WCTE/WCTE_mPMT_mechanical/mPMT Assembly Interference/Photos/new pillar.PNG

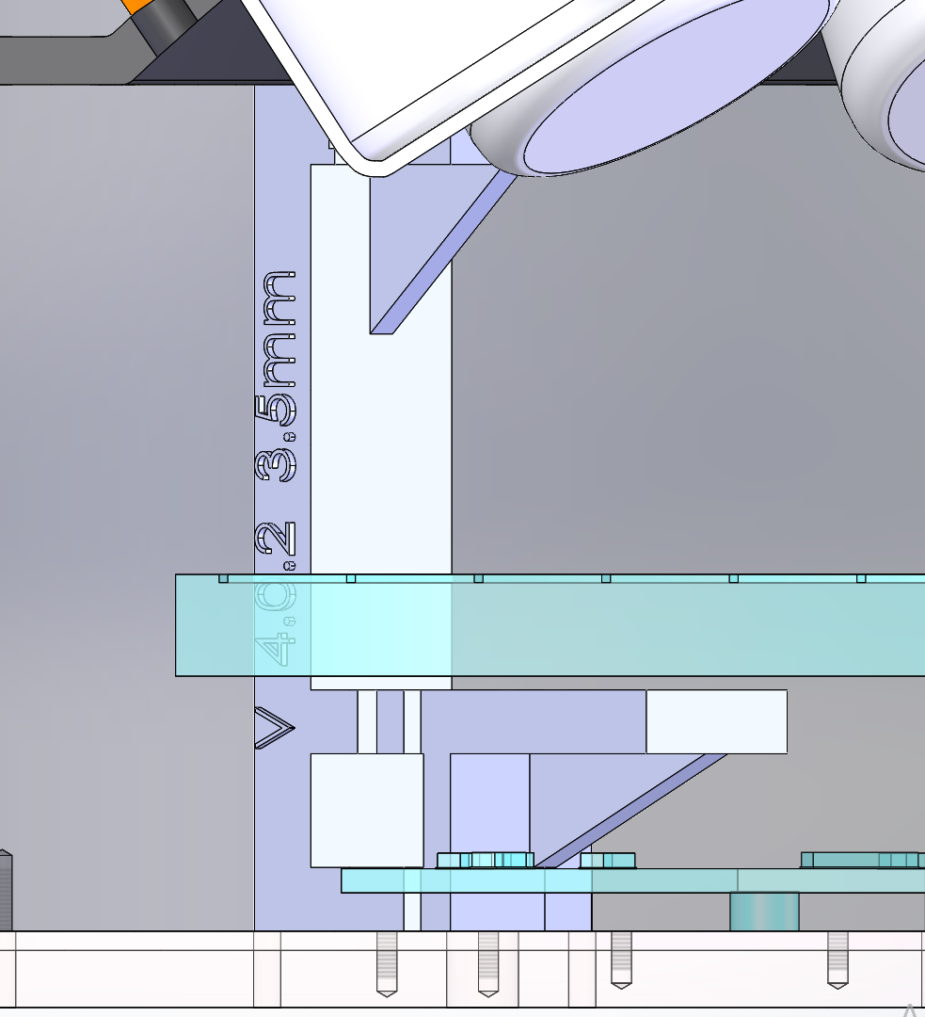
mPMT Assembly Interference/Photos/new pillar.PNG
