WCTE/WCTE_mPMT_mechanical/mPMT Assembly Interference/Photos/Interference new ideal.PNG

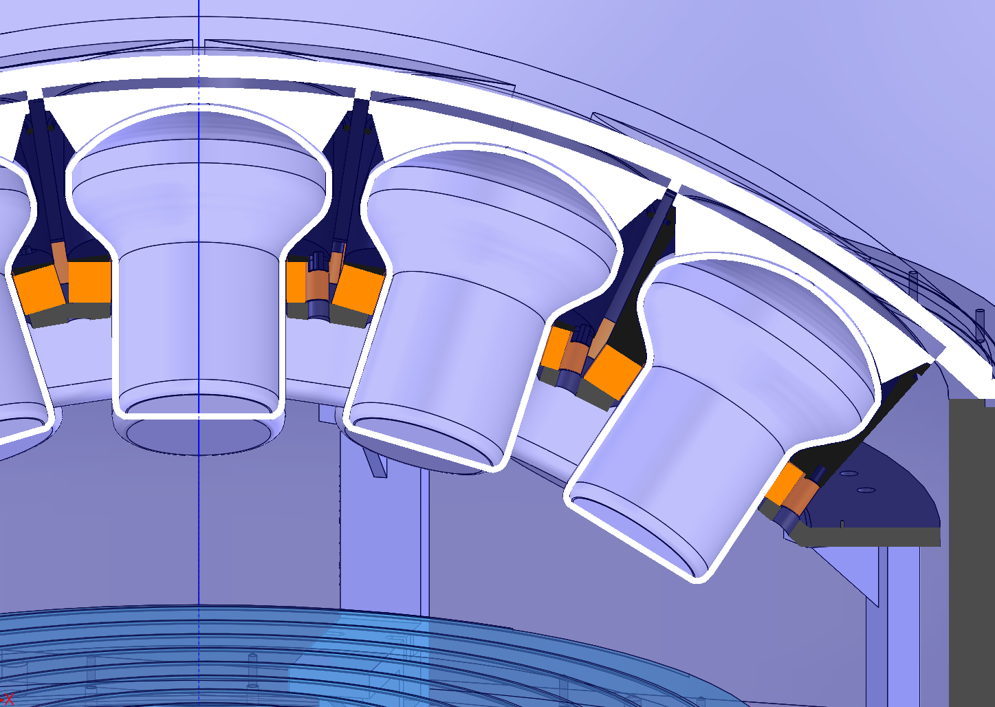
mPMT Assembly Interference/Photos/Interference new ideal.PNG
