WCTE/WCTE_mPMT_mechanical/Feedthrough with M12 connector/readme.md

Improved feedthrough in December 2022. Added a support, a piece of PCB and a M12 connector to the cable. Added an elbow pipe to the backplate of mPMT and redid the M45x3 threads

In this folder you can find the SW parts, SW assembly, a pack-and-go assembly, and a step file.
