WCTE/WCTE_mPMT_mechanical/Quality Control/PMT QC/readme.md

In this folder, you can find parts, assembly, and a pack-and-go .zip of PMT qc.
