WCTE/WCTE_mPMT_mechanical/Dome + Cylinder Lowering Fixture/Dome + Cylinder Lowering Fixture Notes.docx

April 8, 2021

This dome & cylinder lowering fixture is an alternate fixture design for lowering the dome onto the PMTs. In this design, the acrylic dome would first be screwed down onto the PVC cylinder, and now attached acrylic dome and PVC cylinder assembly would be lowered on the PMTs. The lowering mechanism is the same as the current dome lowering jig where turning each of the 4 screws by a quarter turn lowers the assembly by screw threads. This design is intended to be a more robust solution to achieve a better vertical lowering action and removes potential complications from the current dome lowering jig.

TDE2871 are clamp rings that clamp around the PVC cylinder and allow the user to lower the assembly onto TDE2872. TDE2872 are spacer blocks for the assembly to first sit flat and parallel to the stainless steel backplate. Once that is achieved, the 4 wing screws are turned until they make contact with the backplate and support the assembly ever so slightly. The TDE2872 are then removed, and the whole assembly can be lowered by turning the 4 wing screws a quarter turn each.

For this fixture to be made, part drawings for TDE2871 and TDE2872 need to be created and sent to machine shop, and all mechanical hardware needs to be sourced.
