WCTE/WCTE_mPMT_mechanical/Reflector Sheet/Reflector_Diagrams.pdf

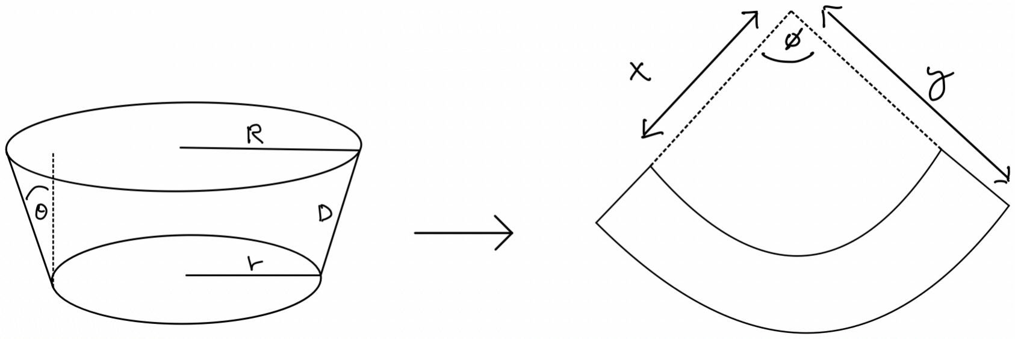
[picture p3: figure]
