WCTE/WCTE_mPMT_mechanical/Gelling Jig Tabbed/Capture2.PNG

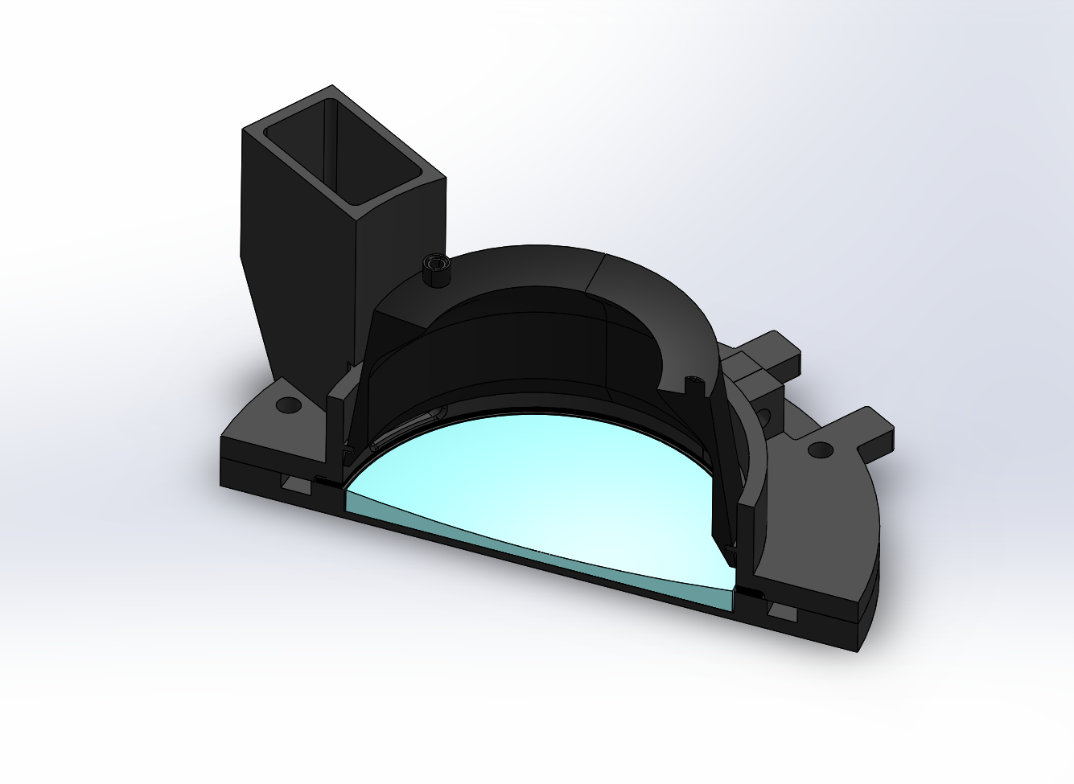
Gelling Jig Tabbed/Capture2.PNG
