WCTE/WCTE_mPMT_mechanical/Gelling Jig Tabbed/Capture3.PNG

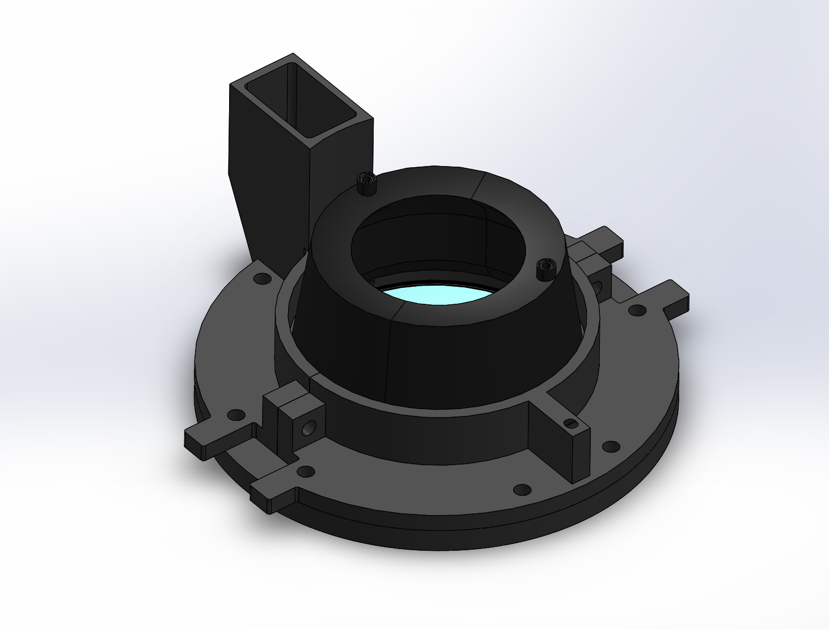
Gelling Jig Tabbed/Capture3.PNG
