WCTE/WCTE_mPMT_mechanical/Gelling Jig Tabbed/Capture4.PNG

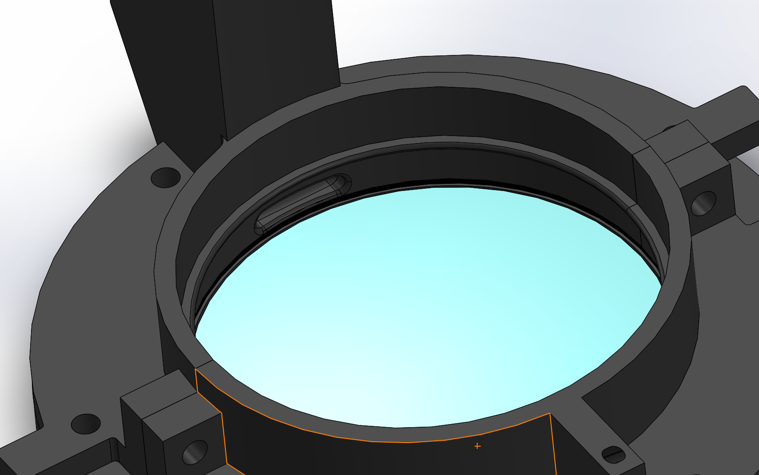
Gelling Jig Tabbed/Capture4.PNG
