WCTE/WCTE_mPMT_mechanical/Gelling Jig Tabbed/Capture5.PNG

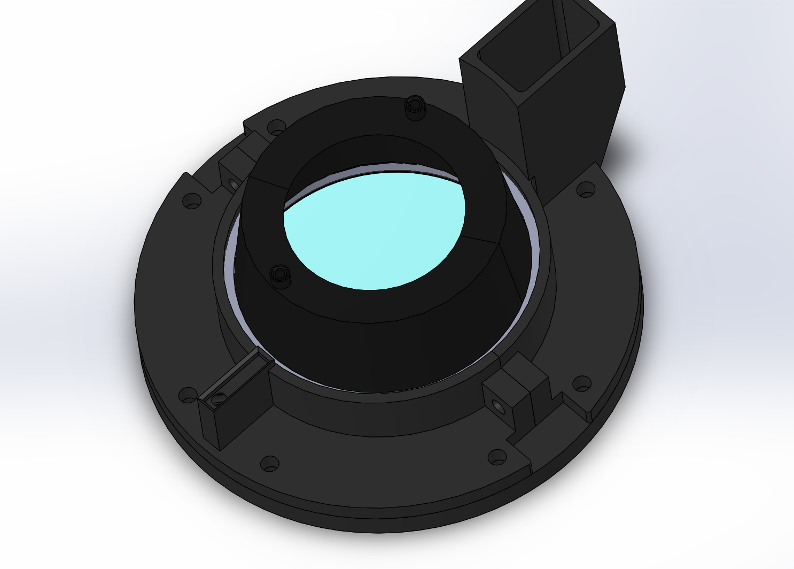
Gelling Jig Tabbed/Capture5.PNG
