WCTE/WCTE_mPMT_mechanical/Gelling Jig Tabbed/Capture6.PNG

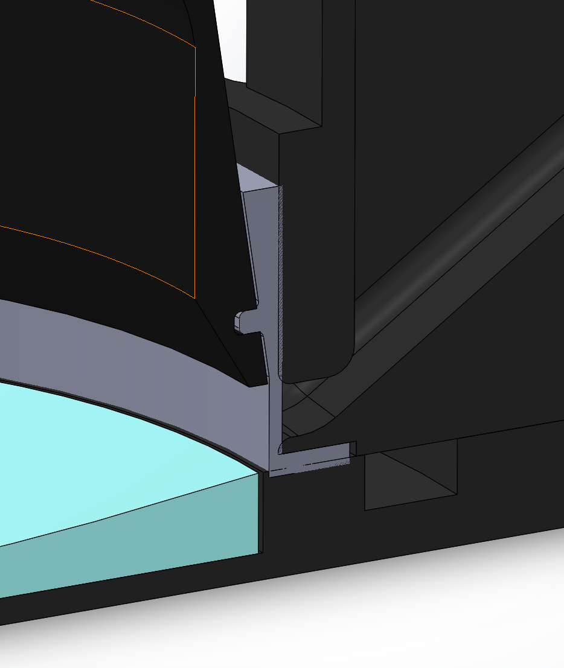
Gelling Jig Tabbed/Capture6.PNG
