WCTE/WCTE_mPMT_mechanical/Gelling Jig Tabbed/Capture7.PNG

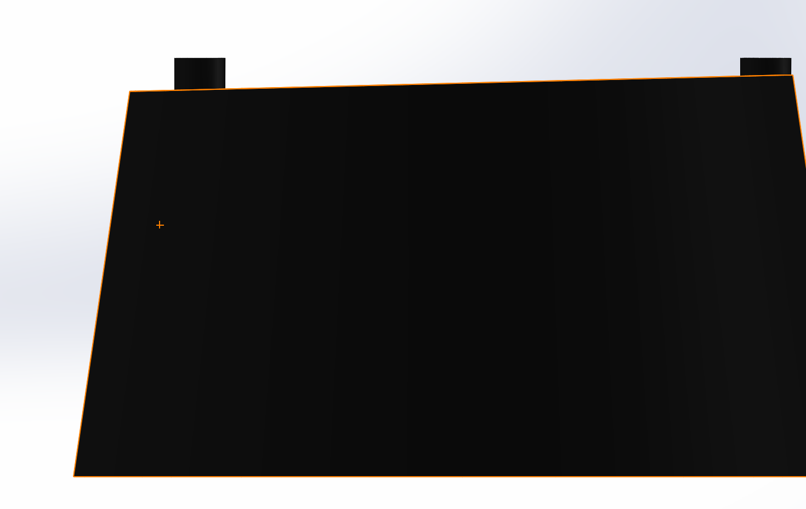
Gelling Jig Tabbed/Capture7.PNG
