WCTE/WCTE_mPMT_mechanical/Gelling Jig Tabbed/Capture.PNG

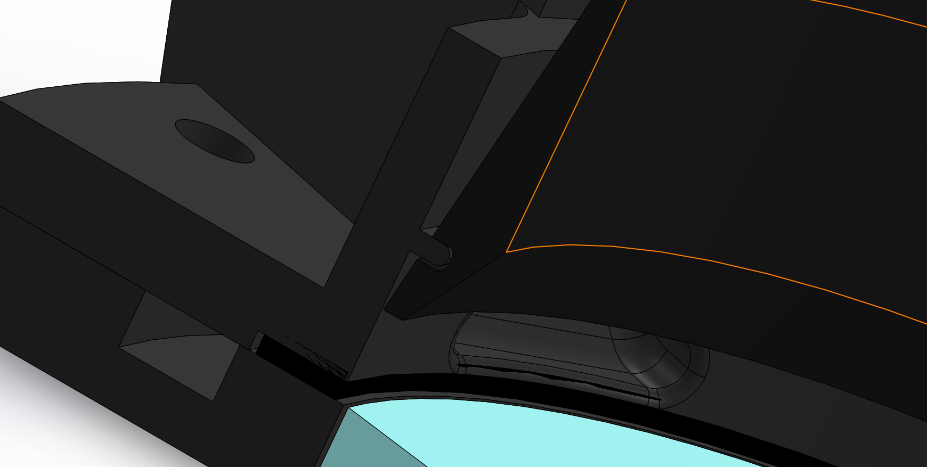
Gelling Jig Tabbed/Capture.PNG
