WCTE/WCTE_mPMT_mechanical/mPMT Assembly Interference/mPMT Assembly faceted actual dimensions.SLDASM

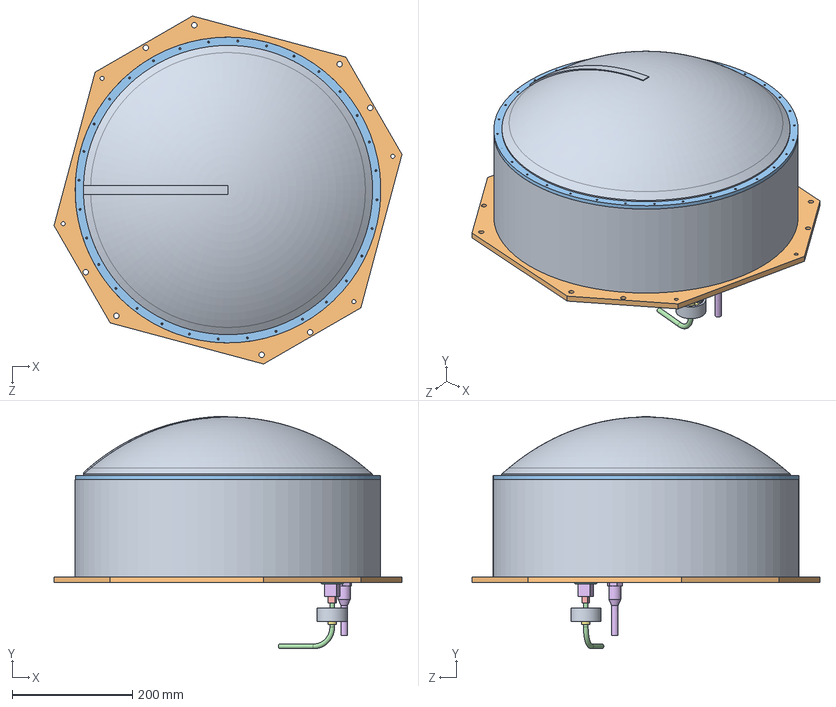
[picture p11: CAD file, 2022-08-09]
mPMT Assembly Interference/mPMT Assembly faceted actual dimensions.SLDASM
578.3 x 386.4 x 578.3 mm
XDE2411
XDE2431
PCB_connector x 20
PCB_SMAport x 2
PCB_FPGA x 5
PCB_SFP
PCB_connector2 x 2
Board^PCB_centralEnclustraModule
central block^PCB_centralEnclustraModule
PCB_standoff x 4
PCB_centralConnector x 3
IWCD_PL_RJ45_Male
IWCD_PL_CRE-CA1184-MGA
Outer Flange
Feed Through Connector Assembly Weld
Flange Cover
End Cap x 2
Adhesive
Bent Cable
RJ-45 Male Port
RJ-45 Female Port
Inner Cable
IWCD_PL_Scintillator_SC
shorter pillar 3.5mm x 6
Shubham Matrix Improved_4.1-01
outer cup rev5 x 12
Optical_gel x 19
Hollow PMT rev 2 x 19
poron progress rev 4 x 19
central cup rev5 x 7
Corrected_Actual_Dome
