WCTE/WCTE_mPMT_mechanical/mPMT Assembly/mPMT Assembly Dec. 2022/PMT outer rev8.SLDASM

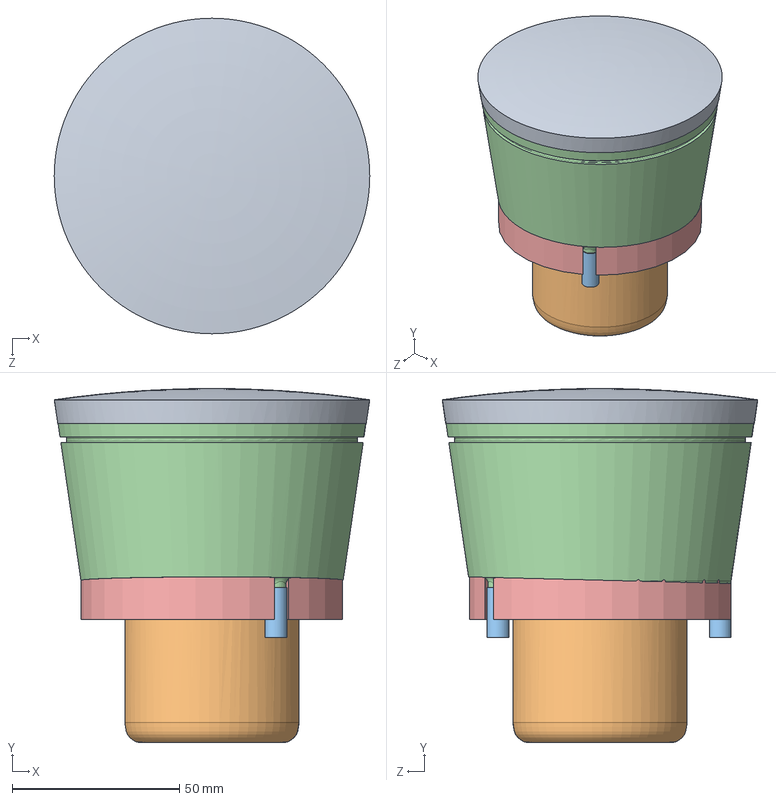
[picture p12: CAD file, 2022-12-23]
mPMT Assembly/mPMT Assembly Dec. 2022/PMT outer rev8.SLDASM
94.4 x 105.9 x 94.4 mm
Optical_gel
Hollow PMT rev 2
Pins_long_v5_15mm x 2
outer cup rev8
poron progress rev 4
