WCTE/WCTE_mPMT_mechanical/Pressure Tester/PCB box assembly.SLDASM

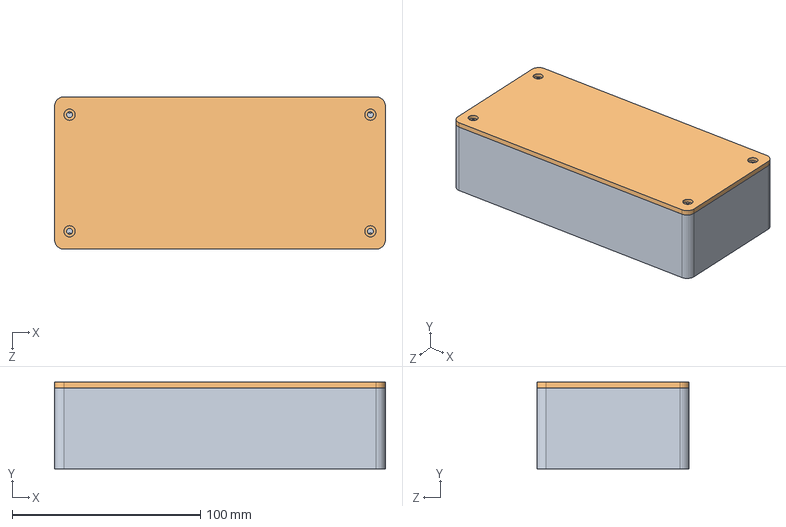
[picture p14: CAD file, 2022-07-28]
Pressure Tester/PCB box assembly.SLDASM
176.0 x 46.0 x 81.0 mm
PCB Box
PCB board
