WCTE/WCTE_mPMT_mechanical/Quality Control/PMT QC/PMT QC.SLDASM

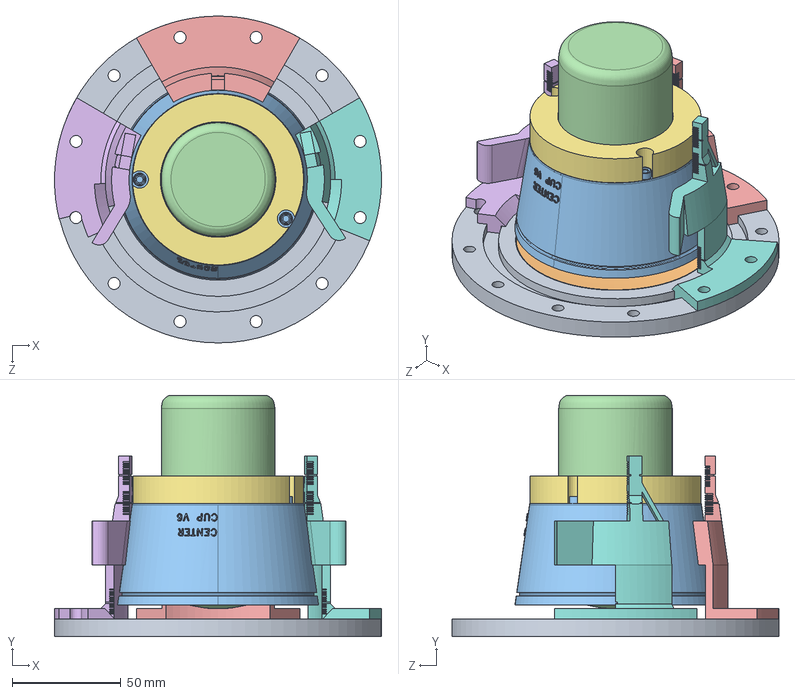
[picture p15: CAD file, 2022-12-23]
Quality Control/PMT QC/PMT QC.SLDASM
150.1 x 110.8 x 150.0 mm
BottomMould
AcrylicPlate
central cup rev6 (1)
Hollow PMT rev 2
back support
side clamp v2.0.0
poron progress rev 4
side clamp 2 R
