WCTE/WCTE_mPMT_mechanical/mPMT Assembly/mPMT Assembly Dec. 2022/mPMT assembly Dec.SLDASM

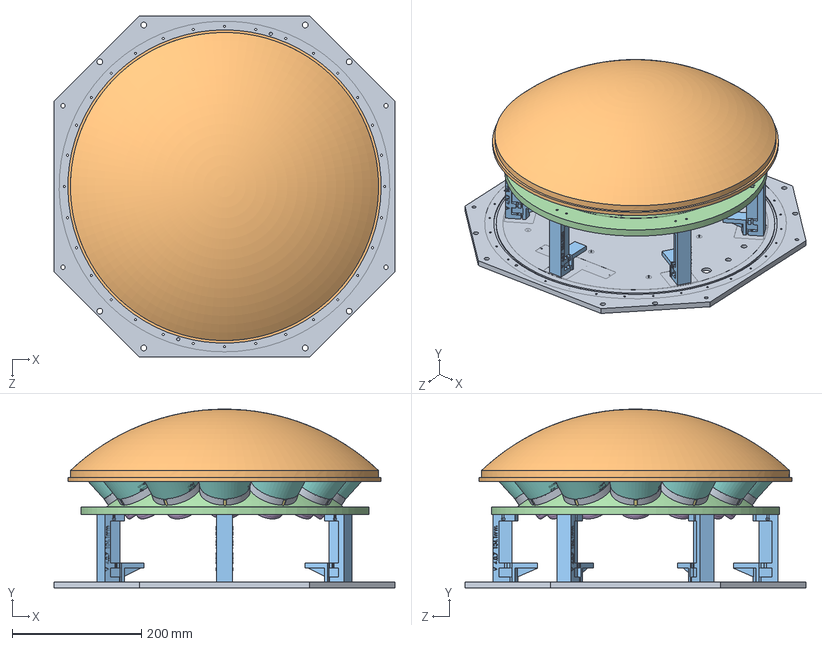
[picture p16: CAD file, 2022-12-23]
mPMT Assembly/mPMT Assembly Dec. 2022/mPMT assembly Dec.SLDASM
528.0 x 276.9 x 528.0 mm
XDE2411
XDE2432
shorter pillar 4.0.7 104.1mm x 6
Matrix Improved_4.5 fixed
Optical_gel x 19
Hollow PMT rev 2 x 19
Pins_long_v5_15mm x 38
outer cup rev8 x 12
poron progress rev 4 x 19
central cup rev7 x 7
