WCTE/WCTE_mPMT_mechanical/mPMT Assembly/mPMT Assembly Oct. 2022/mPMT Assembly_Oct_2022.SLDASM

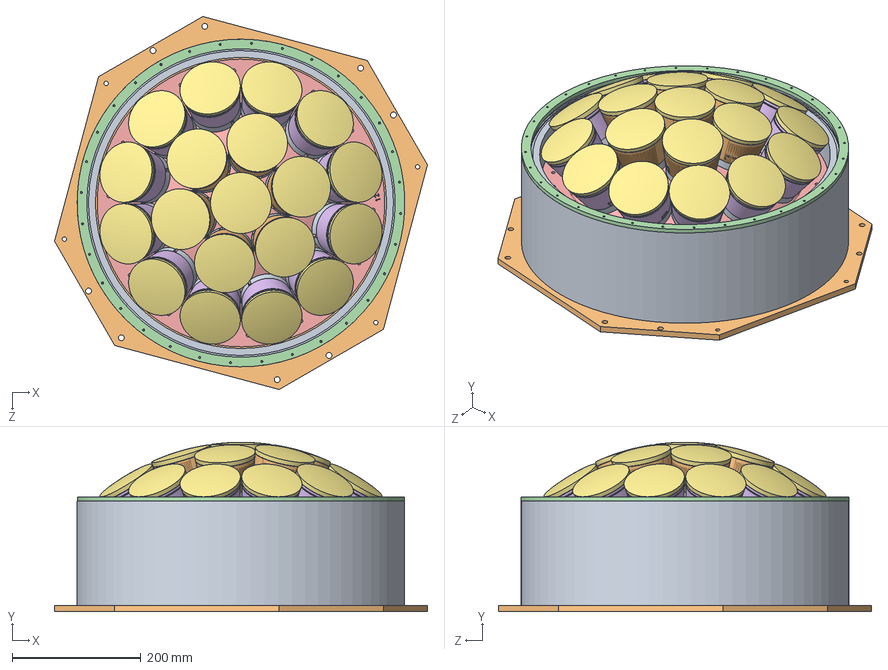
[picture p17: CAD file, 2022-10-26]
mPMT Assembly/mPMT Assembly Oct. 2022/mPMT Assembly_Oct_2022.SLDASM
578.3 x 262.7 x 578.3 mm
XDE2411
XDE2431
shorter pillar 4.0.6 101.1mm x 6
XDE2255
Matrix Improved_4.4
outer cup rev5 x 12
Optical_gel x 19
Hollow PMT rev 2 x 19
poron progress rev 4 x 19
central cup rev5 x 7
