WCTE/WCTE_mPMT_mechanical/mPMT Assembly/Pillars/Aluminum Pillars/2020 Pillar Assembly/2020 Pillar Assembly/20 20 assembly v2.SLDASM

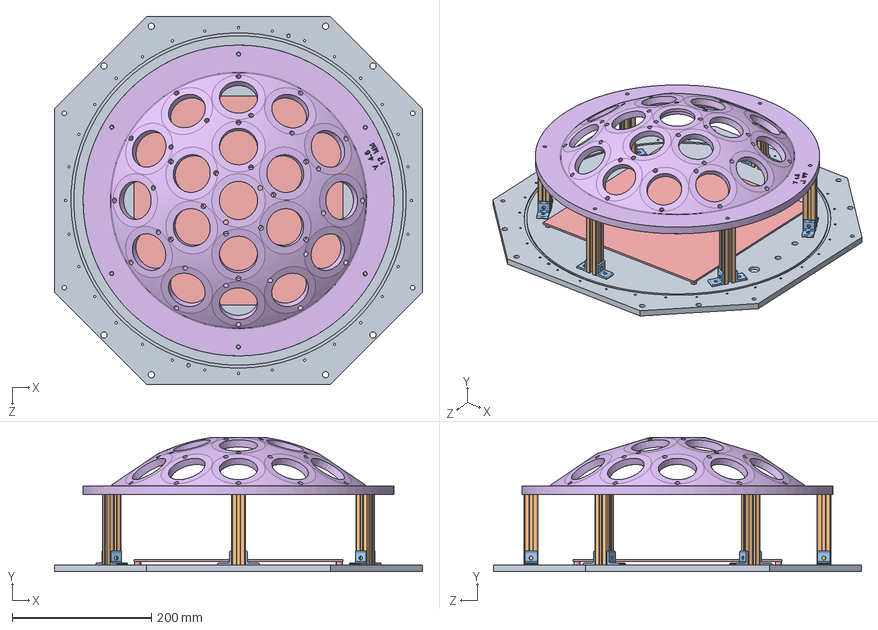
[picture p18: CAD file, 2022-12-22]
mPMT Assembly/Pillars/Aluminum Pillars/2020 Pillar Assembly/2020 Pillar Assembly/20 20 assembly v2.SLDASM
528.0 x 192.5 x 528.0 mm
backplate
20_2020_101_1_CL x 6
14122_m
PCB_board
Matrix Improved_4.6
