WCTE/WCTE_mPMT_mechanical/mPMT Assembly/mPMT Assembly Oct. 2022/Assembly Progress rev4.2.SLDASM

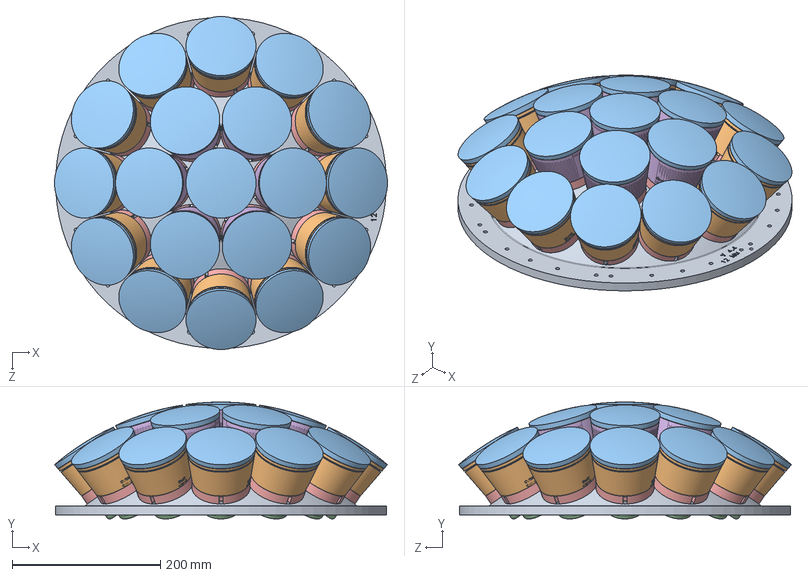
[picture p19: CAD file, 2022-10-26]
mPMT Assembly/mPMT Assembly Oct. 2022/Assembly Progress rev4.2.SLDASM
448.9 x 157.6 x 448.9 mm
Matrix Improved_4.4
outer cup rev5 x 12
Optical_gel x 19
Hollow PMT rev 2 x 19
poron progress rev 4 x 19
central cup rev5 x 7
