WCTE/WCTE_mPMT_mechanical/Reflector Sheet/Reflector assembly.SLDASM

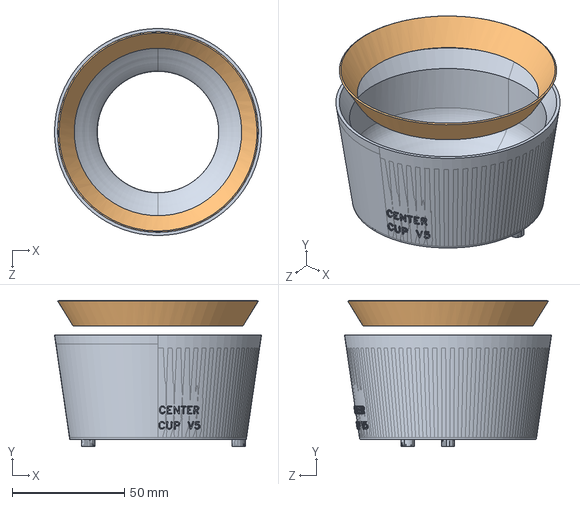
[picture p20: CAD file, 2022-08-09]
Reflector Sheet/Reflector assembly.SLDASM
92.4 x 65.3 x 92.4 mm
central cup rev5
Reflector cone
