WCTE/WCTE_mPMT_mechanical/Feedthrough with M12 connector/cable assem.SLDASM

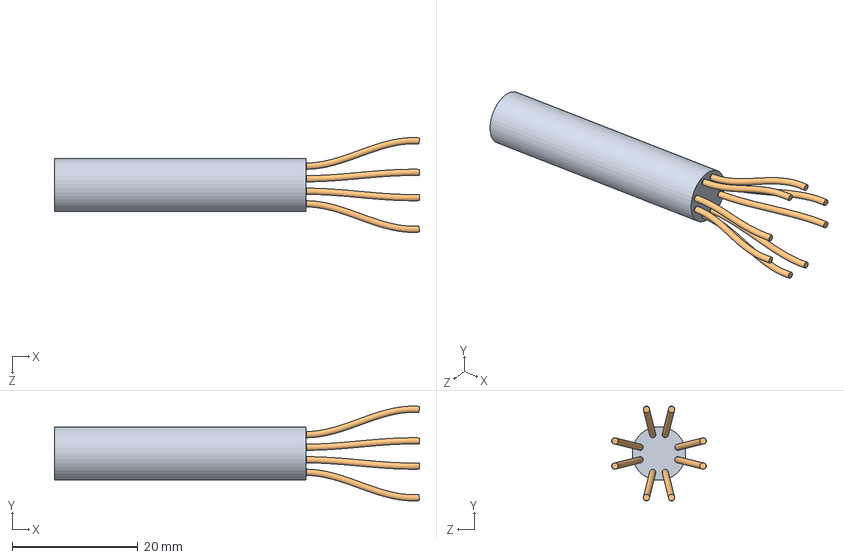
[picture p22: CAD file, 2022-12-23]
Feedthrough with M12 connector/cable assem.SLDASM
58.0 x 15.1 x 15.1 mm
cable
2 wires x 4
