WCTE/WCTE_mPMT_mechanical/mPMT_Test_Stand-Spring2020/ARDUINO DUE.SLDASM

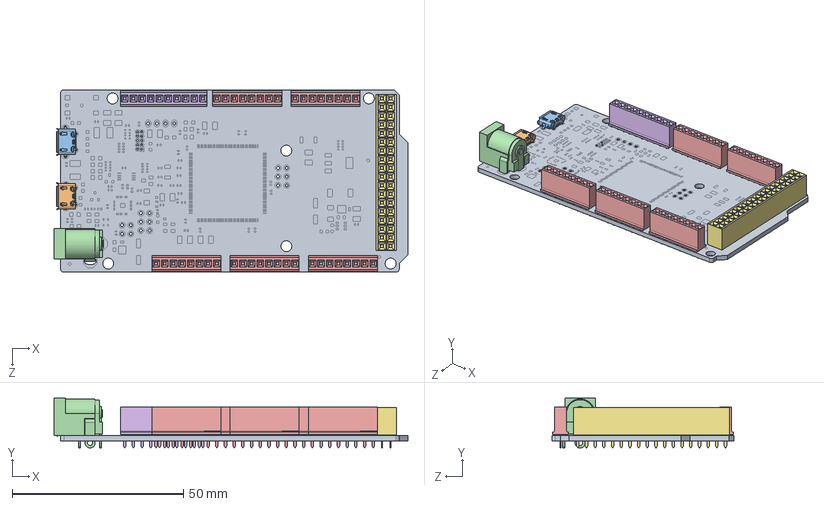
[picture p23: CAD file, 2022-05-10]
mPMT_Test_Stand-Spring2020/ARDUINO DUE.SLDASM
103.5 x 14.6 x 53.3 mm
PCB - Arduino
MicroUSB B - Hirose - ZX62D-B-5P8
MicroUSB AB - Hirose - ZX62D-AB-5P8
Power Jack - Kycon - KLDHCX-0202-A
Berg Header Receptacle 2.54 x 8 - FCI - 66951-008LF x 5
Berg Header Receptacle 2.54 x 10 - FCI - 66951-010LF
Berg Header Receptacle 2.54 x 36 - FCI - 66953-018LF
