WCTE/WCTE_mPMT_mechanical/mPMT Assembly/Assembly Progress rev4.1.SLDASM

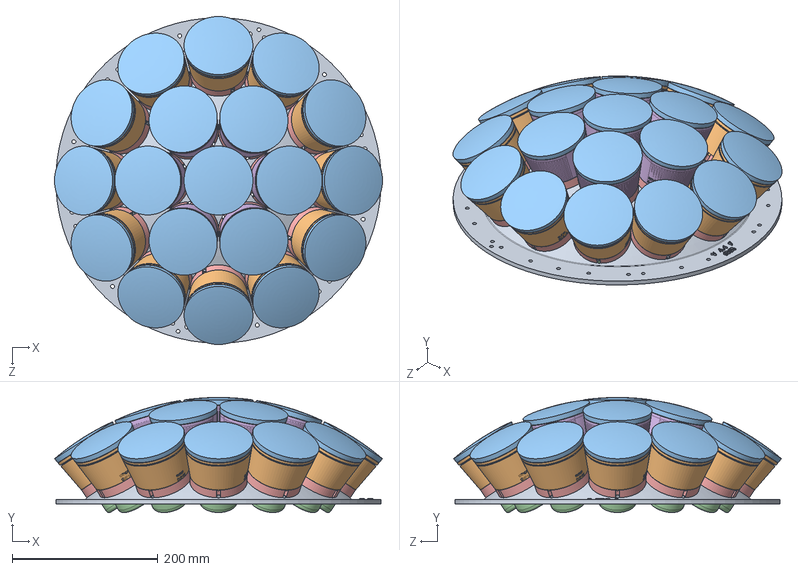
[picture p24: CAD file, 2022-08-09]
mPMT Assembly/Assembly Progress rev4.1.SLDASM
449.5 x 157.7 x 449.5 mm
Shubham Matrix Improved_4.1-01
outer cup rev5 x 12
Optical_gel x 19
Hollow PMT rev 2 x 19
poron progress rev 4 x 19
central cup rev5 x 7
