WCTE/WCTE_mPMT_mechanical/Feedthrough with M12 connector/pcb test.SLDASM

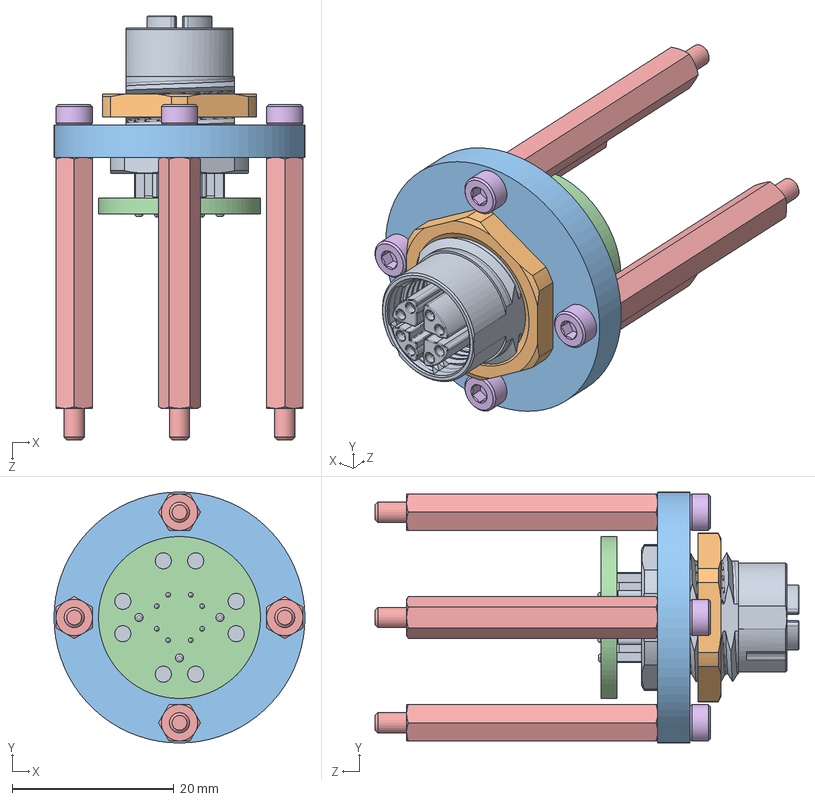
[picture p25: CAD file, 2022-12-23]
Feedthrough with M12 connector/pcb test.SLDASM
31.0 x 31.0 x 52.3 mm
BS-BF-HW-BUCHSE-CAT6A_SW0001.stp
415371.stp
support plate
PCB
93655A361_Male-Female Threaded Hex Standoff x 4
92290A058_Super-Corrosion-Resistant 316 Stainless Steel Socket Head Screw x 4
