WCTE/WCTE_mPMT_mechanical/Quality Control/Backplate QC/backplate check.SLDASM

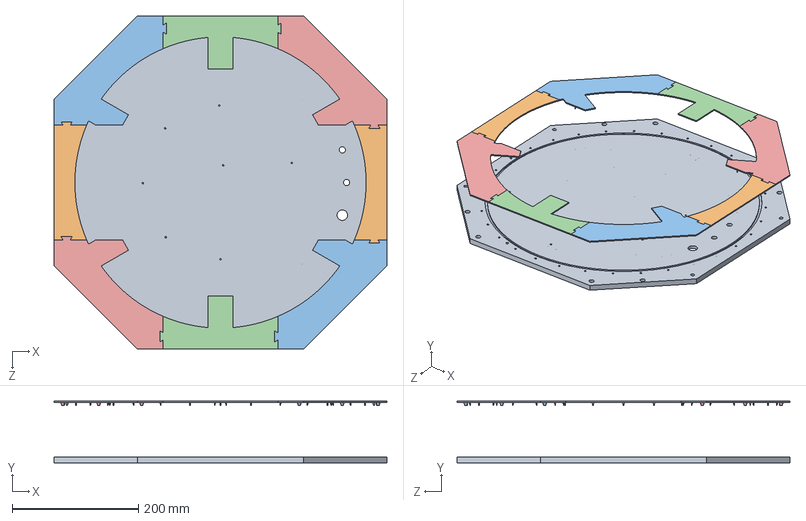
[picture p26: CAD file, 2022-12-23]
Quality Control/Backplate QC/backplate check.SLDASM
528.0 x 98.2 x 528.0 mm
XDE2411
backplate qc - middle piece a x 2
backplate qc - side piece a x 2
backplate qc - middle piece b x 2
backplate qc - side piece b x 2
