WCTE/WCTE_mPMT_mechanical/Assembly Guide/linear bearing guide.SLDASM

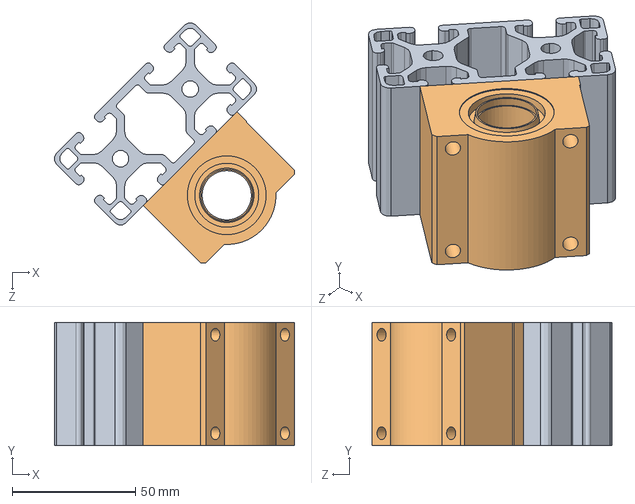
[picture p27: CAD file, 2022-12-22]
Assembly Guide/linear bearing guide.SLDASM
97.5 x 50.0 x 97.5 mm
40_4080_LITE_300_CL
8590N32_High-Load Mounted Linear Ball Bearing (1)
