WCTE/WCTE_mPMT_mechanical/Dome + Cylinder Lowering Fixture/TDE2870.SLDASM

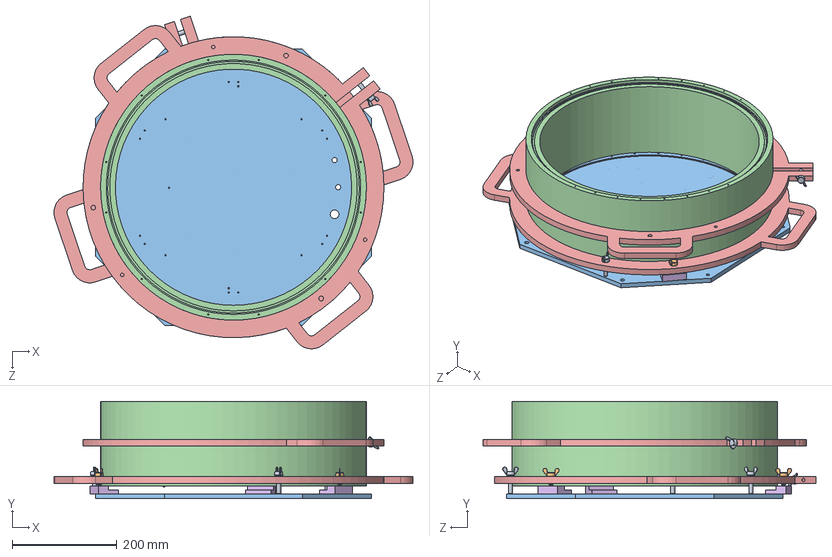
[picture p28: CAD file, 2022-05-10]
Dome + Cylinder Lowering Fixture/TDE2870.SLDASM
686.0 x 186.3 x 636.0 mm
92625A527_STAINLESS STEEL WING-HEAD THUMB SCREW x 5
92625A516_STAINLESS STEEL WING-HEAD THUMB SCREW x 3
XDE2411
XDE2431
TDE2871 x 2
TDE2872 x 3
