WCTE/WCTE_mPMT_mechanical/Quality Control/Backplate QC/ring test.SLDASM

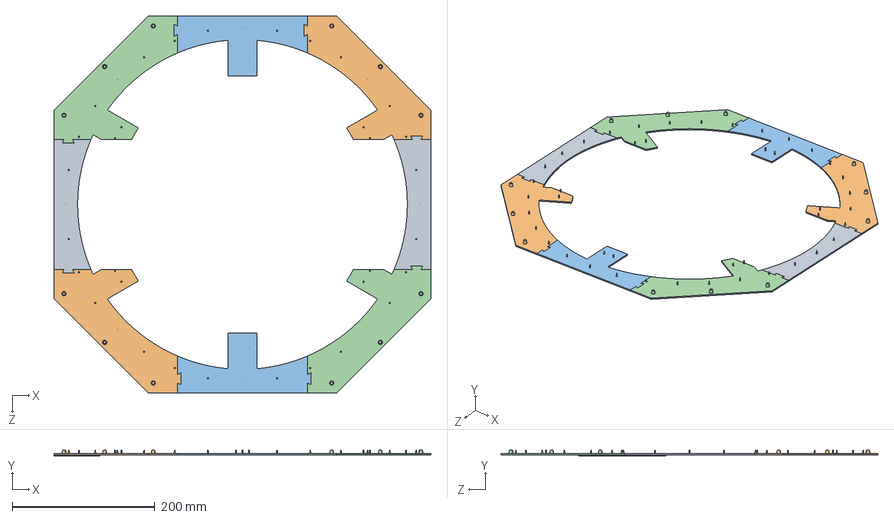
[picture p29: CAD file, 2022-12-23]
Quality Control/Backplate QC/ring test.SLDASM
528.0 x 8.00 x 528.0 mm
backplate qc - middle piece a x 2
backplate qc - side piece a x 2
backplate qc - middle piece b x 2
backplate qc - side piece b x 2
backplate qc - sheet
