WCTE/WCTE_mPMT_mechanical/Assembly Guide/guide base.SLDASM

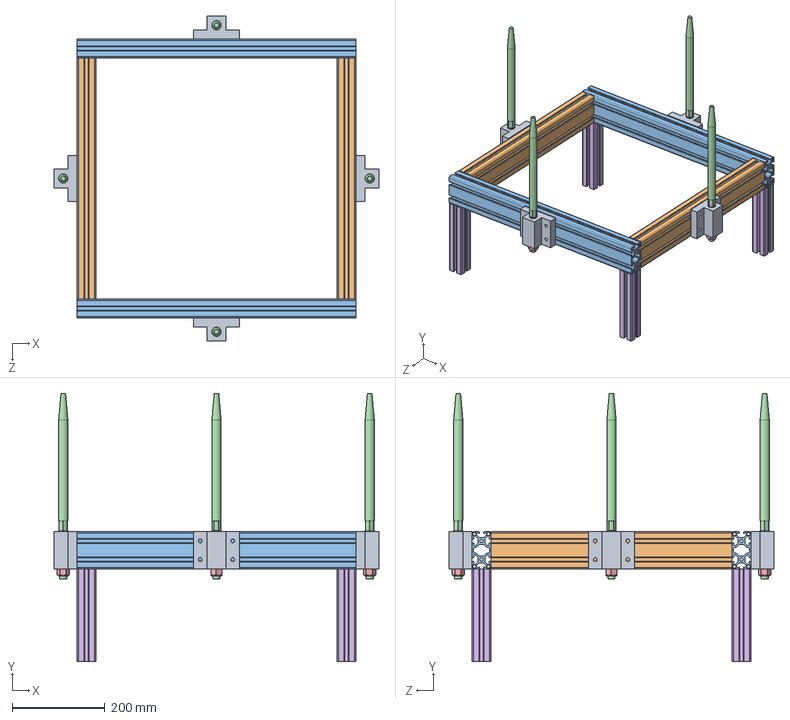
[picture p31: CAD file, 2022-12-22]
Assembly Guide/guide base.SLDASM
700.0 x 578.0 x 700.0 mm
rod fixture x 4
40_4080_LITE_480_CL x 2
40_4080_LITE_560_CL x 2
6459K62_Linear Motion Shaft x 4
94645A250_High-Strength Steel Nylon-Insert Locknut x 4
leg 200mm 40_4040_LITE_200_CL x 4
