WCTE/WCTE_mPMT_mechanical/mPMT Assembly/mPMT Assembly Oct. 2022/Feed Through Connector Assembly Weld.SLDPRT

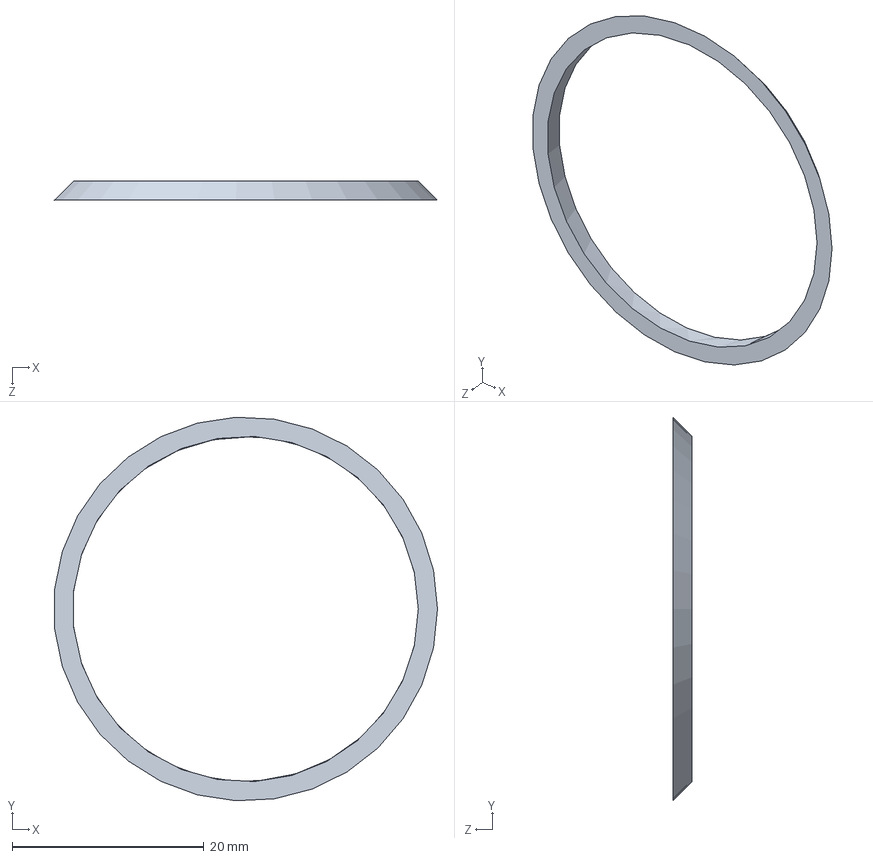
[picture p32: CAD file, 2022-10-26]
mPMT Assembly/mPMT Assembly Oct. 2022/Feed Through Connector Assembly Weld.SLDPRT
39.9 x 39.9 x 2.00 mm
