WCTE/WCTE_mPMT_mechanical/mPMT Assembly/Pillars/Aluminum Pillars/2020 Pillar Assembly Temporary/2020 Pillar Assembly Temporary.SLDASM

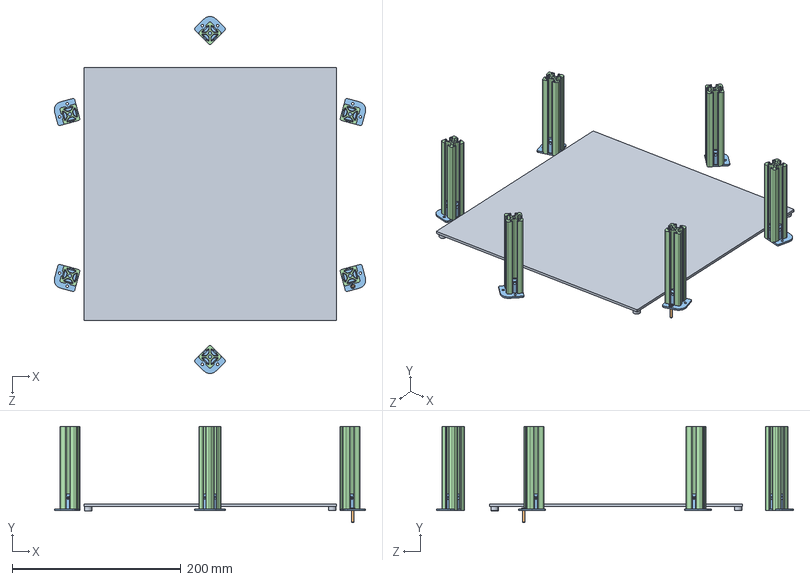
[picture p34: CAD file, 2022-12-23]
mPMT Assembly/Pillars/Aluminum Pillars/2020 Pillar Assembly Temporary/2020 Pillar Assembly Temporary.SLDASM
369.7 x 114.0 x 423.7 mm
PCB_boardv3
91290A119_Alloy Steel Socket Head Screw
pillar bottom fixture - 107mm x 6
5537T9_T-Slotted Framing x 6
