WCTE/WCTE_mPMT_mechanical/Assembly Guide/Assem_IWCD_R14374_SC.SLDASM

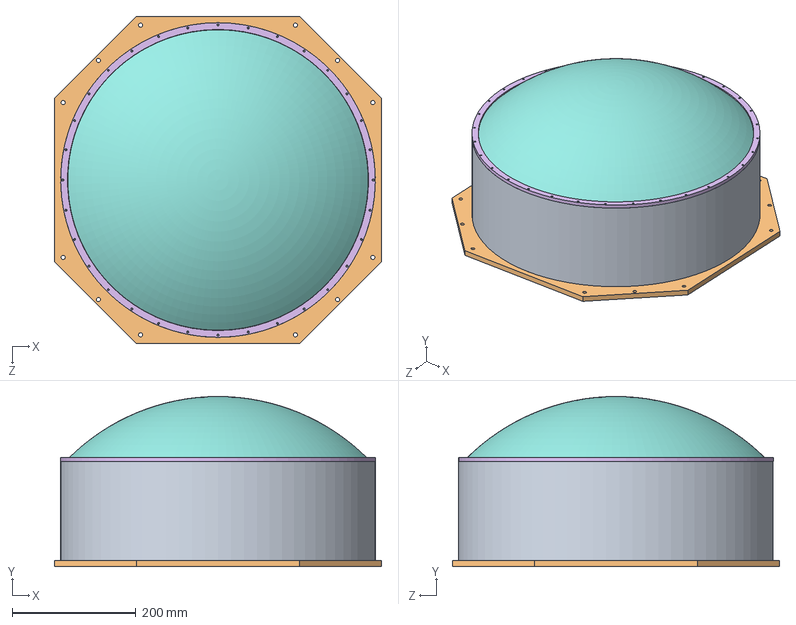
[picture p35: CAD file, 2022-12-22]
Assembly Guide/Assem_IWCD_R14374_SC.SLDASM
528.0 x 274.6 x 528.0 mm
PMT_mPMT_R14374_SC x 19
reflector_mPMT_R14374_SC x 19
gel_mPMT_R14374_SC x 19
round_poron_mPMT_R14374_SC x 19
round_cup_mPMT_R14374_SC x 19
94981A160_HEAVY DUTY SIDE-MOUNT EXTERNAL RETAINING RING x 38
round_matrix_6mm_mPMT_R14374_SC
Dome_mPMT_SC
Outer_Cylinder_mPMT_SC
XDE2411
IWCD_PL_Scintillator_SC
pillar_6mmMatrix_mPMT_R14374_SC x 6
mPMT_PCB_board_SC
IWCD_PL_clampRing_SC
