WCTE/WCTE_mPMT_mechanical/Assembly Guide/assembly ring.SLDPRT

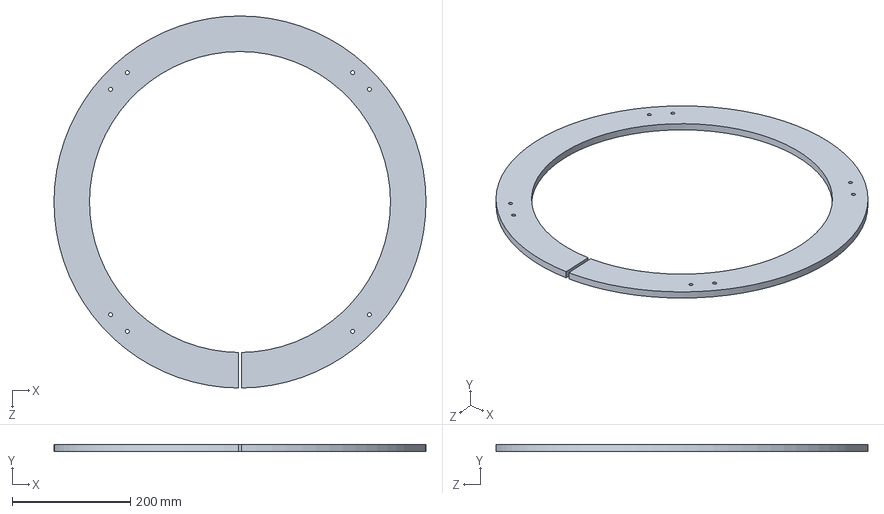
[picture p36: CAD file, 2022-12-22]
Assembly Guide/assembly ring.SLDPRT
628.0 x 12.0 x 628.0 mm
