WCTE/WCTE_mPMT_mechanical/Feedthrough with M12 connector/new feedthrough.SLDASM

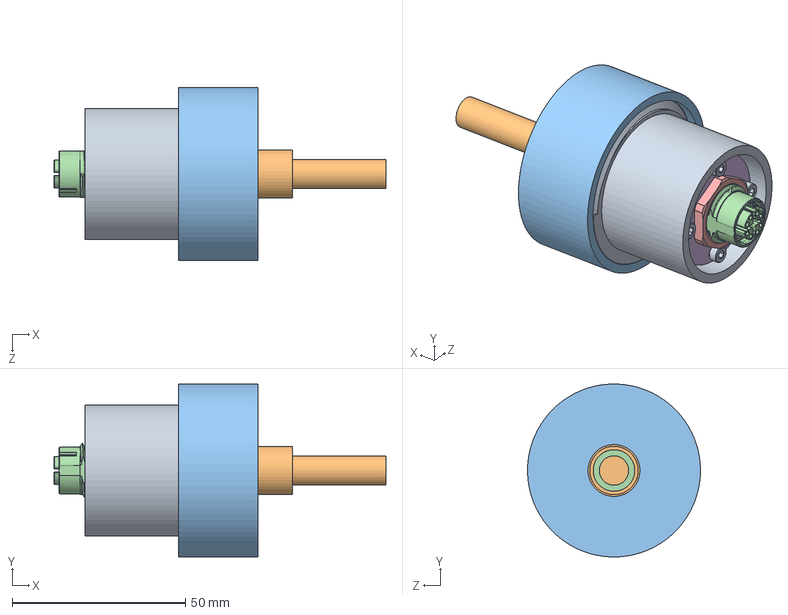
[picture p37: CAD file, 2022-12-23]
Feedthrough with M12 connector/new feedthrough.SLDASM
95.9 x 50.0 x 50.0 mm
outer flange
flange cover
BS-BF-HW-BUCHSE-CAT6A_SW0001.stp
415371.stp
support plate
PCB
93655A361_Male-Female Threaded Hex Standoff x 4
92290A058_Super-Corrosion-Resistant 316 Stainless Steel Socket Head Screw x 4
cable
2 wires x 4
end cap x 2
