WCTE/WCTE_mPMT_mechanical/Gelling Jig Tabbed/GellingRigAssembly - Flanged Gasket.SLDASM

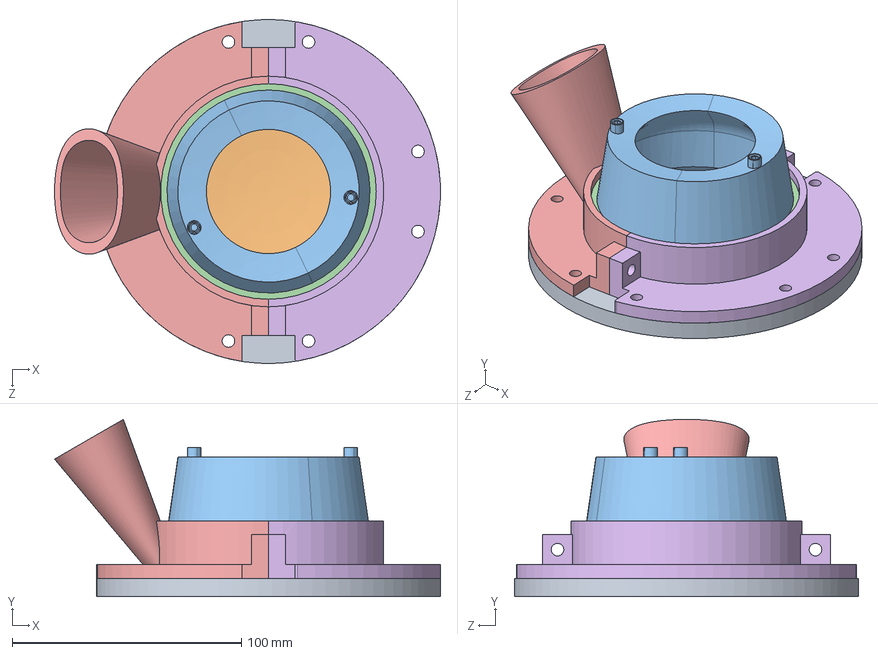
[picture p38: CAD file, 2022-08-09]
Gelling Jig Tabbed/GellingRigAssembly - Flanged Gasket.SLDASM
168.3 x 77.3 x 150.0 mm
BottomMould
AcrylicPlate
central cup rev4
Flange Gasket
TopMouldLeft - Flanged Gasket
TopMouldRight - Flanged Gasket
