WCTE/WCTE_mPMT_mechanical/mPMT Assembly/Assembly of PMT centre v3.SLDASM

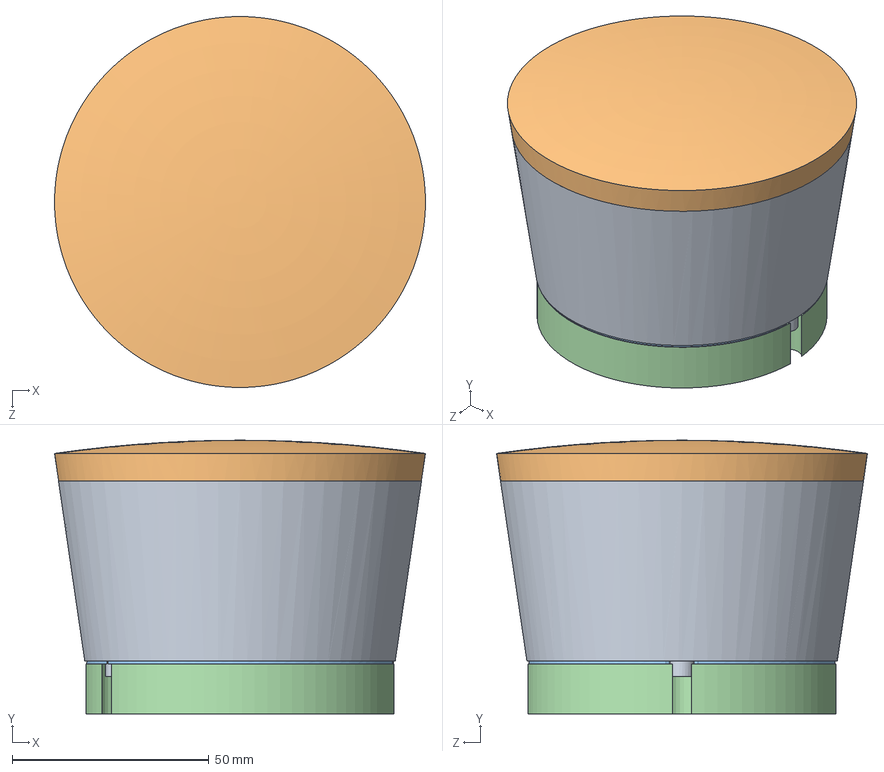
[picture p39: CAD file, 2022-05-24]
mPMT Assembly/Assembly of PMT centre v3.SLDASM
94.4 x 69.6 x 94.4 mm
cup progress rev4
Optical_gel
Poron_Top_Adaptor
poron progress rev 4
