WCTE/WCTE_mPMT_mechanical/mPMT Assembly/mPMT Assembly Oct. 2022/Assem_IWCD_PL_Penetrator.sldasm

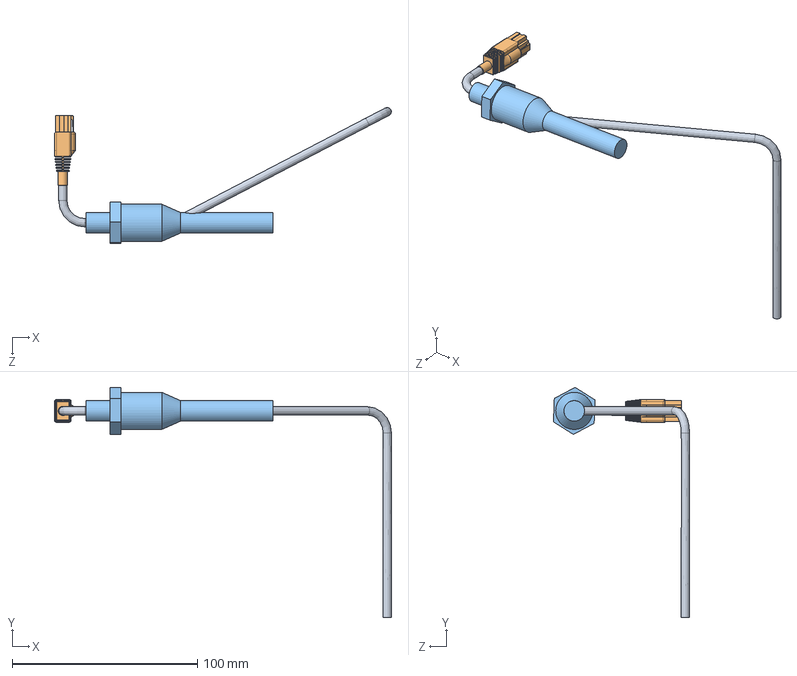
[picture p40: CAD file, 2022-10-26]
mPMT Assembly/mPMT Assembly Oct. 2022/Assem_IWCD_PL_Penetrator.sldasm
181.9 x 124.3 x 73.5 mm
Part2^Assem_IWCD_PL_Penetrator
IWCD_PL_RJ45_Male
IWCD_PL_CRE-CA1184-MGA
