WCTE/WCTE_mPMT_mechanical/mPMT Assembly/Assembly of PMT center v4.SLDASM

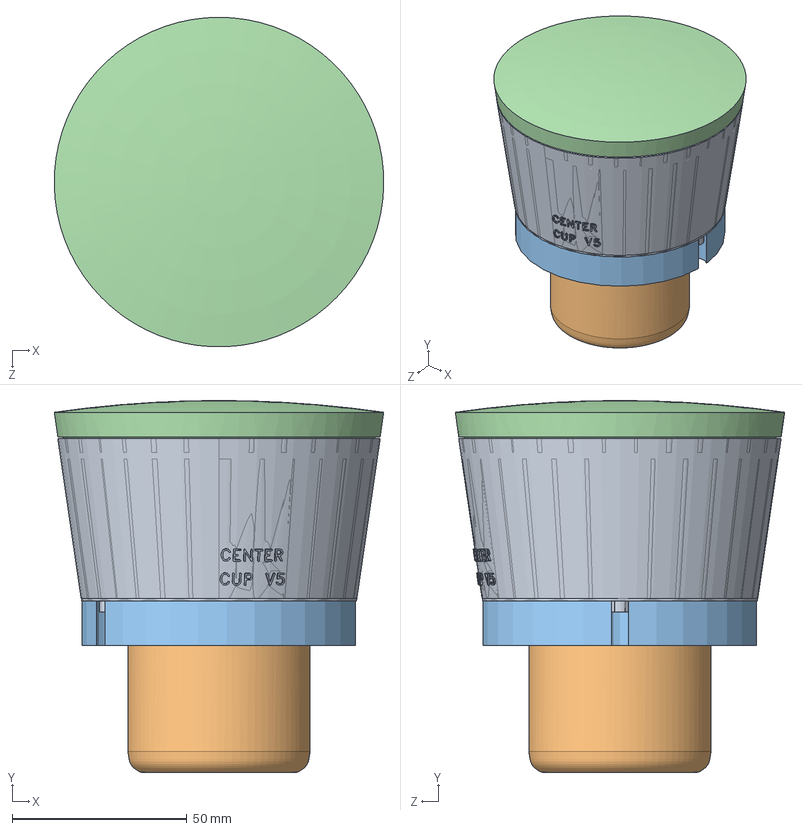
[picture p41: CAD file, 2022-05-18]
mPMT Assembly/Assembly of PMT center v4.SLDASM
94.4 x 106.6 x 94.4 mm
central cup rev5
Hollow PMT rev 2
poron progress rev 4
Optical_gel
