WCTE/WCTE_mPMT_mechanical/mPMT_Test_Stand-Spring2020/mPMT_Test_Stand_DoorV2.SLDASM

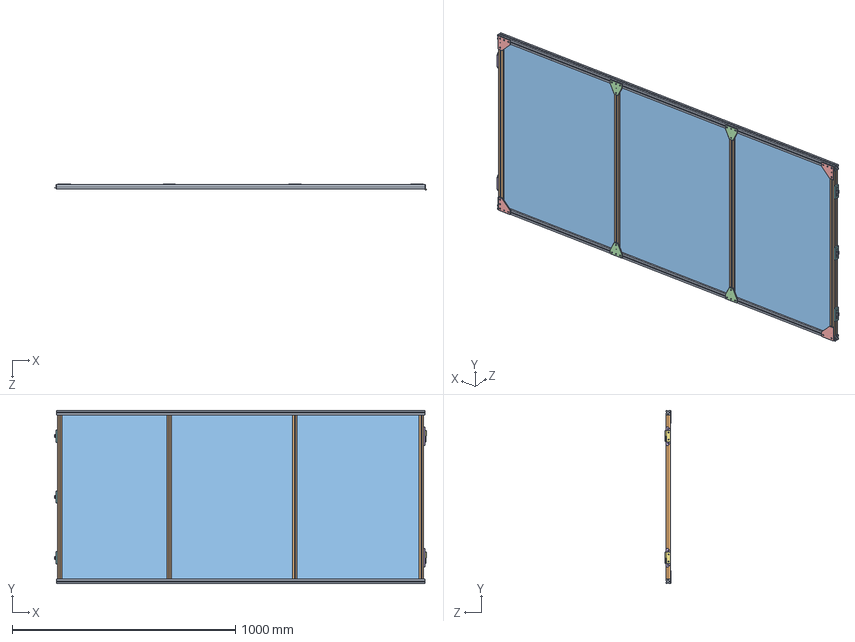
[picture p42: CAD file, 2022-05-10]
mPMT_Test_Stand-Spring2020/mPMT_Test_Stand_DoorV2.SLDASM
1667.1 x 776.6 x 28.9 mm
T_Slotted_Framing_20mm_Single_65in x 2
T_Slotted_Framing_20mm_Single_29in x 4
Dark_Box_Panel_DoorV2
5537T971_ALUMINUM T-SLOTTED FRAMING EXTRUSION x 4
5537T962_ALUMINUM T-SLOTTED FRAMING EXTRUSION x 4
HingeMountingPlate_DoorSide x 2
1151A610_SURFACE-MOUNT LIFT-OFF HINGE WITH HOLES x 2
LatchMount_DoorSide x 3
1734A120_EXTERNAL COMPRESSION SPRING DRAW LATCH x 3
