WCTE/WCTE_mPMT_mechanical/Quality Control/Matrix QC/center jig assembly.SLDASM

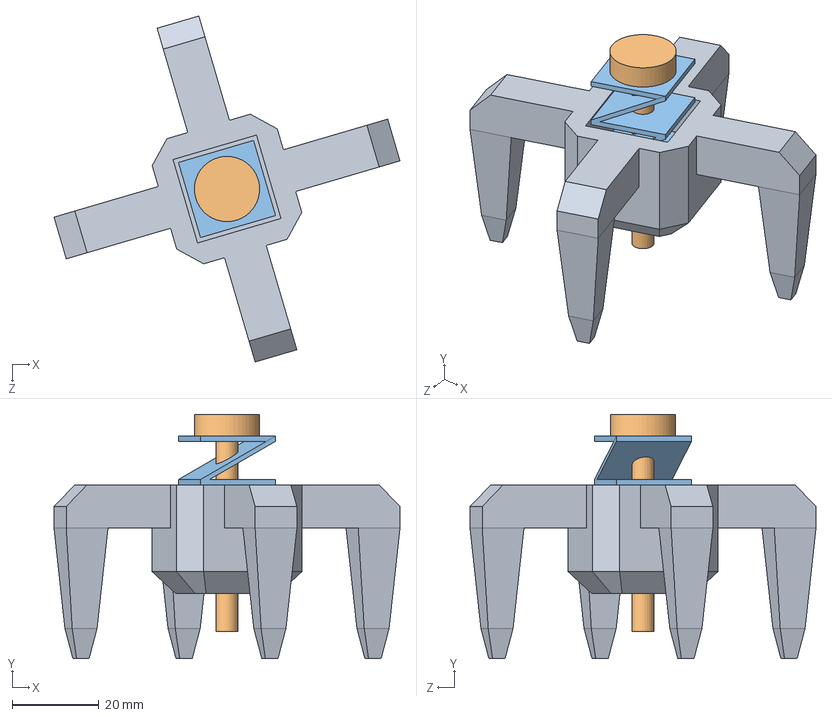
[picture p43: CAD file, 2022-12-23]
Quality Control/Matrix QC/center jig assembly.SLDASM
79.6 x 56.2 x 79.6 mm
centerpointjig v3.1 part2
screw
spring
