WCTE/WCTE_mPMT_mechanical/Feedthrough with M12 connector/M12 cable.SLDASM

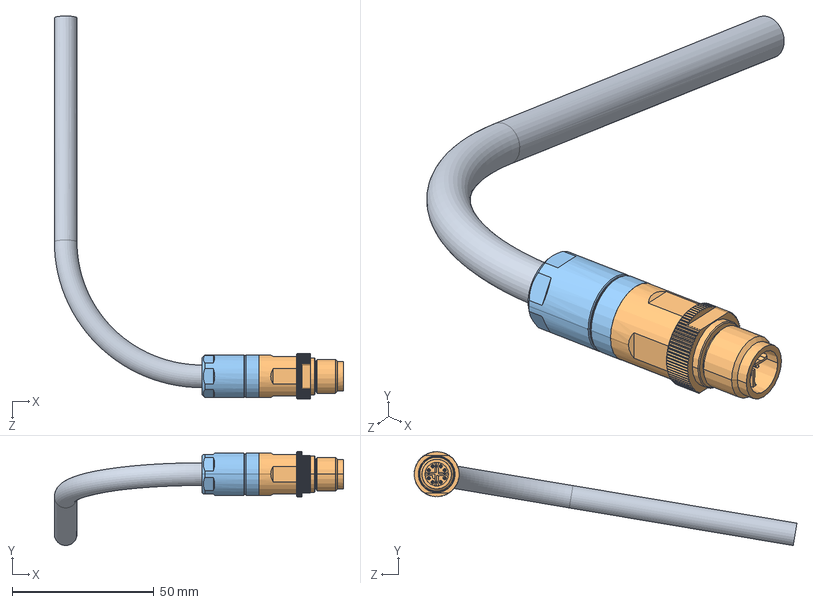
[picture p44: CAD file, 2022-12-23]
Feedthrough with M12 connector/M12 cable.SLDASM
101.9 x 33.1 x 134.9 mm
M12 cable a
M12 cable b
8mm cable v4
