WCTE/WCTE_mPMT_mechanical/mPMT Assembly/mPMT Assembly Oct. 2022/PMT RoC Test - Full.SLDPRT

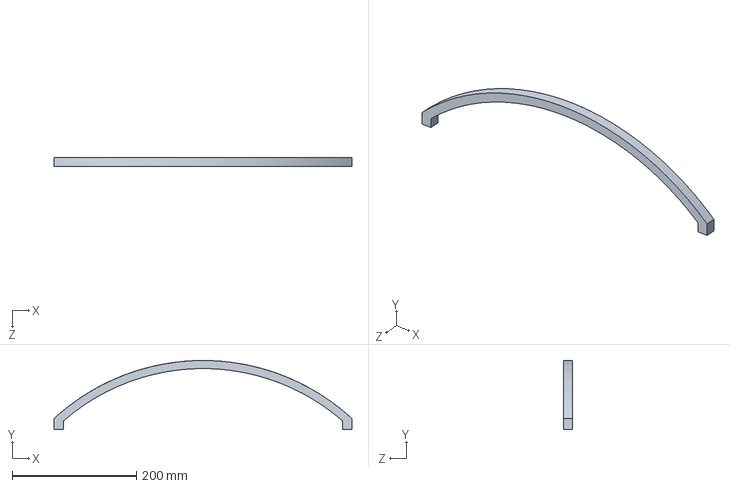
[picture p45: CAD file, 2022-10-26]
mPMT Assembly/mPMT Assembly Oct. 2022/PMT RoC Test - Full.SLDPRT
480.3 x 111.3 x 15.0 mm
