WCTE/WCTE_mPMT_mechanical/mPMT Assembly/Assembly Progress rev3_Simulaton.SLDASM

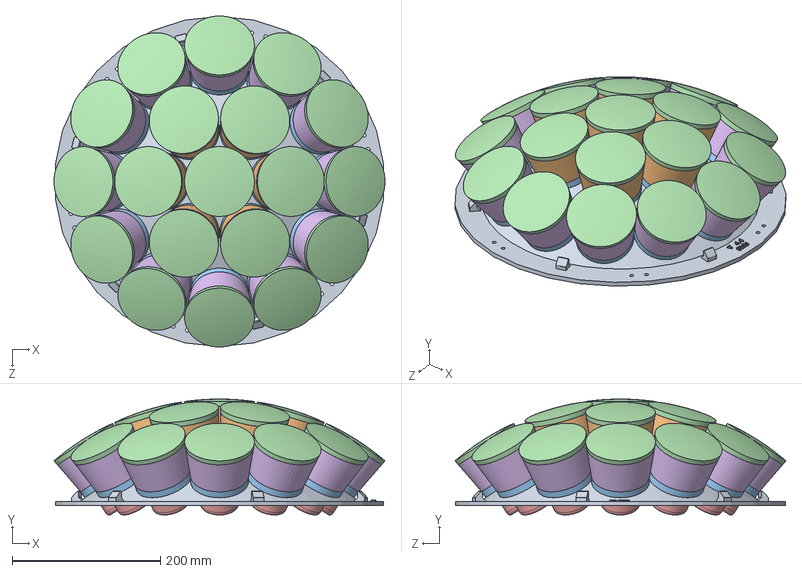
[picture p46: CAD file, 2022-05-10]
mPMT Assembly/Assembly Progress rev3_Simulaton.SLDASM
447.2 x 156.7 x 447.2 mm
Shubham Matrix Improved_4.1
cup progress rev4 x 7
poron progress rev 3 x 19
Optical_gel x 19
Hollow PMT rev 2 x 19
cup progress rev3 x 12
