WCTE/WCTE_mPMT_mechanical/Assembly Guide/cylinder with guide.SLDASM

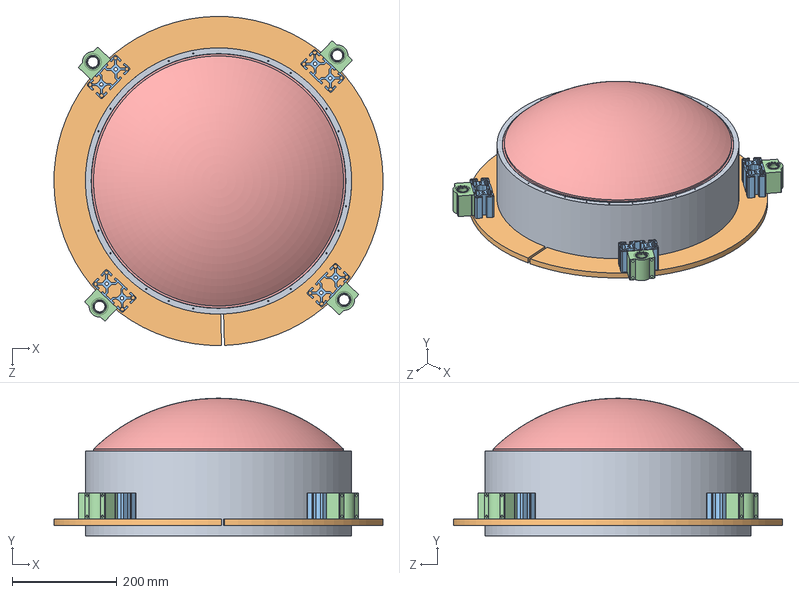
[picture p47: CAD file, 2022-12-22]
Assembly Guide/cylinder with guide.SLDASM
627.8 x 262.6 x 627.8 mm
assembly ring
40_4080_LITE_300_CL x 4
8590N32_High-Load Mounted Linear Ball Bearing (1) x 4
Dome
