WCTE/WCTE_mPMT_mechanical/mPMT Assembly/Assem_detailed_PCB_board.SLDASM

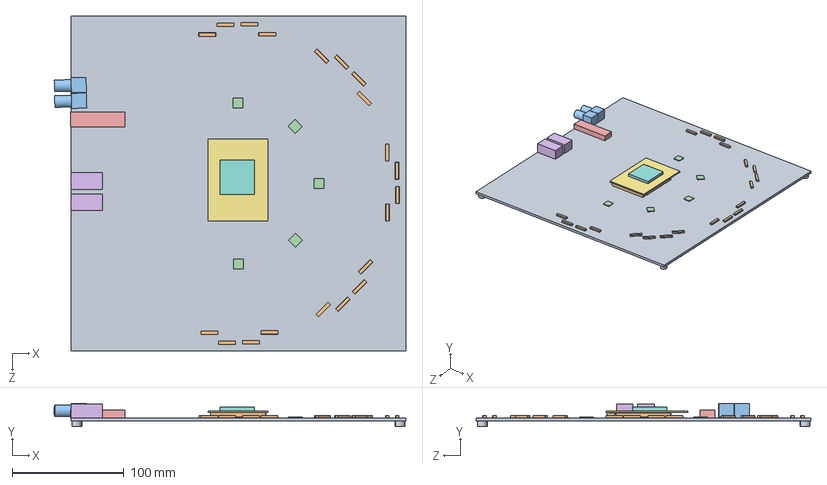
[picture p48: CAD file, 2022-05-10]
mPMT Assembly/Assem_detailed_PCB_board.SLDASM
314.8 x 21.0 x 300.0 mm
mPMT_PCB_board_SC
PCB_connector x 20
PCB_SMAport x 2
PCB_FPGA x 5
PCB_SFP
PCB_connector2 x 2
Board^PCB_centralEnclustraModule
central block^PCB_centralEnclustraModule
PCB_standoff x 4
PCB_centralConnector x 3
