WCTE/WCTE_mPMT_mechanical/Gelling Jig Tabbed/GellingRigAssembly.SLDASM

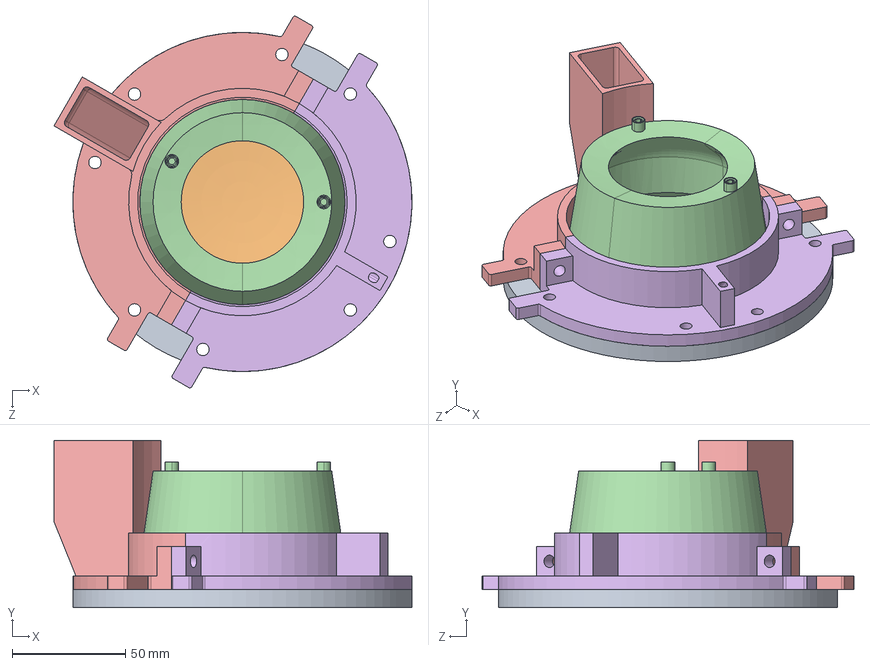
[picture p49: CAD file, 2022-05-10]
Gelling Jig Tabbed/GellingRigAssembly.SLDASM
158.3 x 74.0 x 164.4 mm
BottomMould
AcrylicPlate
Gasket
central cup rev4
TopMouldLeft
TopMouldRight
