WCTE/WCTE_mPMT_mechanical/mPMT Assembly/mPMT Assembly Oct. 2022/New Assembly.SLDASM

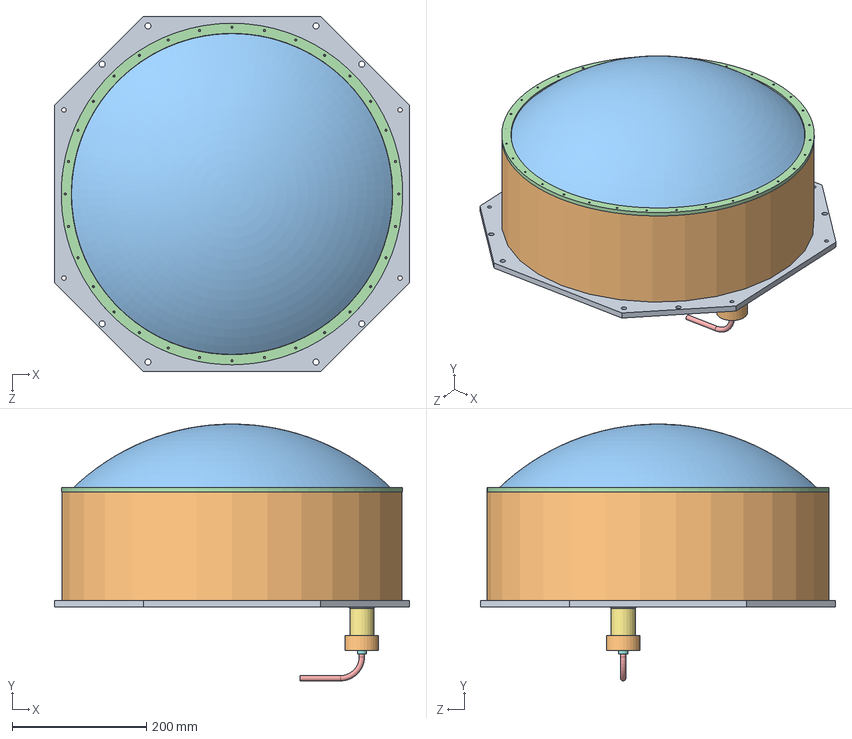
[picture p50: CAD file, 2022-10-26]
mPMT Assembly/mPMT Assembly Oct. 2022/New Assembly.SLDASM
528.0 x 382.1 x 528.0 mm
XDE2411 Improved
Dome_mPMT_SC improved
IWCD_PL_clampRing_SC improved
pillar_6mmMatrix_mPMT_R14374_SC x 6
mPMT_PCB_board_SC
PCB_connector x 20
PCB_SMAport x 2
PCB_FPGA x 5
PCB_SFP
PCB_connector2 x 2
Board^PCB_centralEnclustraModule
central block^PCB_centralEnclustraModule
PCB_standoff x 4
PCB_centralConnector x 3
IWCD_PL_Scintillator_SC
Shubham Matrix Improved
PMT_mPMT_R14374_SC x 19
round_poron_mPMT_R14374_SC x 19
reflector_mPMT_R14374_SC x 19
gel_mPMT_R14374_SC x 19
round_cup_mPMT_R14374_SC Shubham x 19
Inner Flange - Actual
Outer Flange
Weld
Flange Cover
End Cap x 2
Adhesive
Bent Cable
RJ-45 Male Port
RJ-45 Female Port
Inner Cable
