WCTE/WCTE_mPMT_mechanical/mPMT_Test_Stand-Spring2020/mPMTStand_V2.SLDASM

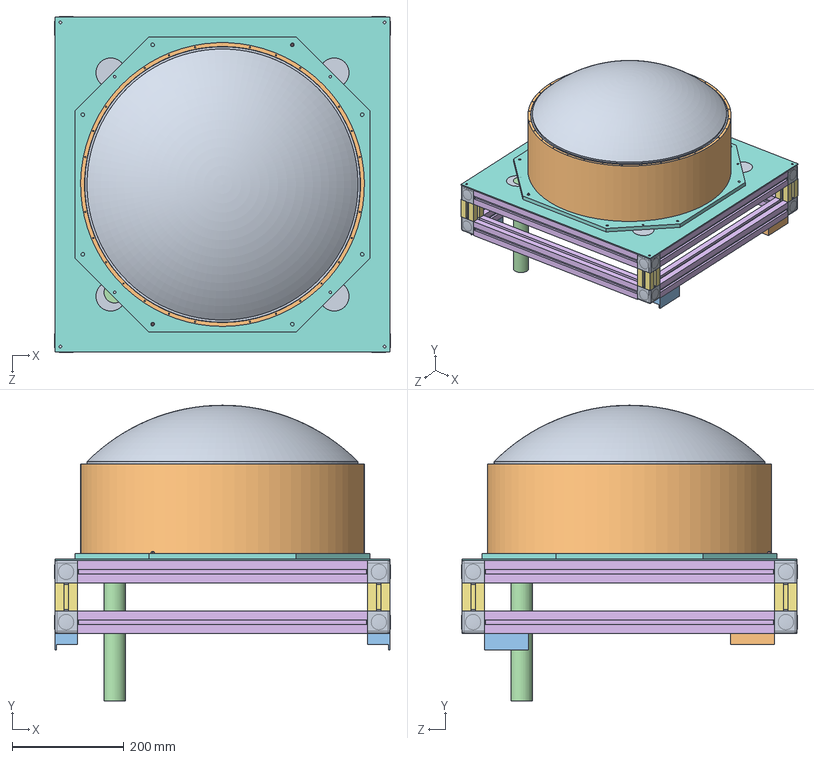
[picture p51: CAD file, 2022-05-10]
mPMT_Test_Stand-Spring2020/mPMTStand_V2.SLDASM
601.5 x 529.0 x 601.5 mm
mPMTStand_TopPanel
matrix_mPMT_R14374_LN
PMT_mPMT_R14374_LN x 19
cup_mPMT_R14374_LN x 19
poron_mPMT_R14374_LN x 19
reflector_mPMT_R14374_LN x 19
gel_mPMT_R14374_LN x 19
Back Plate_mPMT_LN
Dome_mPMT_LN
Outer_Cylinder_mPMT_LN
pillar_mPMT_R14374_LN x 6
95648A710_CLINCH-ON PINS FOR SHEET METAL.step x 2
mPMTStand_Frame x 2
mPMTStand_VerticalFrame
5537T291_ALUMINUM T-SLOTTED FRAMING EXTRUSION x 8
5537T462_SCREW ON ROLLER x 2
5537T468_SCREW ON ROLLER WITH GUIDE RAIL x 2
