WCTE/WCTE_mPMT_mechanical/mPMT Assembly/Assembly of PMT v2.SLDASM

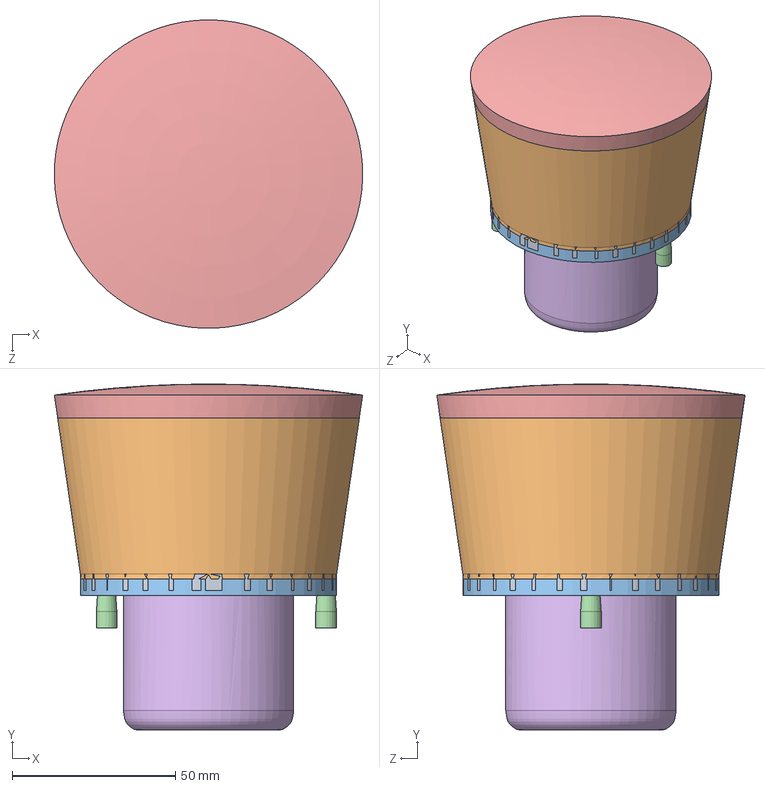
[picture p52: CAD file, 2022-05-10]
mPMT Assembly/Assembly of PMT v2.SLDASM
94.4 x 105.9 x 94.4 mm
cup progress rev2
poron progress rev 2
Pins x 2
Optical_gel
Hollow PMT rev 2
