WCTE/WCTE_mPMT_mechanical/mPMT_Test_Stand-Spring2020/Assem_IWCD_R14374_No_Stand_LN.SLDASM

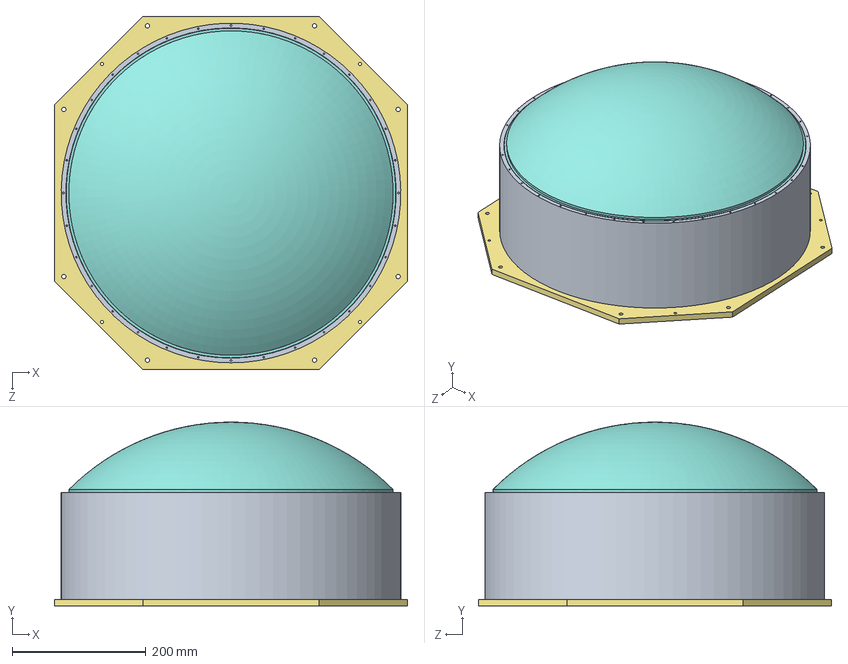
[picture p53: CAD file, 2022-05-10]
mPMT_Test_Stand-Spring2020/Assem_IWCD_R14374_No_Stand_LN.SLDASM
528.0 x 275.0 x 528.0 mm
matrix_mPMT_R14374_LN
PMT_mPMT_R14374_LN x 19
cup_mPMT_R14374_LN x 19
poron_mPMT_R14374_LN x 19
reflector_mPMT_R14374_LN x 19
gel_mPMT_R14374_LN x 19
Back Plate_mPMT_LN
Dome_mPMT_LN
Outer_Cylinder_mPMT_LN
pillar_mPMT_R14374_LN x 6
