WCTE/WCTE_mPMT_mechanical/mPMT Assembly/Asembly of mPMT rev2 flat.SLDASM

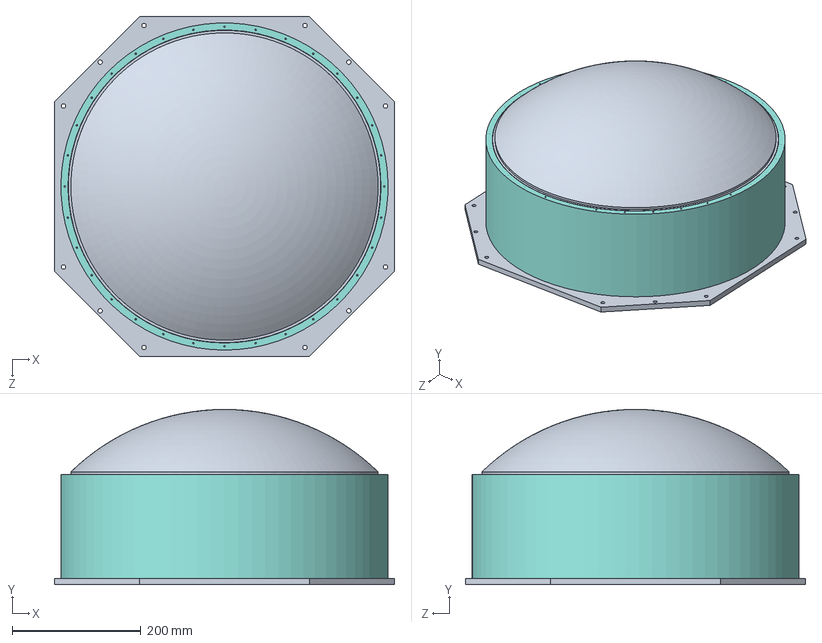
[picture p54: CAD file, 2022-05-10]
mPMT Assembly/Asembly of mPMT rev2 flat.SLDASM
528.0 x 272.1 x 528.0 mm
XDE2411 Improved
pillar_6mmMatrix_mPMT_R14374_SC x 6
Shubham Matrix Improved_4.1_Flatface
cup progress rev2 Flat x 19
Hollow PMT rev 2 x 19
poron progress rev 2 flat x 19
Pins x 38
Outer_Cylinder_mPMT_SC Improved
Dome_mPMT_SC improved
