WCTE/WCTE_mPMT_mechanical/mPMT Assembly/mPMT Assembly Oct. 2022/Feed Through Connector Assembly.SLDASM

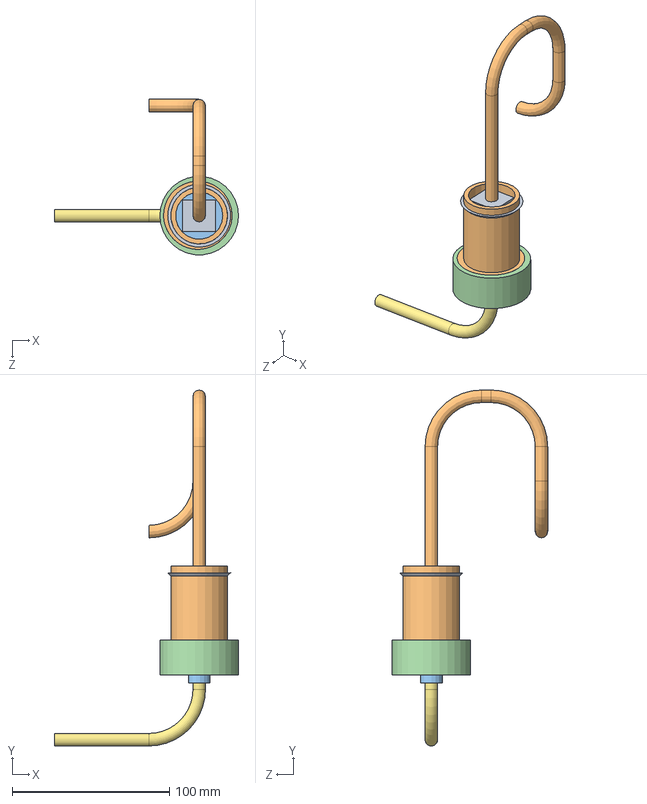
[picture p55: CAD file, 2022-10-26]
mPMT Assembly/mPMT Assembly Oct. 2022/Feed Through Connector Assembly.SLDASM
117.0 x 226.3 x 98.9 mm
Inner Flange - Actual
Outer Flange
Feed Through Connector Assembly Weld
Flange Cover
End Cap x 2
Adhesive
Bent Cable
RJ-45 Male Port
RJ-45 Female Port
Inner Cable
