WCTE/WCTE_mPMT_mechanical/mPMT Assembly/Asembly of mPMT.SLDASM

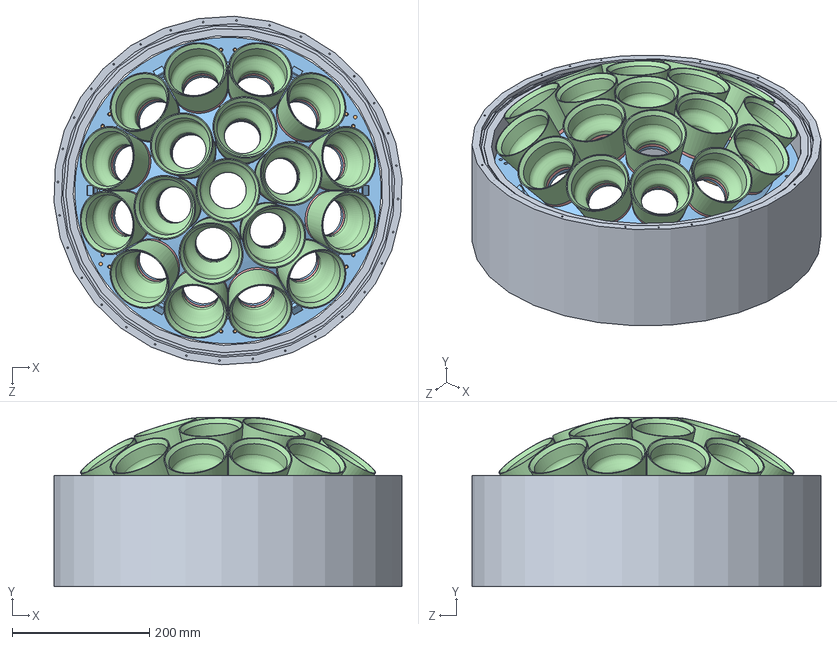
[picture p56: CAD file, 2022-05-10]
mPMT Assembly/Asembly of mPMT.SLDASM
506.8 x 246.2 x 507.7 mm
Outer_Cylinder_mPMT_SC Improved
pillar_6mmMatrix_mPMT_R14374_SC x 6
Shubham Matrix Improved_4.1
cup progress x 19
poron progress x 19
