WCTE/WCTE_mPMT_mechanical/mPMT Assembly/Asembly of mPMT rev2.SLDASM

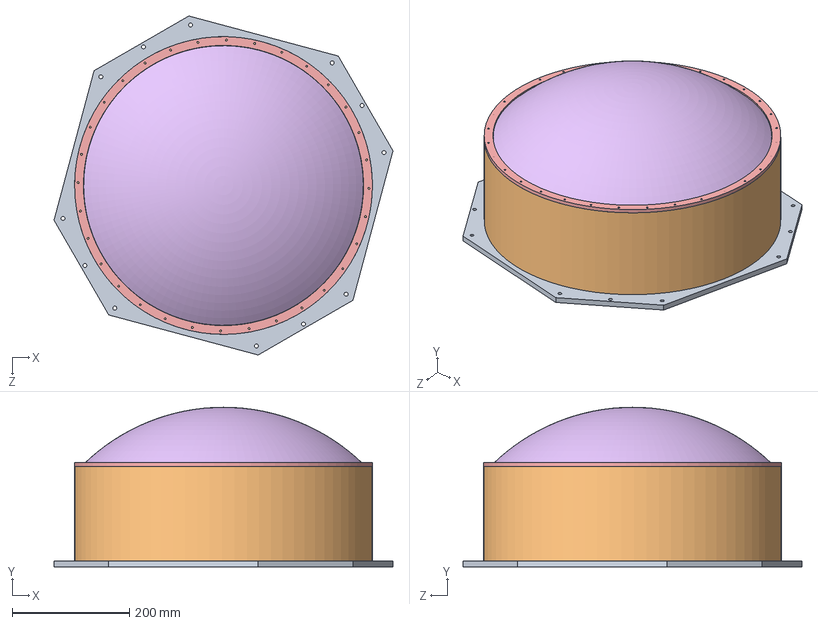
[picture p57: CAD file, 2022-05-10]
mPMT Assembly/Asembly of mPMT rev2.SLDASM
578.3 x 272.1 x 578.3 mm
XDE2411 Improved
pillar_6mmMatrix_mPMT_R14374_SC x 6
Dome_mPMT_SC improved
Shubham Matrix Improved_4.1
cup progress rev2 x 19
poron progress rev 2 x 19
Pins x 38
Optical_gel x 19
Hollow PMT rev 2 x 19
mPMT_PCB_board_SC
PCB_connector x 20
PCB_SMAport x 2
PCB_connector2 x 2
Board^PCB_centralEnclustraModule
central block^PCB_centralEnclustraModule
PCB_standoff x 4
PCB_centralConnector x 3
IWCD_PL_Scintillator_SC
