WCTE/WCTE_mPMT_mechanical/mPMT Assembly/mPMT Assembly shorter.SLDASM

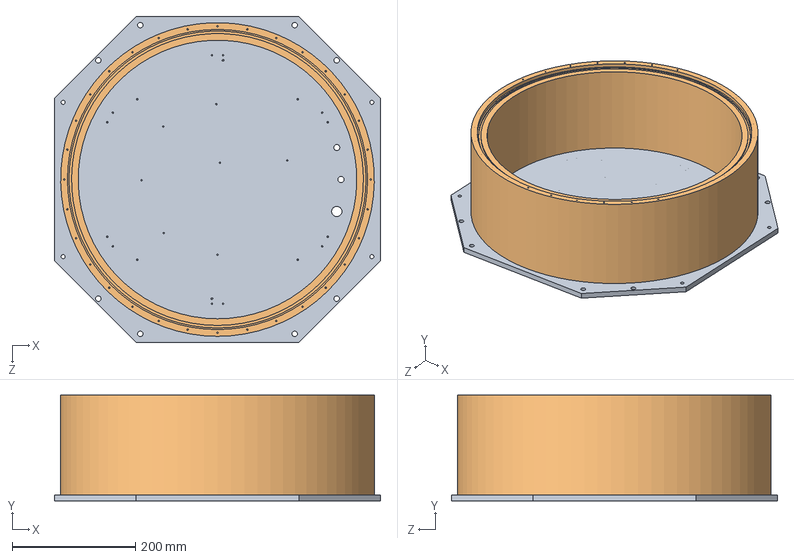
[picture p58: CAD file, 2022-05-10]
mPMT Assembly/mPMT Assembly shorter.SLDASM
528.0 x 171.3 x 528.0 mm
XDE2411
XDE2431
