WCTE/WCTE_mPMT_mechanical/mPMT Assembly/mPMT_Backplate_Cable.SLDASM

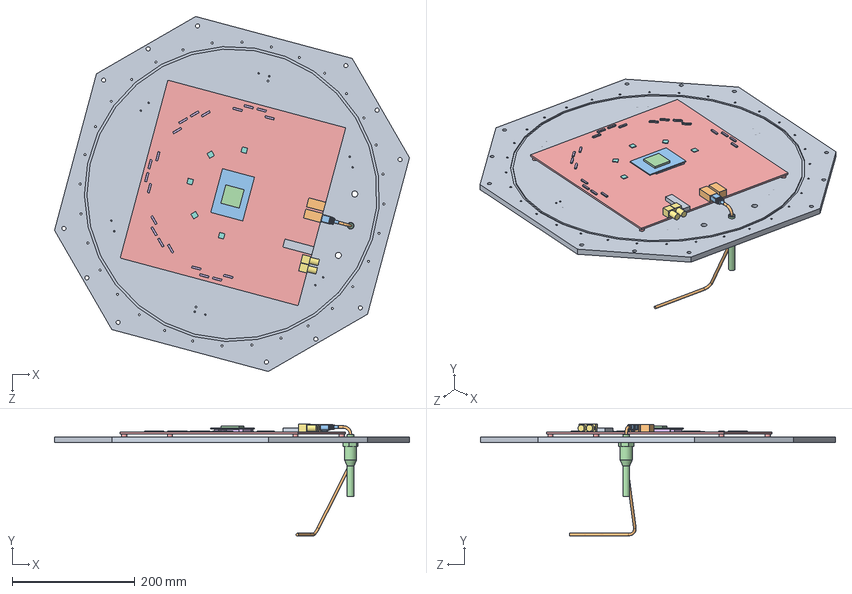
[picture p59: CAD file, 2022-05-10]
mPMT Assembly/mPMT_Backplate_Cable.SLDASM
578.3 x 182.3 x 578.3 mm
XDE2411 Improved
Part2^Assem_IWCD_PL_Penetrator
IWCD_PL_RJ45_Male
IWCD_PL_CRE-CA1184-MGA
mPMT_PCB_board_SC
PCB_connector x 20
PCB_SMAport x 2
PCB_FPGA x 5
PCB_SFP
PCB_connector2 x 2
Board^PCB_centralEnclustraModule
central block^PCB_centralEnclustraModule
PCB_standoff x 4
PCB_centralConnector x 3
