WCTE/WCTE_mPMT_mechanical/mPMT_Test_Stand-Spring2020/Assem_IWCD_R14374_LN.SLDASM

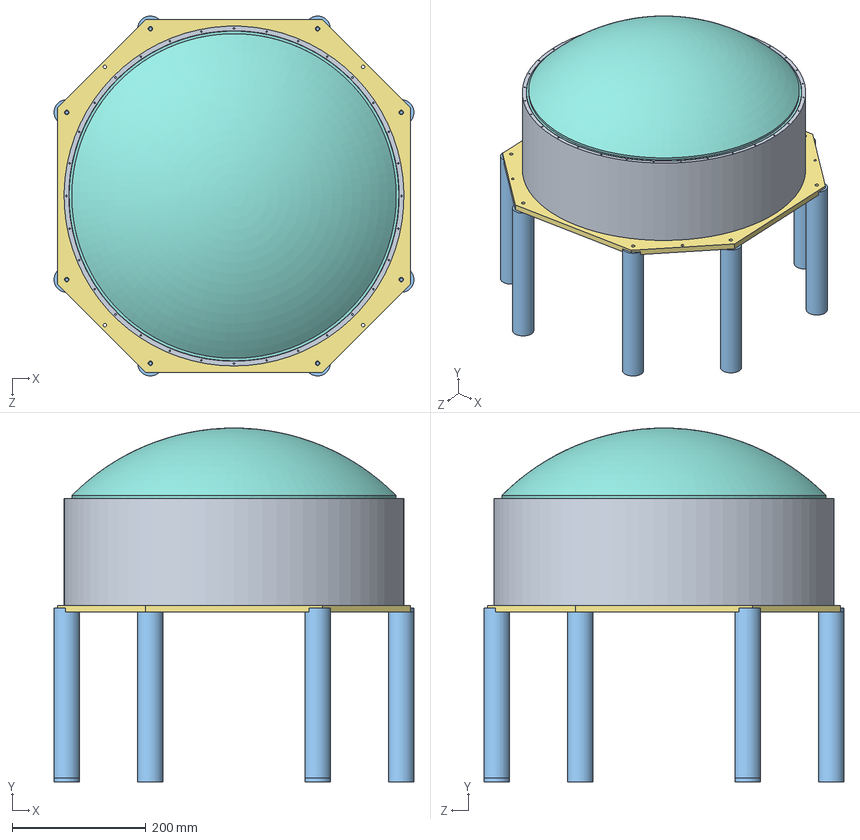
[picture p60: CAD file, 2022-05-10]
mPMT_Test_Stand-Spring2020/Assem_IWCD_R14374_LN.SLDASM
538.1 x 529.1 x 538.1 mm
matrix_mPMT_R14374
PMT_mPMT_R14374 x 19
cup_mPMT_R14374 x 19
poron_mPMT_R14374 x 19
reflector_mPMT_R14374 x 19
gel_mPMT_R14374 x 19
Back Plate_mPMT
Dome_mPMT
Outer_Cylinder_mPMT
pillar_mPMT_R14374 x 6
standOff_mPMT_R14374 x 8
