WCTE/WCTE_mPMT_mechanical/mPMT_Test_Stand-Spring2020/Assem_PMT_with_support_LN.SLDASM

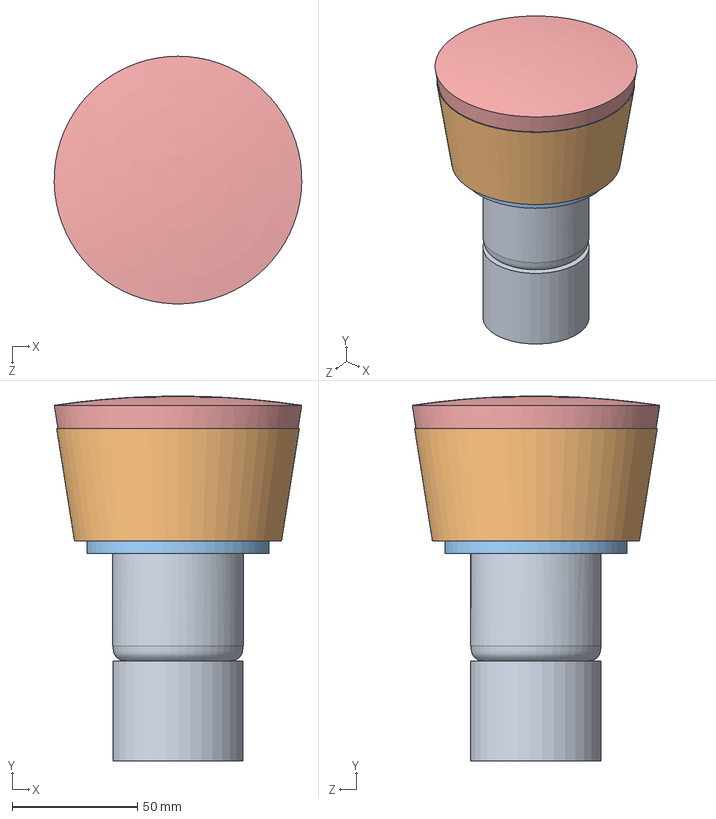
[picture p61: CAD file, 2022-05-10]
mPMT_Test_Stand-Spring2020/Assem_PMT_with_support_LN.SLDASM
99.0 x 145.9 x 98.9 mm
PMT_mPMT_R14374_LN
cup_mPMT_R14374_LN
poron_mPMT_R14374_LN
reflector_mPMT_R14374_LN
gel_mPMT_R14374_LN
