WCTE/WCTE_mPMT_mechanical/mPMT Assembly/Assembly Progress rev2 Flat.SLDASM

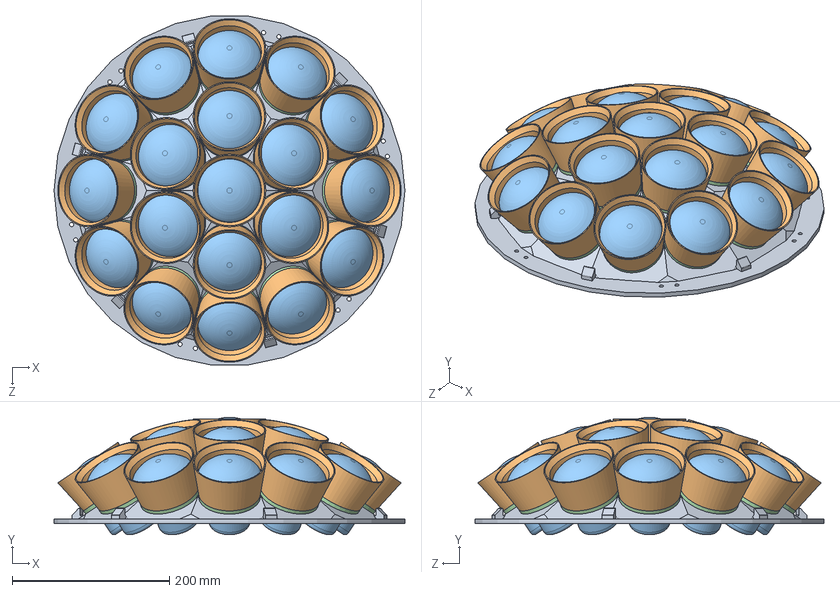
[picture p62: CAD file, 2022-05-10]
mPMT Assembly/Assembly Progress rev2 Flat.SLDASM
446.0 x 149.2 x 443.6 mm
Shubham Matrix Improved_4.1_Flatface
cup progress rev2 Flat x 19
Hollow PMT rev 2 x 19
poron progress rev 2 flat x 19
Pins x 38
