WCTE/WCTE_mPMT_mechanical/mPMT Assembly/mPMT Assembly Centerjig.SLDASM

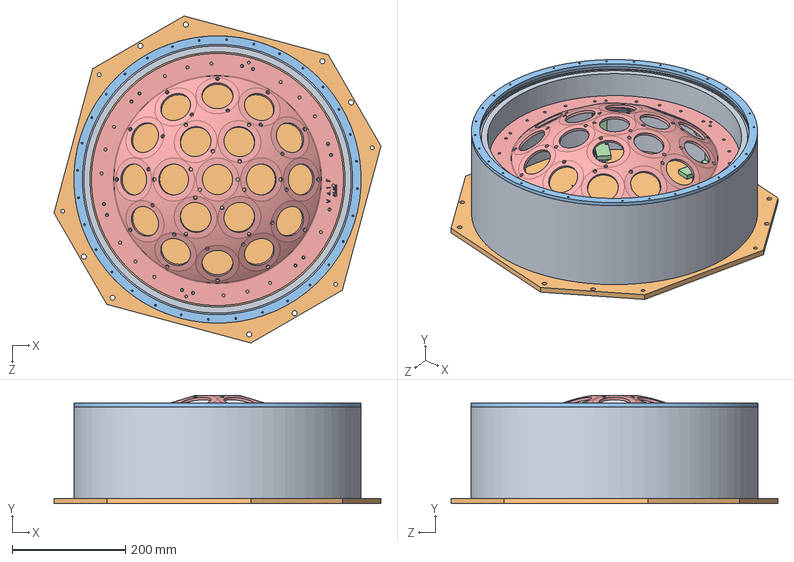
[picture p63: CAD file, 2022-05-10]
mPMT Assembly/mPMT Assembly Centerjig.SLDASM
578.3 x 191.6 x 578.3 mm
XDE2411
XDE2431
shorter pillar 3.5mm x 6
Shubham Matrix Improved_4.1-01
