WCTE/WCTE_mPMT_mechanical/mPMT Assembly/Assembly of PMT.SLDASM

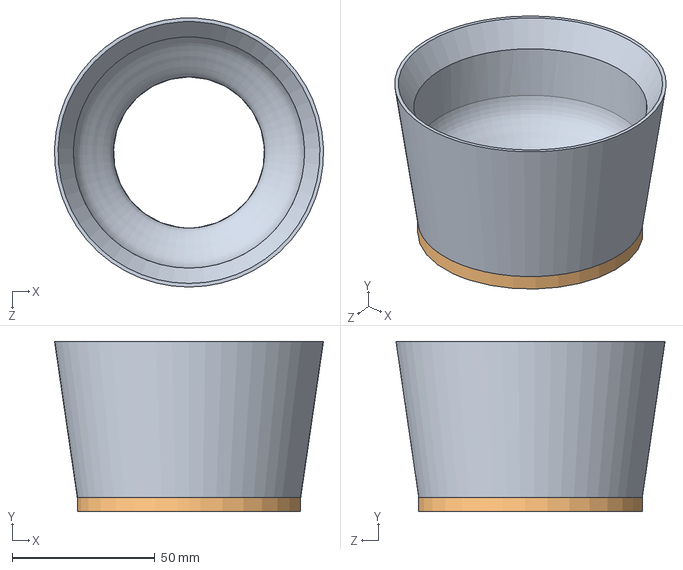
[picture p64: CAD file, 2022-05-10]
mPMT Assembly/Assembly of PMT.SLDASM
94.4 x 59.7 x 94.4 mm
cup progress
poron progress
