WCTE/WCTE_mPMT_mechanical/mPMT_Test_Stand-Spring2020/Optical Box.SLDASM

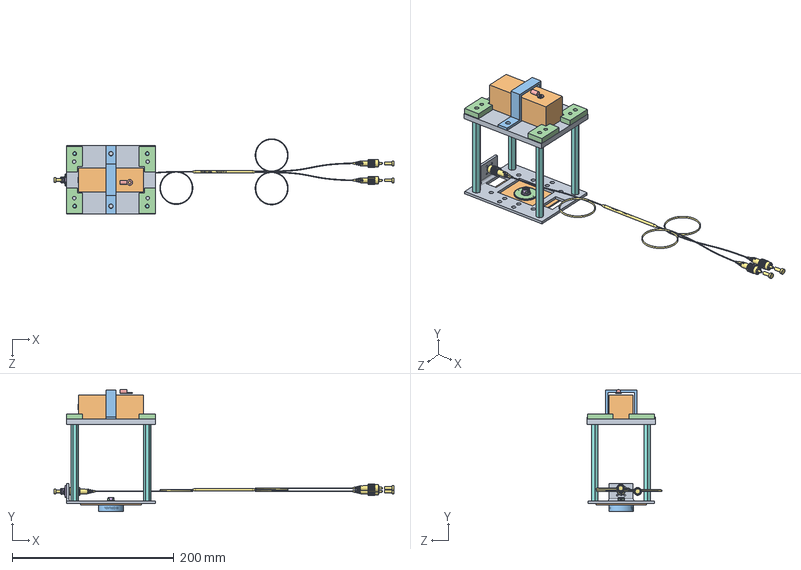
[picture p65: CAD file, 2022-05-10]
mPMT_Test_Stand-Spring2020/Optical Box.SLDASM
420.9 x 151.1 x 93.4 mm
OpticalBoxBaseplate
monitorPMT_rough
rPMT_Mounting_Bracket
rPMT_Placement_Blocks
USP10976_10k_Thermistor
ADAFC2-Solidworks
TM50R2F1A-Solidworks
970950481_HEX SPACER M4 STEEL 95MM x 4
Lense_housing_plate
Collimator_plate
CFC-5X-A-Solidworks
