WCTE/WCTE_mPMT_mechanical/mPMT Assembly/Asembly of mPMT rev3_Simulation.SLDASM

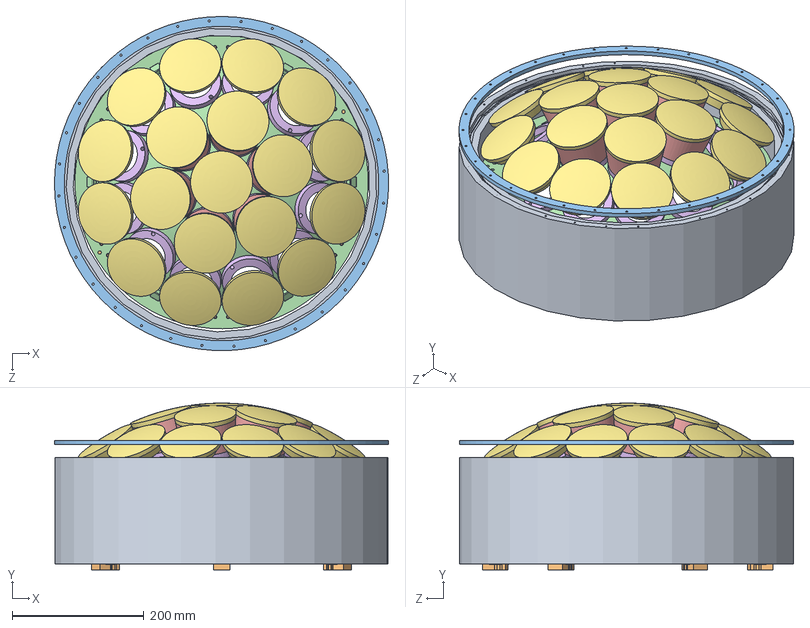
[picture p66: CAD file, 2022-05-10]
mPMT Assembly/Asembly of mPMT rev3_Simulation.SLDASM
507.9 x 253.7 x 507.8 mm
Outer_Cylinder_mPMT_SC Improved
pillar_6mmMatrix_mPMT_R14374_SC x 6
IWCD_PL_clampRing_SC improved
Shubham Matrix Improved_4.1
cup progress rev4 x 7
poron progress rev 3 x 19
Optical_gel x 19
