WCTE/WCTE_mPMT_mechanical/Faceted Matrix/Actual Dimensions/shorter pillar 4.0.5 106.11mm.SLDPRT

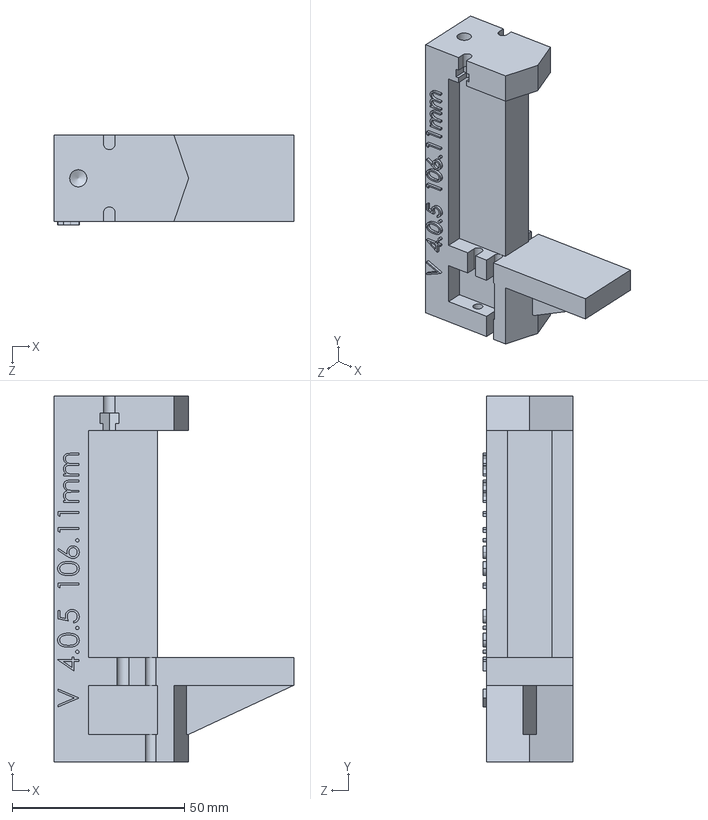
[picture p67: CAD file, 2022-09-21]
Faceted Matrix/Actual Dimensions/shorter pillar 4.0.5 106.11mm.SLDPRT
69.5 x 106.1 x 26.0 mm
