WCTE/WCTE_mPMT_mechanical/Faceted Matrix/Ideal Dimensions/Matrix Improved_4.11.STEP

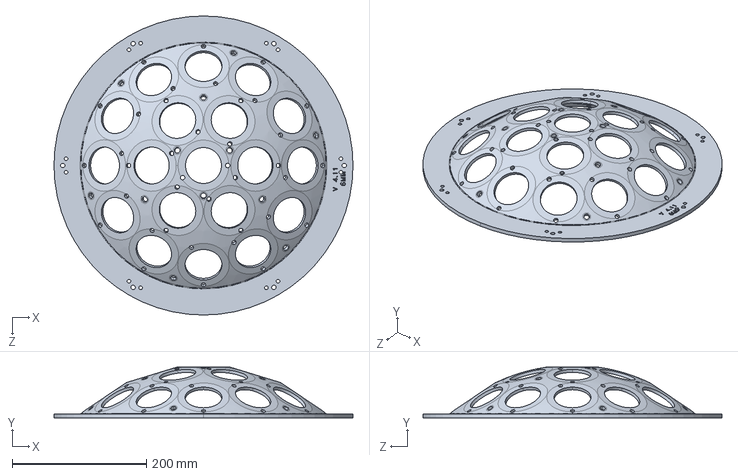
[picture p68: CAD file, 2023-09-14]
Faceted Matrix/Ideal Dimensions/Matrix Improved_4.11.STEP
446.0 x 75.9 x 446.0 mm
