WCTE/WCTE_mPMT_mechanical/Feedthrough with M12 connector/2 wires.SLDPRT

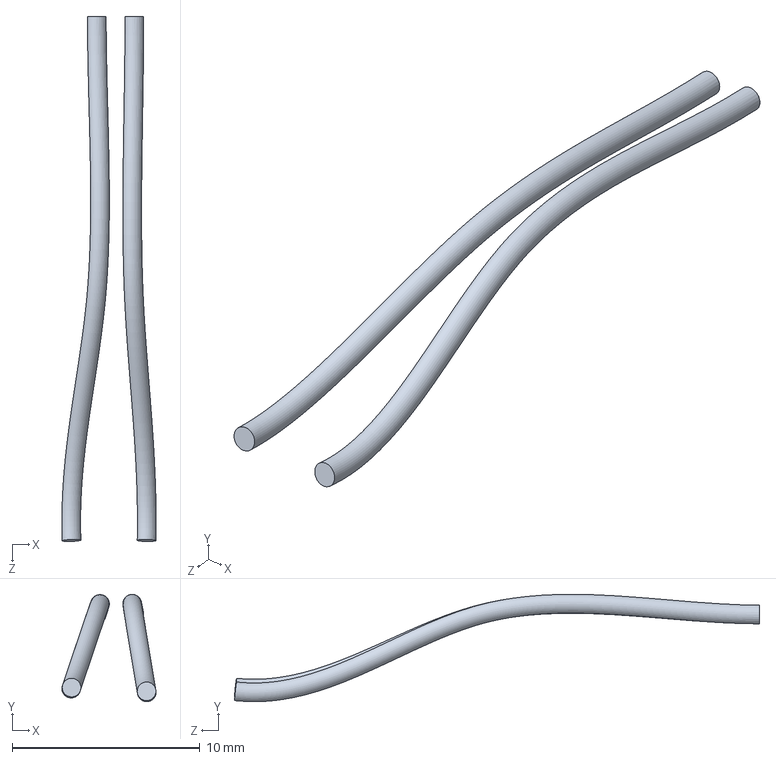
[picture p69: CAD file, 2022-12-23]
Feedthrough with M12 connector/2 wires.SLDPRT
5.02 x 5.72 x 28.0 mm
