WCTE/WCTE_mPMT_mechanical/Gelling Jig Tabbed/Machined_BottomMould.STEP

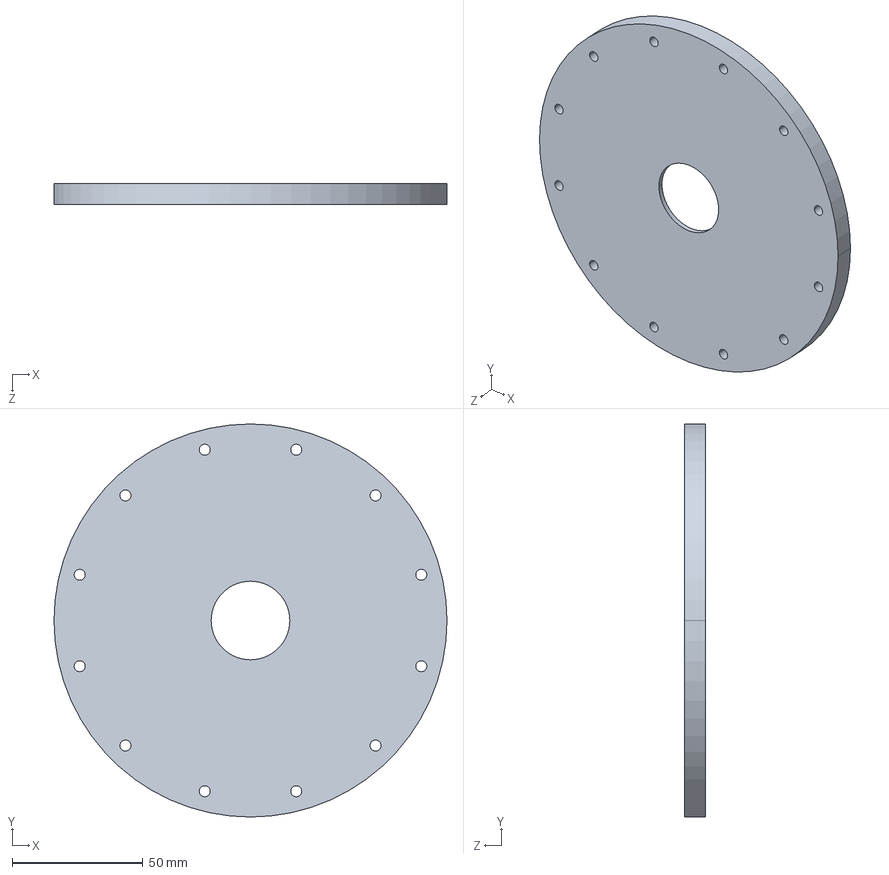
[picture p70: CAD file, 2023-07-27]
Gelling Jig Tabbed/Machined_BottomMould.STEP
150.0 x 150.0 x 8.00 mm
