WCTE/WCTE_mPMT_mechanical/Gelling Jig Tabbed/STL file/18 TopMouldRight - Flanged Gasket - v4 - for printing.STL

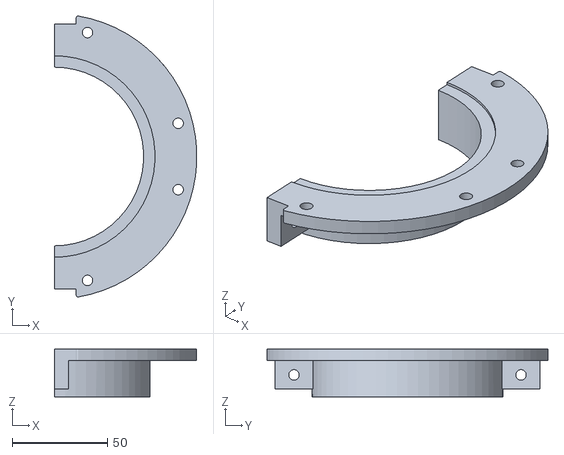
[picture p71: CAD file, 2022-12-07]
Gelling Jig Tabbed/STL file/18 TopMouldRight - Flanged Gasket - v4 - for printing.STL
74.9 x 147.9 x 25.0
