WCTE/WCTE_mPMT_mechanical/important prints/central cup rev 11.STEP

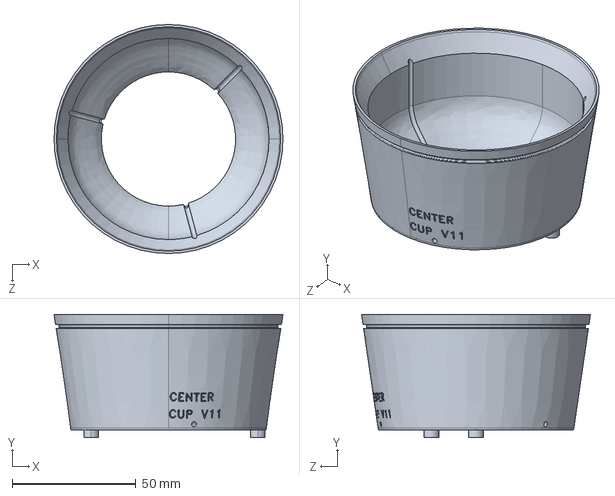
[picture p72: CAD file, 2023-08-11]
important prints/central cup rev 11.STEP
92.4 x 49.7 x 92.4 mm
