WCTE/WCTE_mPMT_mechanical/mPMT Assembly/Collar V1.STEP

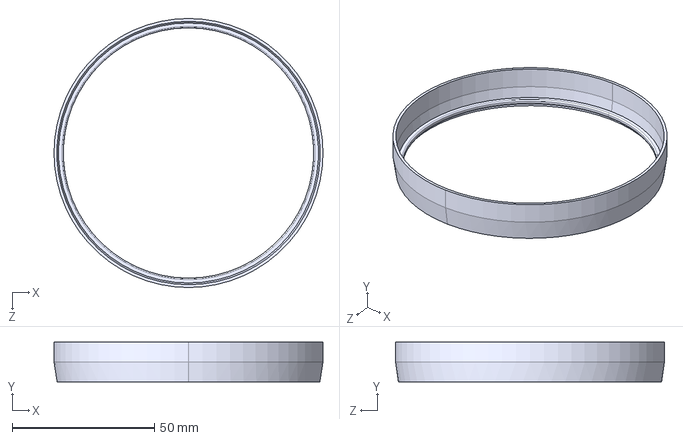
[picture p73: CAD file, 2023-08-11]
mPMT Assembly/Collar V1.STEP
94.6 x 14.0 x 94.6 mm
