WCTE/WCTE_mPMT_mechanical/mPMT Assembly/mPMT Assembly Oct. 2022/XDE2431.SLDPRT

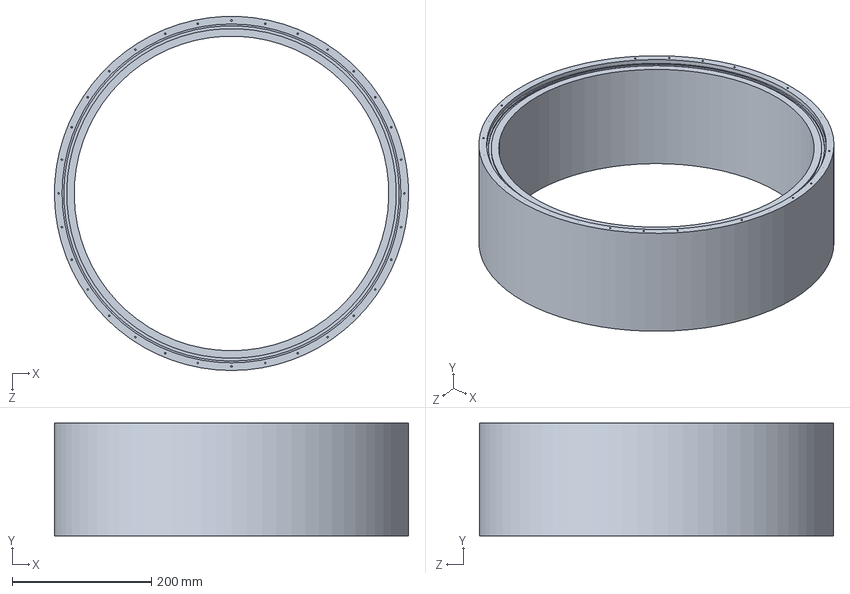
[picture p74: CAD file, 2022-10-27]
mPMT Assembly/mPMT Assembly Oct. 2022/XDE2431.SLDPRT
507.9 x 161.8 x 507.8 mm
