WCTE/WCTE_mPMT_mechanical/mPMT Assembly/Pillars/Aluminum Pillars/2020 Pillar Assembly Temporary/pillar bottom fixture.SLDPRT

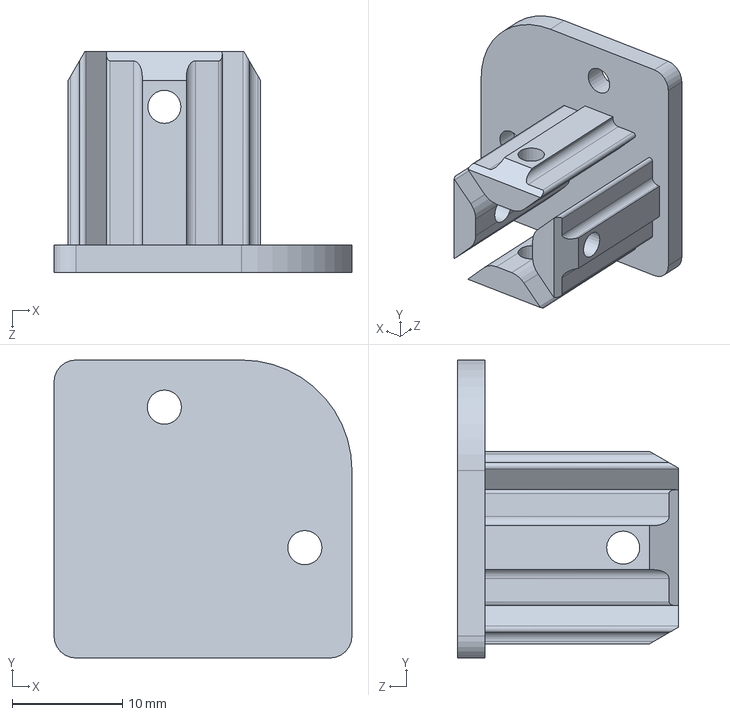
[picture p75: CAD file, 2022-12-23]
mPMT Assembly/Pillars/Aluminum Pillars/2020 Pillar Assembly Temporary/pillar bottom fixture.SLDPRT
27.0 x 27.0 x 20.0 mm
