WCTE/WCTE_mPMT_mechanical/mPMT Assembly/Pillars/shorter pillar 4.1.2 101.1mm - for cooling scheme.SLDPRT

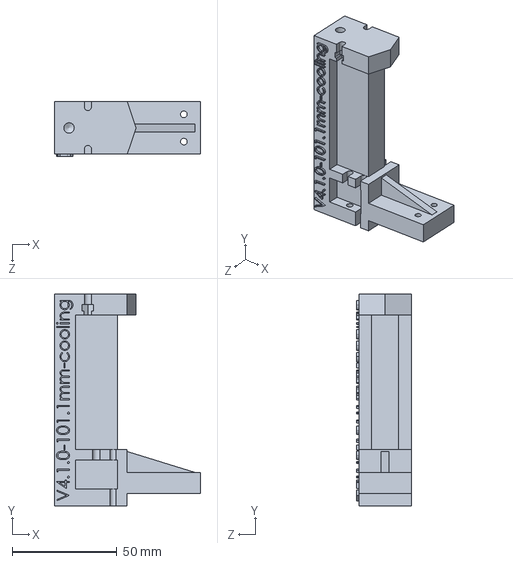
[picture p76: CAD file, 2022-12-21]
mPMT Assembly/Pillars/shorter pillar 4.1.2 101.1mm - for cooling scheme.SLDPRT
69.8 x 101.1 x 26.0 mm
