WCTE/WCTE_mPMT_mechanical/Quality Control/Backplate QC/backplate qc - middle piece a.SLDPRT

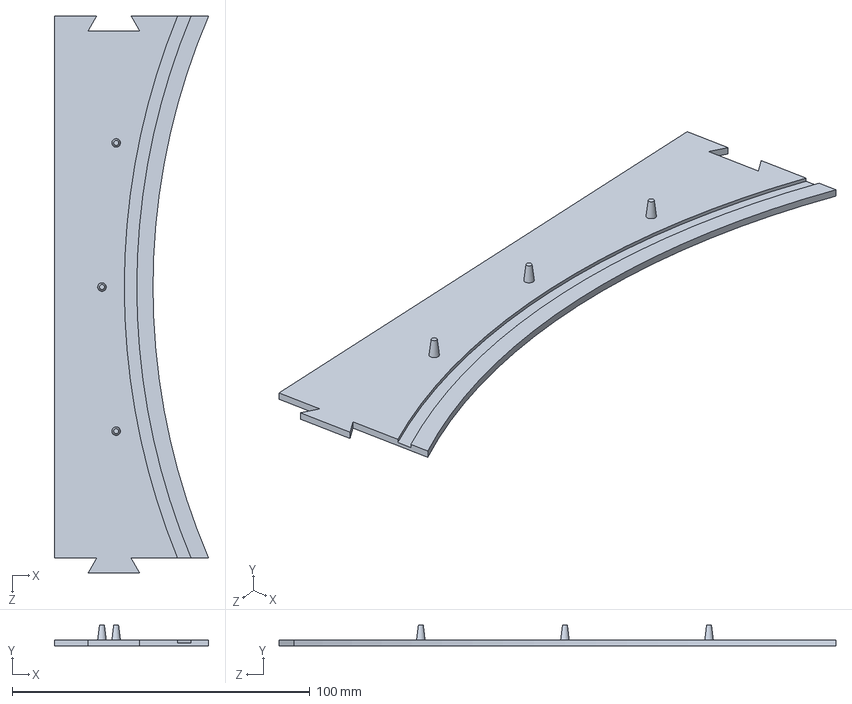
[picture p77: CAD file, 2022-12-23]
Quality Control/Backplate QC/backplate qc - middle piece a.SLDPRT
51.8 x 7.00 x 187.0 mm
