WCTE/WCTE_mPMT_mechanical/Reflector Sheet/XDE2580_modified.SLDPRT

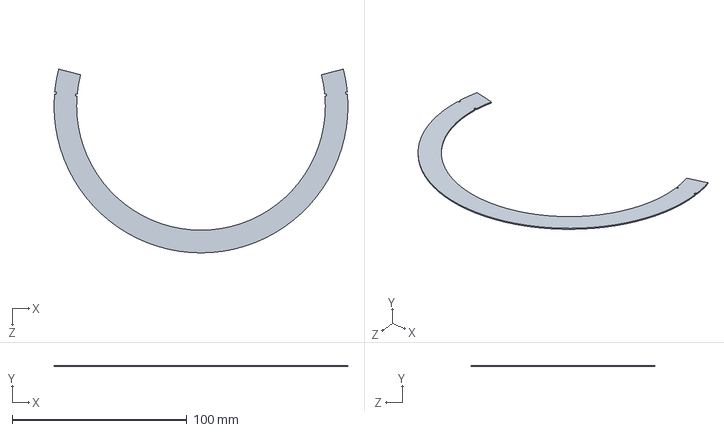
[picture p78: CAD file, 2022-12-21]
Reflector Sheet/XDE2580_modified.SLDPRT
168.4 x 0.7 x 105.3 mm
