WCTE/WCTE_mPMT_mechanical/Dome + Cylinder Lowering Fixture/TDE2871.SLDPRT

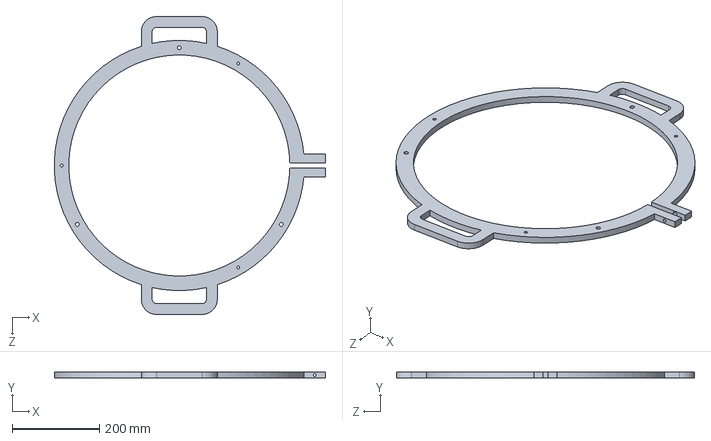
[picture p79: CAD file, 2022-05-10]
Dome + Cylinder Lowering Fixture/TDE2871.SLDPRT
623.5 x 12.7 x 685.0 mm
