WCTE/WCTE_mPMT_mechanical/Feedthrough with M12 connector/PCB.SLDPRT

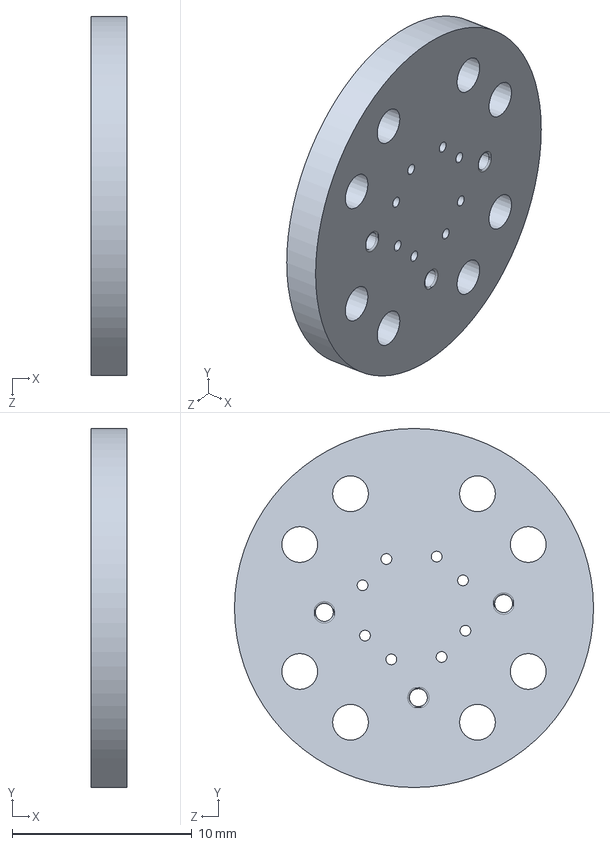
[picture p80: CAD file, 2022-12-23]
Feedthrough with M12 connector/PCB.SLDPRT
2.00 x 20.0 x 20.0 mm
