WCTE/WCTE_mPMT_mechanical/Gelling Jig Tabbed/gelling pad.SLDPRT

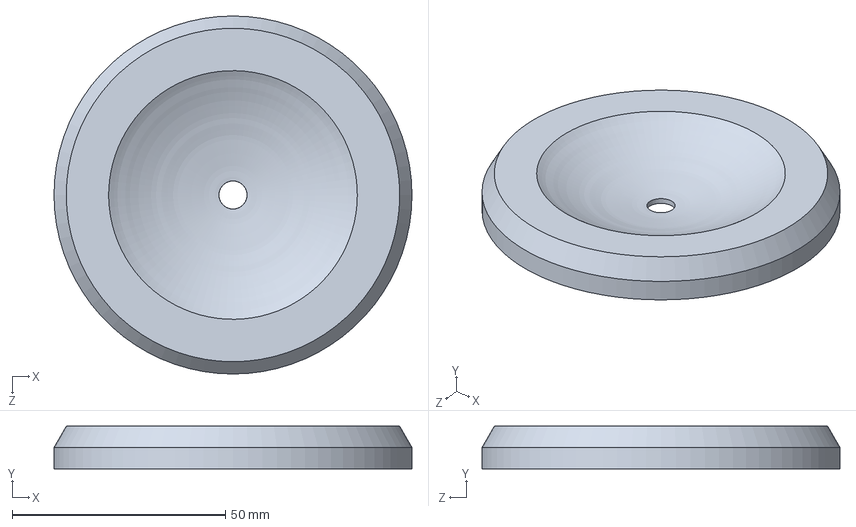
[picture p81: CAD file, 2022-12-22]
Gelling Jig Tabbed/gelling pad.SLDPRT
84.0 x 10.0 x 84.0 mm
