WCTE/WCTE_mPMT_mechanical/Gelling Jig Tabbed/STL file/18 TopMouldLeft - Flanged Gasket - v4 - for printing.STL

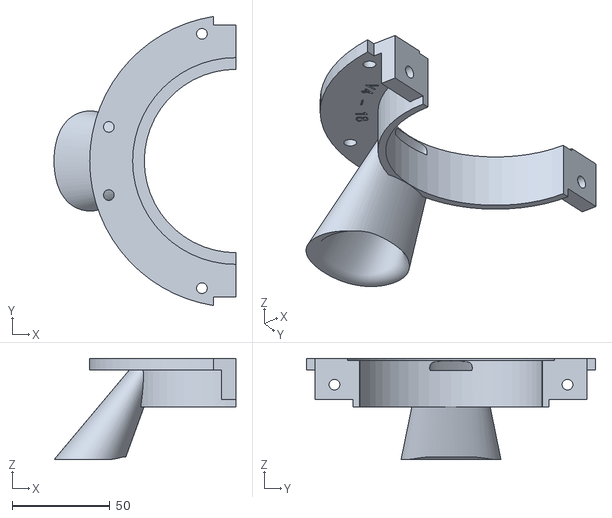
[picture p82: CAD file, 2022-12-07]
Gelling Jig Tabbed/STL file/18 TopMouldLeft - Flanged Gasket - v4 - for printing.STL
93.3 x 148.2 x 52.0
