WCTE/WCTE_mPMT_mechanical/important prints/outer cup rev11.STEP

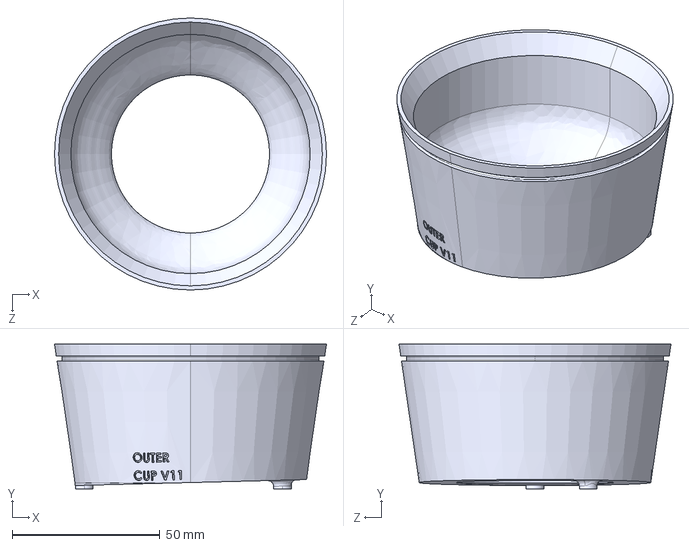
[picture p83: CAD file, 2023-08-11]
important prints/outer cup rev11.STEP
92.2 x 49.1 x 92.2 mm
