WCTE/WCTE_mPMT_mechanical/mPMT Assembly/Pillars/Aluminum Pillars/2020 Pillar Assembly Temporary/5537T9_T-Slotted Framing.SLDPRT

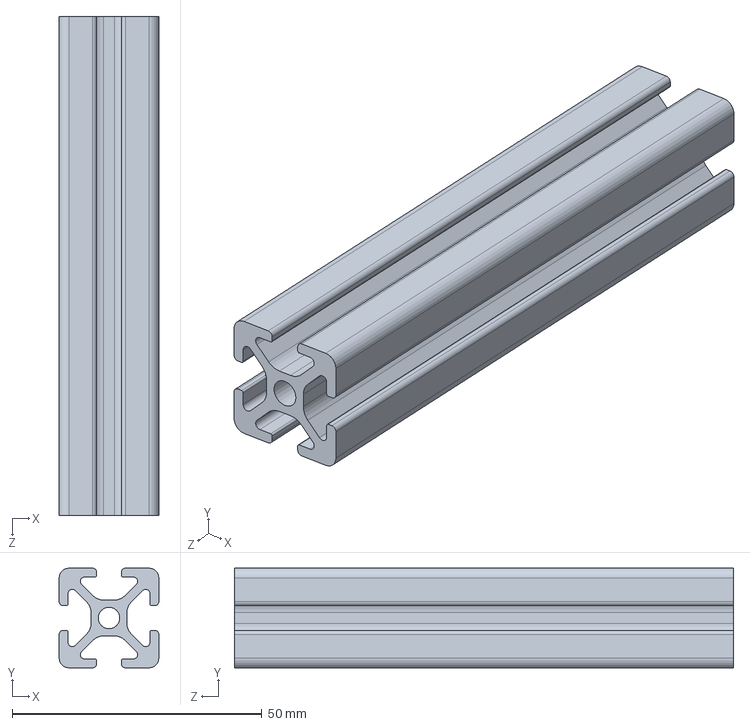
[picture p84: CAD file, 2022-12-23]
mPMT Assembly/Pillars/Aluminum Pillars/2020 Pillar Assembly Temporary/5537T9_T-Slotted Framing.SLDPRT
20.0 x 20.0 x 100.0 mm
