WCTE/WCTE_mPMT_mechanical/mPMT_Test_Stand-Spring2020/mPMTStand_VerticalFrame.SLDPRT

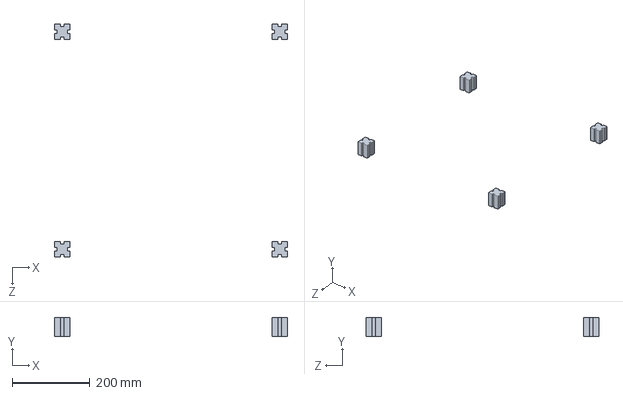
[picture p85: CAD file, 2022-05-10]
mPMT_Test_Stand-Spring2020/mPMTStand_VerticalFrame.SLDPRT
600.0 x 50.0 x 600.0 mm
