WCTE/WCTE_mPMT_mechanical/Quality Control/Backplate QC/XDE2411.SLDPRT

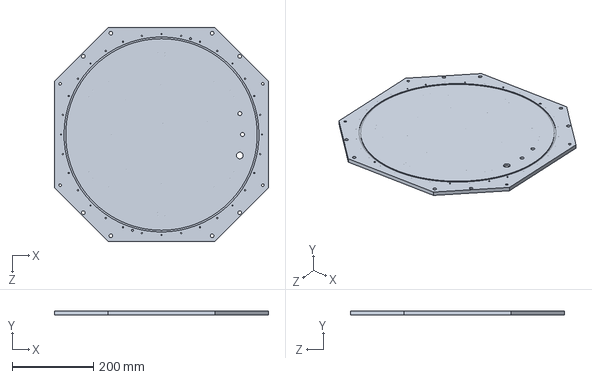
[picture p86: CAD file, 2022-12-23]
Quality Control/Backplate QC/XDE2411.SLDPRT
528.0 x 9.53 x 528.0 mm
