WCTE/WCTE_mPMT_mechanical/Quality Control/Dome QC/dome pillar 4.SLDPRT

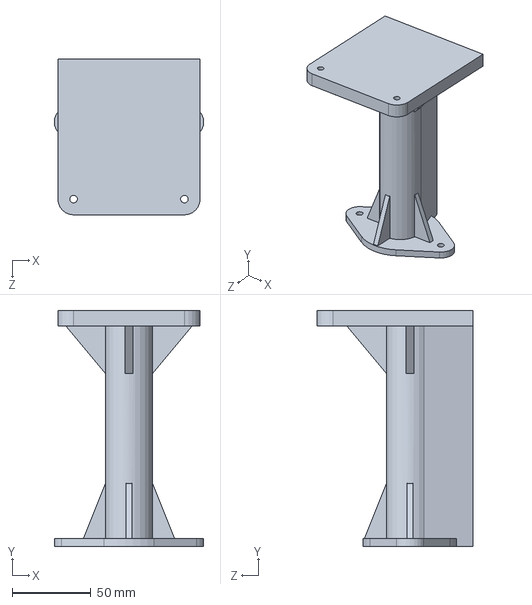
[picture p87: CAD file, 2022-12-23]
Quality Control/Dome QC/dome pillar 4.SLDPRT
95.0 x 150.0 x 99.0 mm
