WCTE/WCTE_mPMT_mechanical/Quality Control/PMT QC/BottomMould.SLDPRT

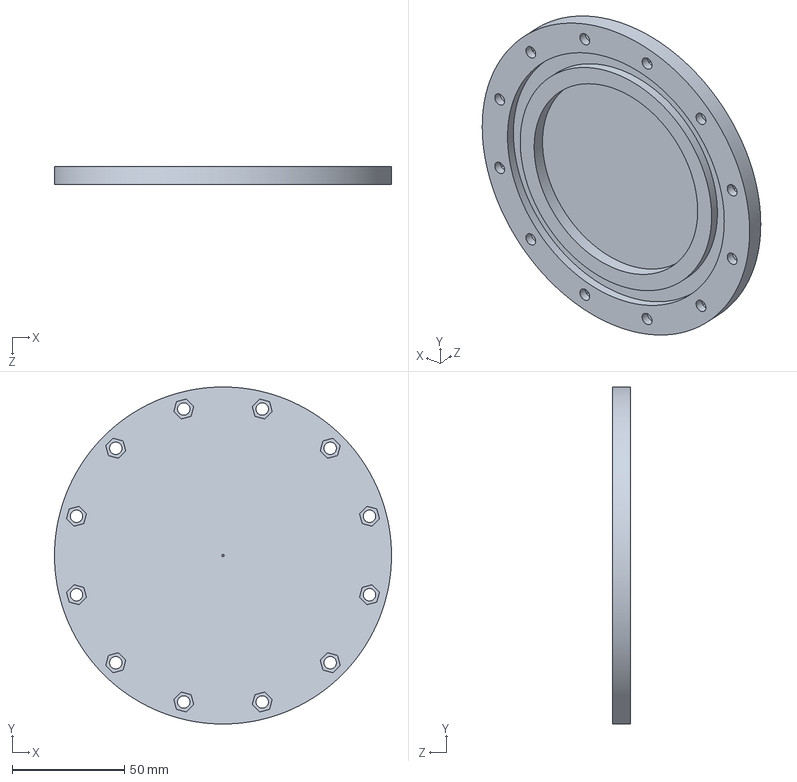
[picture p88: CAD file, 2022-12-23]
Quality Control/PMT QC/BottomMould.SLDPRT
150.0 x 150.0 x 8.00 mm
