WCTE/WCTE_mPMT_mechanical/Reflector Sheet/Reflector sheet v4.SLDPRT

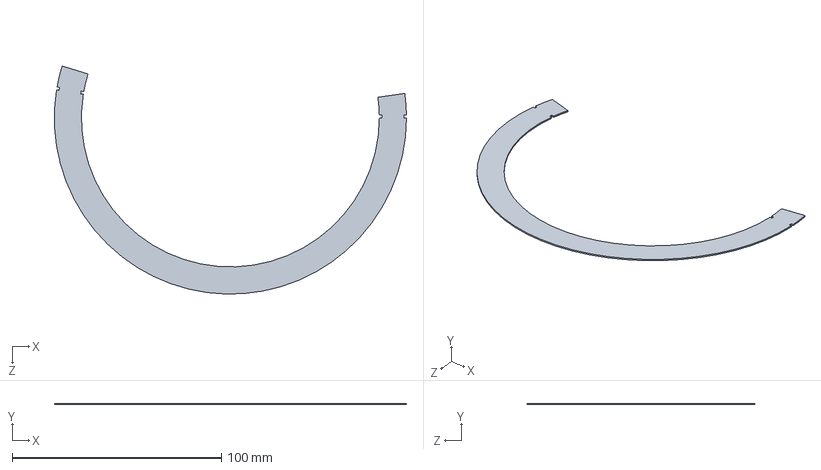
[picture p89: CAD file, 2022-09-26]
Reflector Sheet/Reflector sheet v4.SLDPRT
168.3 x 0.7 x 109.1 mm
