WCTE/WCTE_mPMT_mechanical/Dome + Cylinder Lowering Fixture/TDE2872.SLDPRT

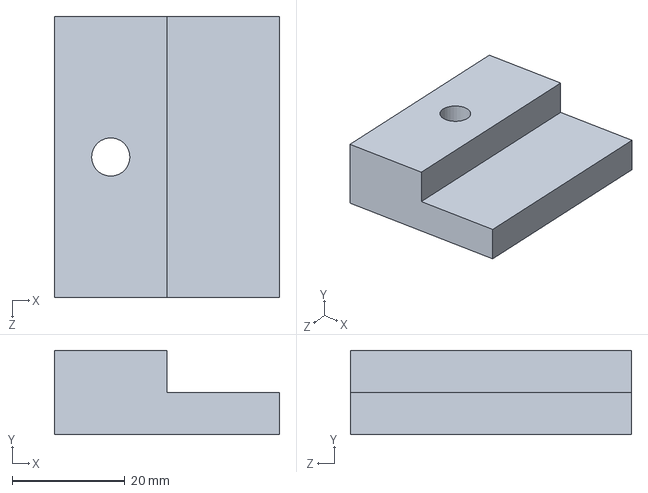
[picture p90: CAD file, 2022-05-10]
Dome + Cylinder Lowering Fixture/TDE2872.SLDPRT
40.0 x 15.0 x 50.0 mm
