WCTE/WCTE_mPMT_mechanical/Faceted Matrix/Actual Dimensions/shorter pillar 4.0.3 107mm.SLDPRT

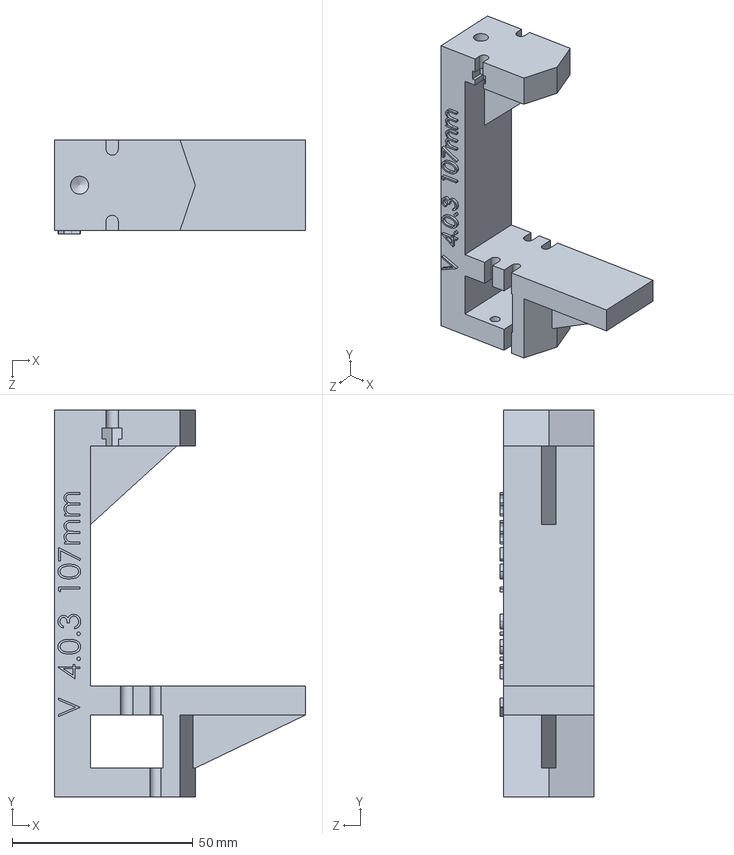
[picture p91: CAD file, 2022-06-13]
Faceted Matrix/Actual Dimensions/shorter pillar 4.0.3 107mm.SLDPRT
69.5 x 107.0 x 26.0 mm
