WCTE/WCTE_mPMT_mechanical/Feedthrough with M12 connector/8mm cable v4.SLDPRT

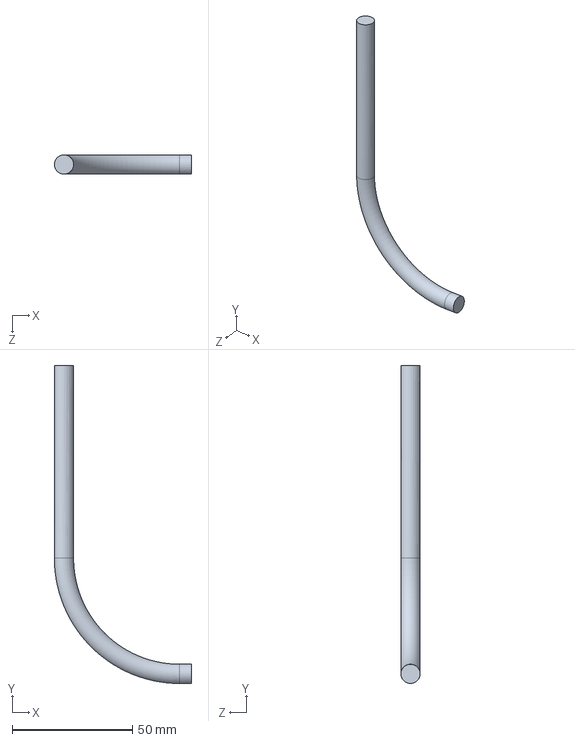
[picture p92: CAD file, 2022-12-23]
Feedthrough with M12 connector/8mm cable v4.SLDPRT
57.0 x 132.0 x 8.00 mm
