WCTE/WCTE_mPMT_mechanical/Gelling Jig Tabbed/PMTClamp_part1 v4 slanted.SLDPRT

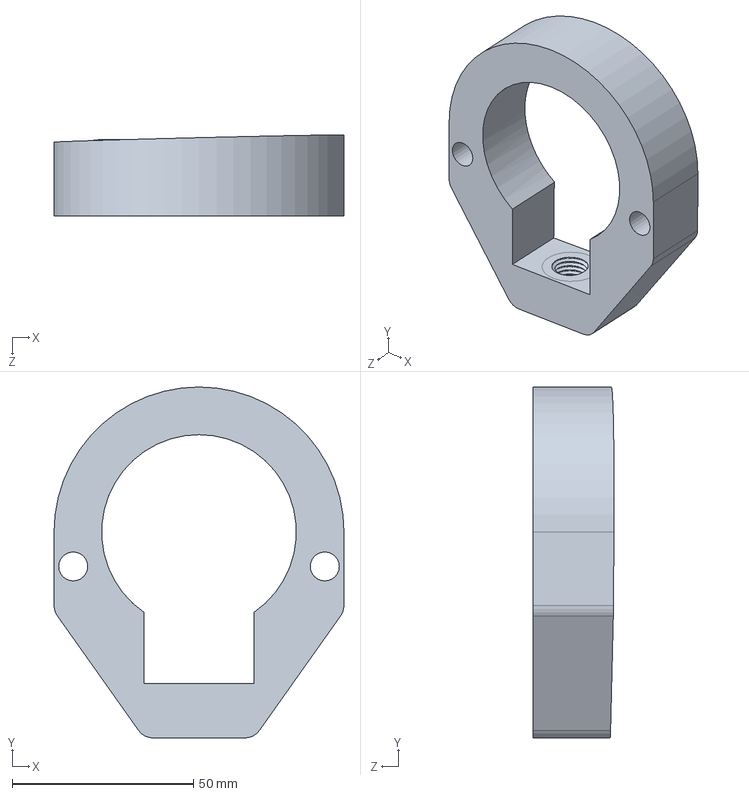
[picture p93: CAD file, 2022-12-22]
Gelling Jig Tabbed/PMTClamp_part1 v4 slanted.SLDPRT
80.0 x 96.8 x 22.4 mm
