WCTE/WCTE_mPMT_mechanical/important prints/PM3 Holder.STL

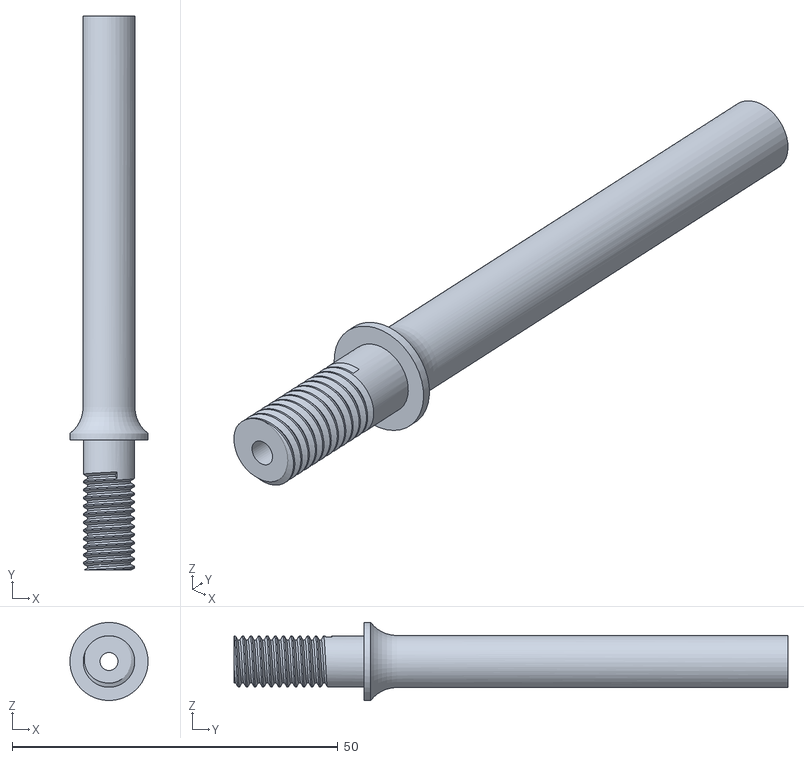
[picture p94: CAD file, 2023-06-13]
important prints/PM3 Holder.STL
12.0 x 85.1 x 12.0
