WCTE/WCTE_mPMT_mechanical/mPMT Assembly/LED diffuser holder V3.SLDPRT

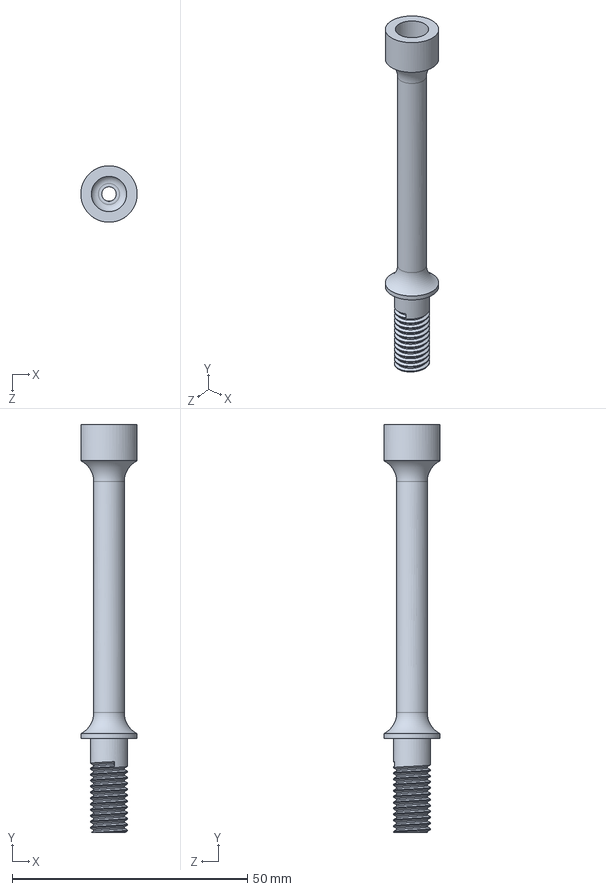
[picture p95: CAD file, 2023-03-01]
mPMT Assembly/LED diffuser holder V3.SLDPRT
12.0 x 86.7 x 12.0 mm
