WCTE/WCTE_mPMT_mechanical/mPMT Assembly/Pillars/Aluminum Pillars/2020 Pillar Assembly Temporary/Matrix Improved_4.5 fixed.SLDPRT

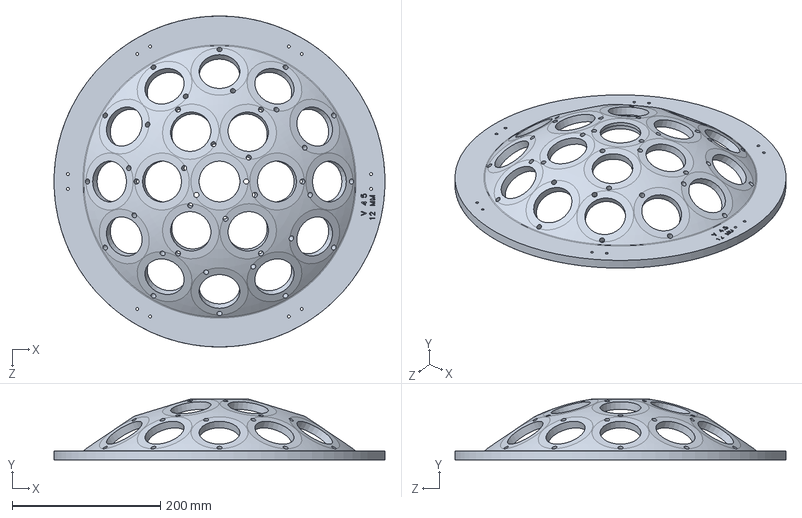
[picture p96: CAD file, 2022-12-23]
mPMT Assembly/Pillars/Aluminum Pillars/2020 Pillar Assembly Temporary/Matrix Improved_4.5 fixed.SLDPRT
446.0 x 81.9 x 446.0 mm
