WCTE/WCTE_mPMT_mechanical/mPMT Assembly/Pillars/Aluminum Pillars/2020 Pillar Assembly/2020 Pillar Assembly/20_4119.sldprt

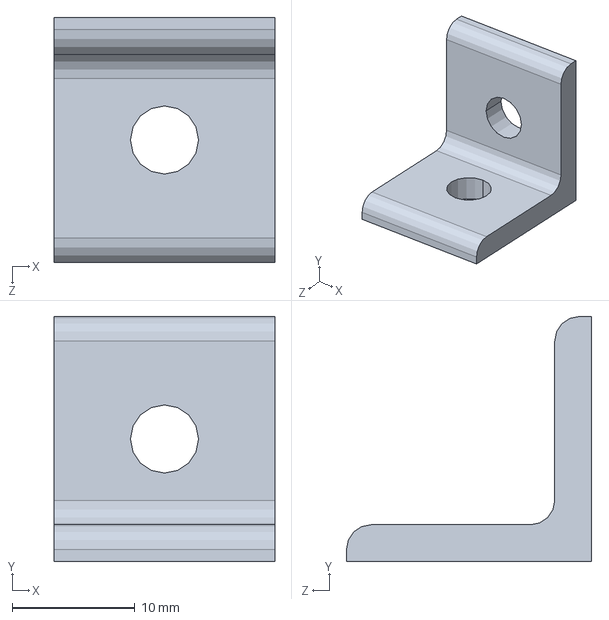
[picture p97: CAD file, 2022-12-22]
mPMT Assembly/Pillars/Aluminum Pillars/2020 Pillar Assembly/2020 Pillar Assembly/20_4119.sldprt
18.0 x 20.0 x 20.0 mm
