WCTE/WCTE_mPMT_mechanical/mPMT_Test_Stand-Spring2020/Dark_Box_Panel_Bottom.SLDPRT

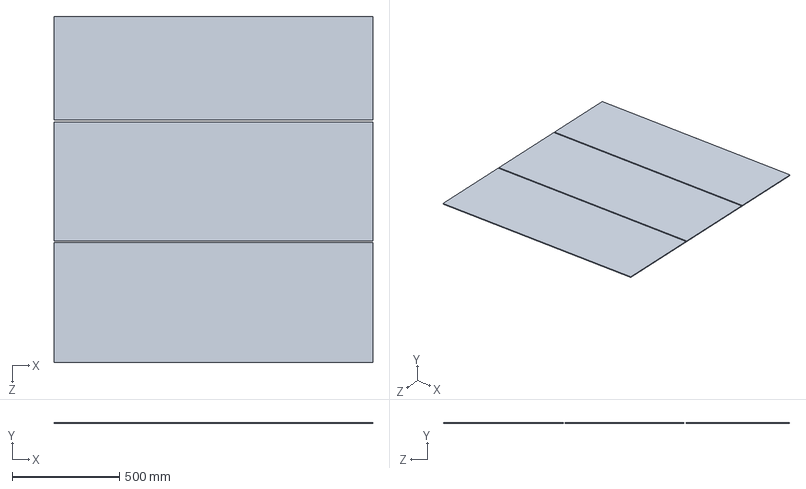
[picture p98: CAD file, 2022-05-10]
mPMT_Test_Stand-Spring2020/Dark_Box_Panel_Bottom.SLDPRT
1485.2 x 5.00 x 1612.2 mm
