WCTE/WCTE_mPMT_mechanical/Pressure Tester/arduino box.SLDPRT

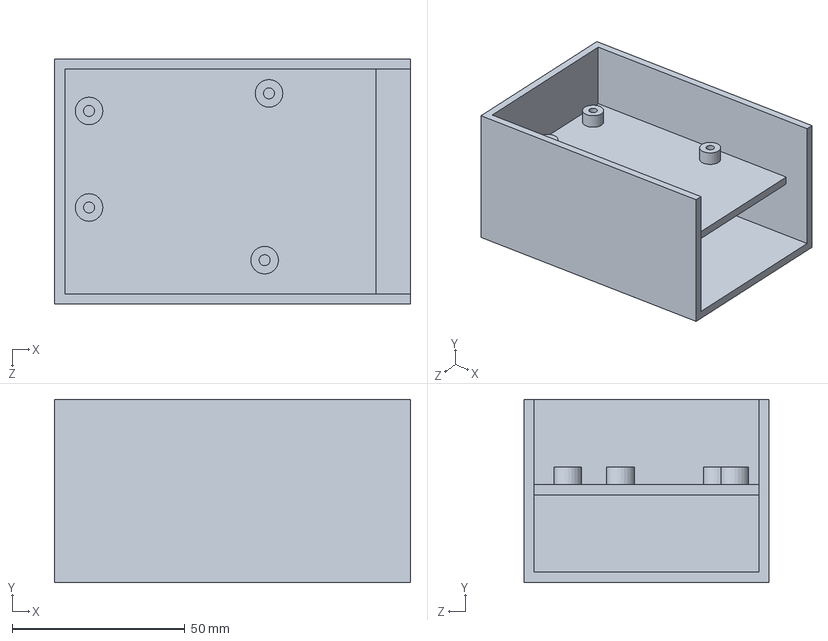
[picture p99: CAD file, 2022-07-28]
Pressure Tester/arduino box.SLDPRT
103.0 x 53.0 x 71.0 mm
