WCTE/WCTE_mPMT_mechanical/Quality Control/Backplate QC/backplate qc - side piece b.SLDPRT

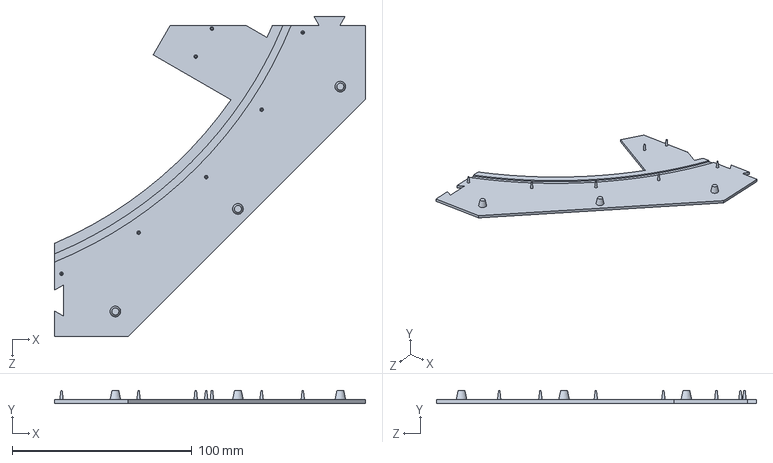
[picture p100: CAD file, 2022-12-23]
Quality Control/Backplate QC/backplate qc - side piece b.SLDPRT
173.0 x 7.00 x 178.0 mm
