WCTE/WCTE_mPMT_mechanical/Quality Control/Dome QC/dome pillar 8.SLDPRT

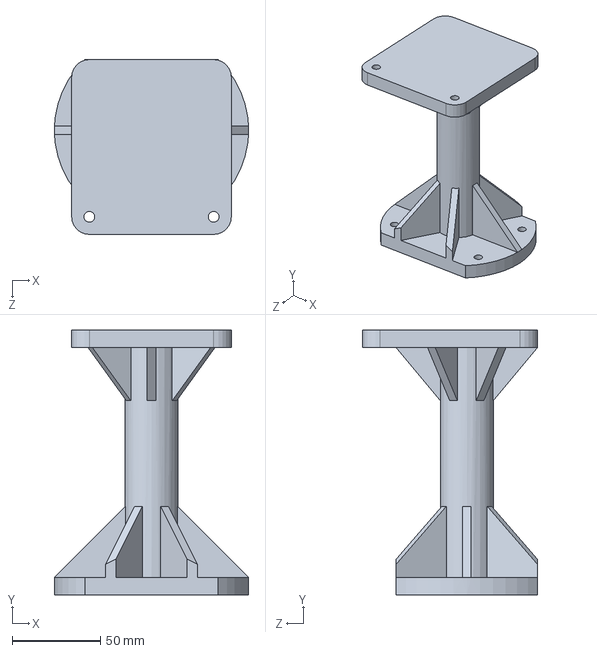
[picture p101: CAD file, 2022-12-23]
Quality Control/Dome QC/dome pillar 8.SLDPRT
110.0 x 150.0 x 99.0 mm
