WCTE/WCTE_mPMT_mechanical/Quality Control/Matrix QC/matrix pillar.SLDPRT

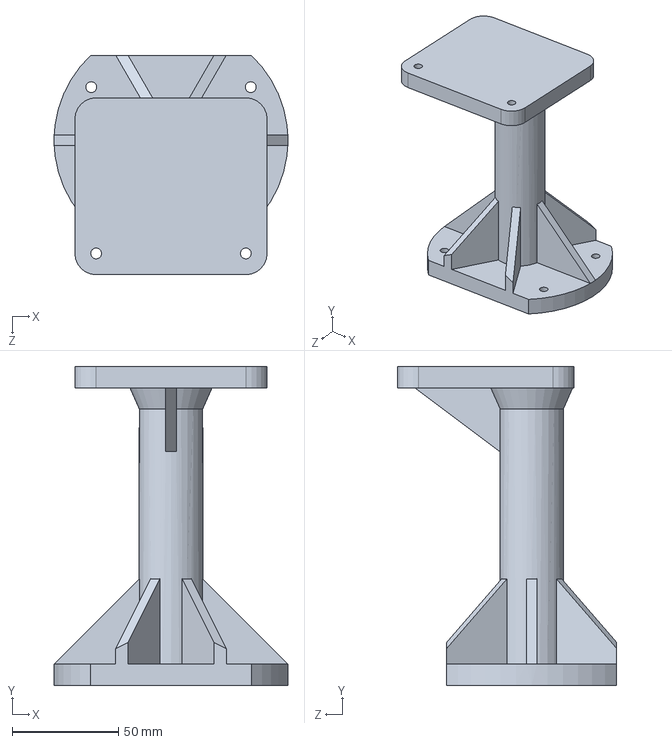
[picture p102: CAD file, 2022-12-23]
Quality Control/Matrix QC/matrix pillar.SLDPRT
110.0 x 150.0 x 103.2 mm
