WCTE/WCTE_mPMT_mechanical/Quality Control/PMT QC/back support.SLDPRT

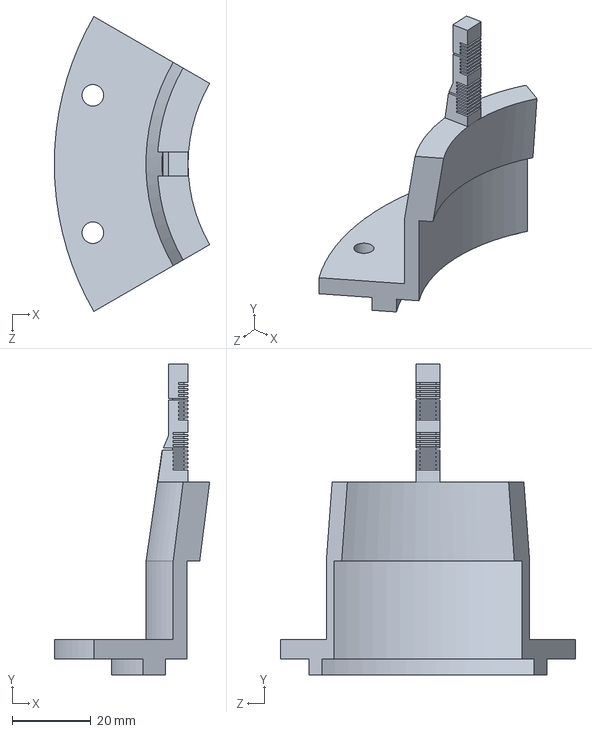
[picture p103: CAD file, 2022-12-23]
Quality Control/PMT QC/back support.SLDPRT
39.5 x 79.0 x 75.0 mm
