WCTE/WCTE_mPMT_mechanical/Gelling Jig Tabbed/STL file/nuttest.SLDPRT

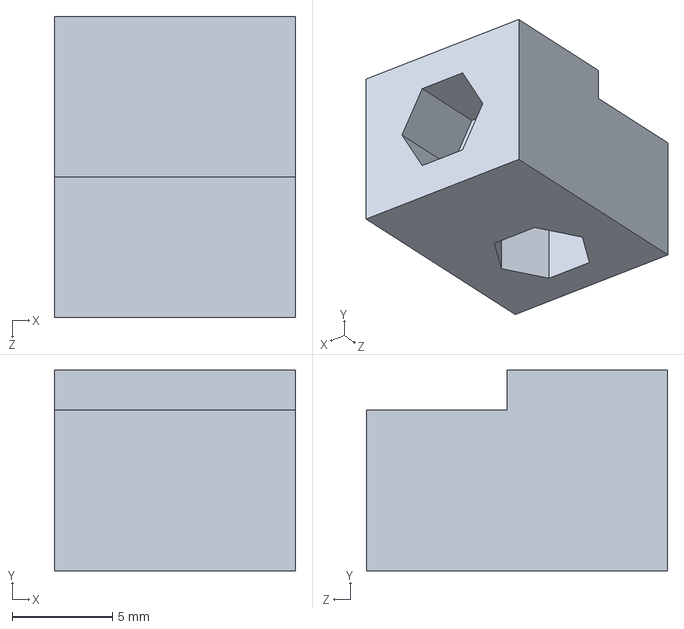
[picture p104: CAD file, 2022-05-10]
Gelling Jig Tabbed/STL file/nuttest.SLDPRT
12.0 x 10.0 x 15.0 mm
