WCTE/WCTE_mPMT_mechanical/important prints/Snap in Diffuser Holder - Outer.STL

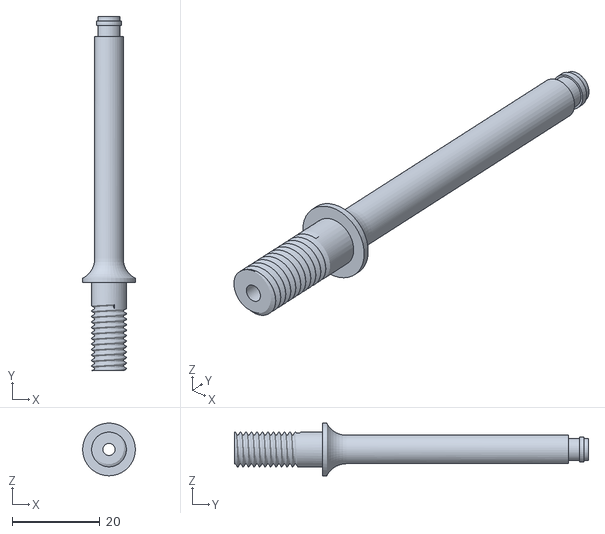
[picture p105: CAD file, 2023-06-13]
important prints/Snap in Diffuser Holder - Outer.STL
12.0 x 80.6 x 12.0
