WCTE/WCTE_mPMT_mechanical/mPMT Assembly/mPMT Assembly Dec. 2022/cylinder with groove Dec 21.SLDPRT

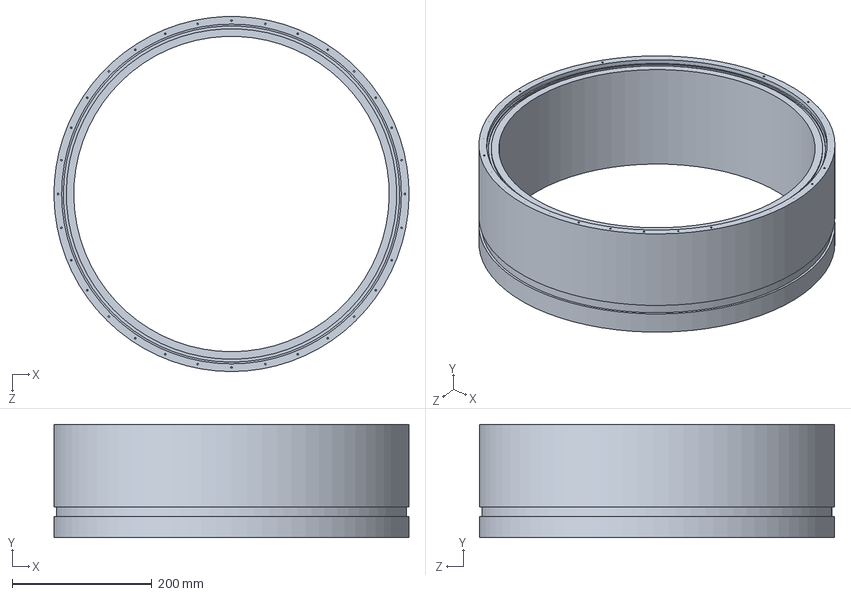
[picture p106: CAD file, 2022-12-23]
mPMT Assembly/mPMT Assembly Dec. 2022/cylinder with groove Dec 21.SLDPRT
507.9 x 161.8 x 508.0 mm
