WCTE/WCTE_mPMT_mechanical/mPMT Assembly/mPMT Assembly Oct. 2022/PCB_SFP.SLDPRT

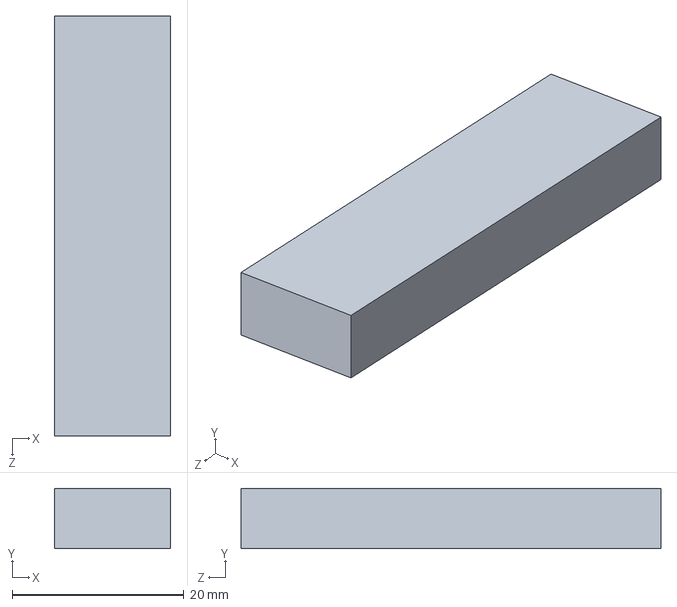
[picture p107: CAD file, 2022-10-26]
mPMT Assembly/mPMT Assembly Oct. 2022/PCB_SFP.SLDPRT
13.5 x 7.00 x 48.9 mm
