WCTE/WCTE_mPMT_mechanical/mPMT Assembly/Pillars/shorter pillar 4.0.6 101.1mm.SLDPRT

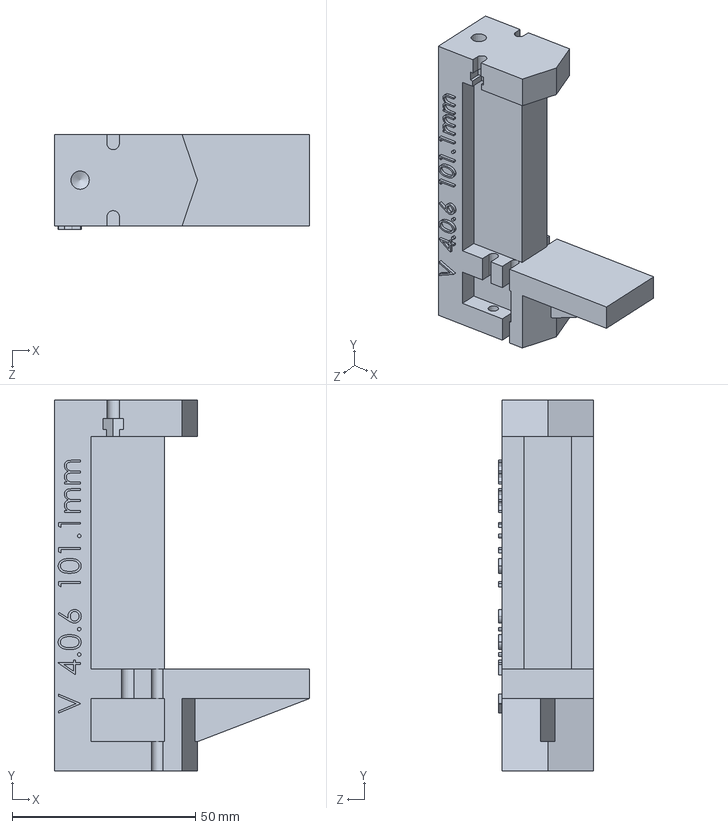
[picture p108: CAD file, 2022-12-21]
mPMT Assembly/Pillars/shorter pillar 4.0.6 101.1mm.SLDPRT
69.5 x 101.1 x 26.0 mm
