WCTE/WCTE_mPMT_mechanical/Pressure Tester/PCB Box wide.STEP

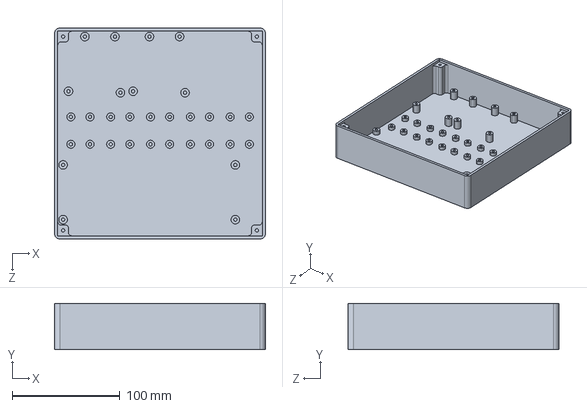
[picture p109: CAD file, 2022-07-28]
Pressure Tester/PCB Box wide.STEP
196.0 x 43.0 x 196.0 mm
