WCTE/WCTE_mPMT_mechanical/Quality Control/Backplate QC/backplate qc - middle piece b.SLDPRT

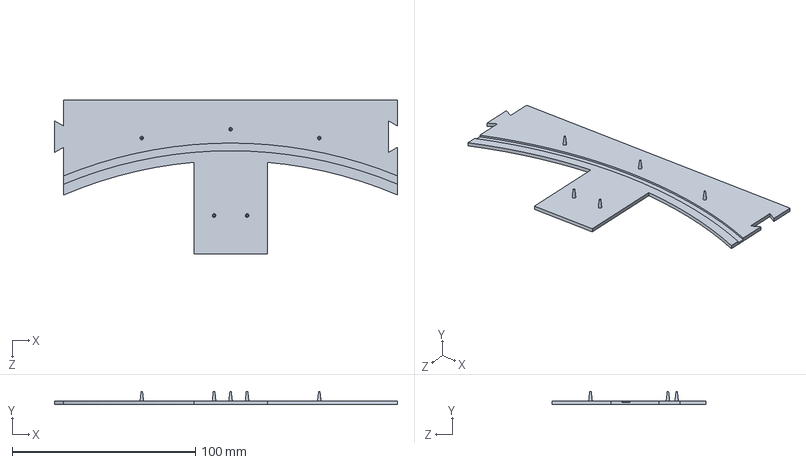
[picture p110: CAD file, 2022-12-23]
Quality Control/Backplate QC/backplate qc - middle piece b.SLDPRT
187.0 x 7.00 x 84.0 mm
