WCTE/WCTE_mPMT_mechanical/Quality Control/Matrix QC/dome clamp part 1 v2.1.1 SLDPRT.SLDPRT

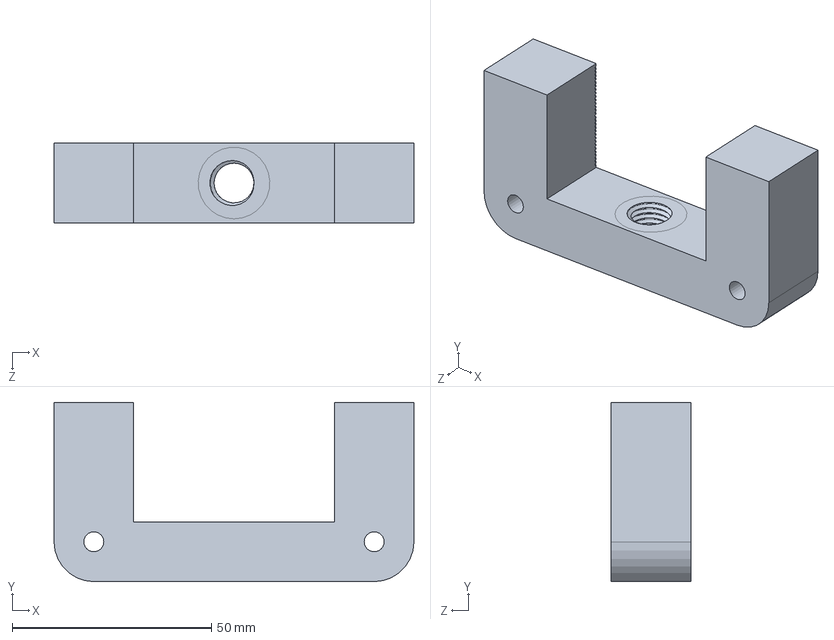
[picture p111: CAD file, 2022-12-23]
Quality Control/Matrix QC/dome clamp part 1 v2.1.1 SLDPRT.SLDPRT
90.4 x 45.0 x 20.0 mm
