WCTE/WCTE_mPMT_mechanical/Quality Control/PMT QC/central cup rev6 (1).SLDPRT

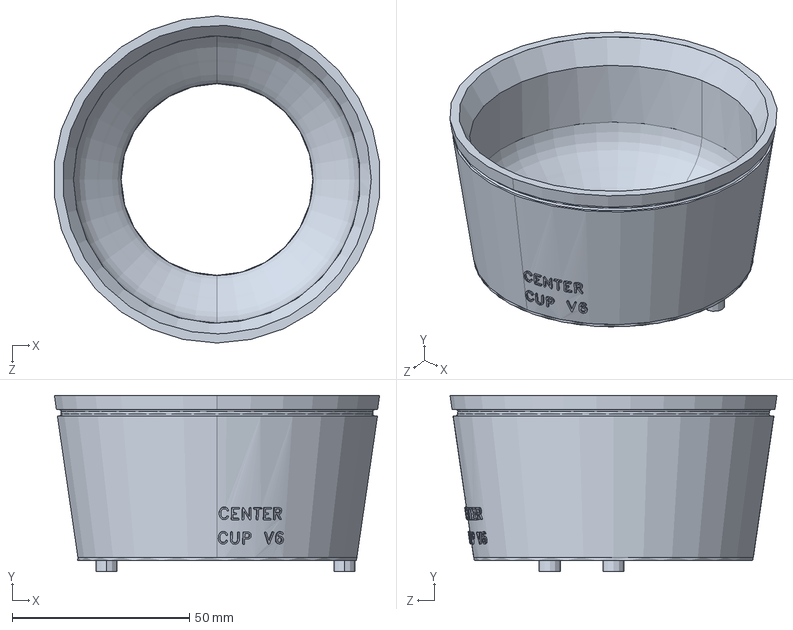
[picture p112: CAD file, 2022-12-23]
Quality Control/PMT QC/central cup rev6 (1).SLDPRT
91.9 x 49.7 x 92.4 mm
