WCTE/WCTE_mPMT_mechanical/Assembly Guide/40_4080_LITE_560_CL.SLDPRT

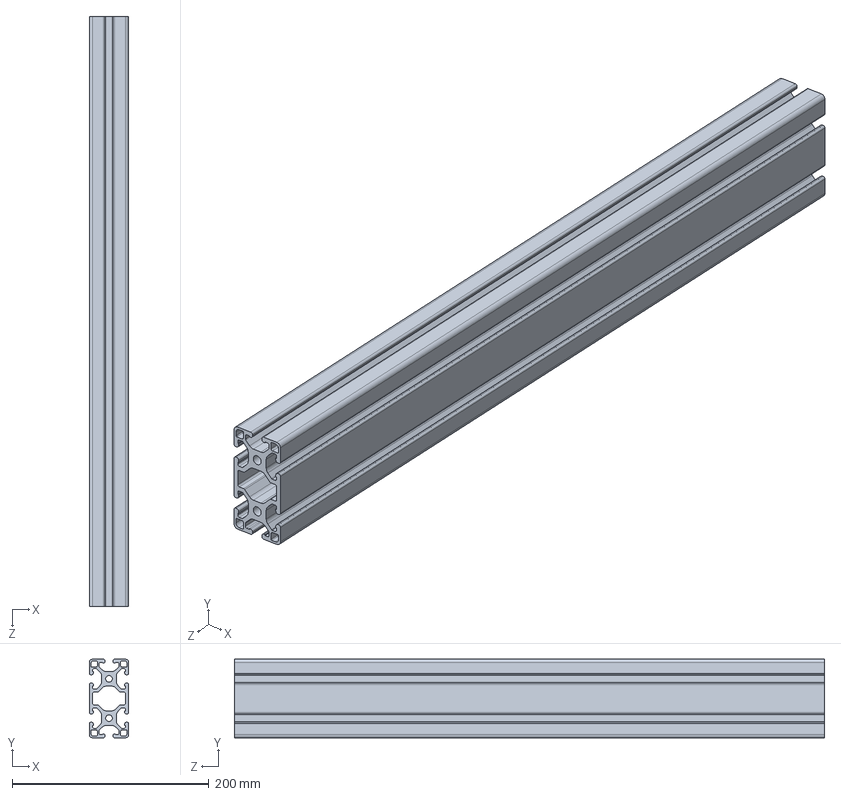
[picture p113: CAD file, 2022-12-22]
Assembly Guide/40_4080_LITE_560_CL.SLDPRT
40.0 x 80.0 x 600.0 mm
