WCTE/WCTE_mPMT_mechanical/Gelling Jig Tabbed/STL file/BottomMouldNew.STL

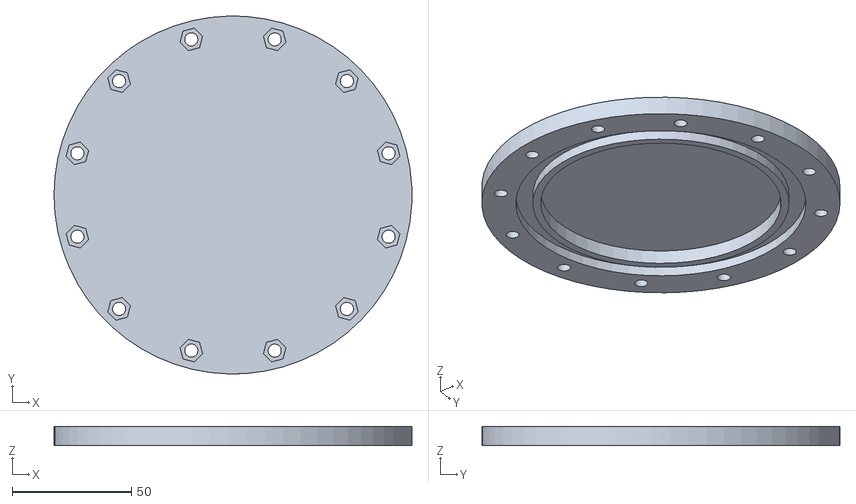
[picture p114: CAD file, 2022-05-10]
Gelling Jig Tabbed/STL file/BottomMouldNew.STL
150.0 x 150.0 x 8.00
