WCTE/WCTE_mPMT_mechanical/important prints/Bare Light Holder.STL

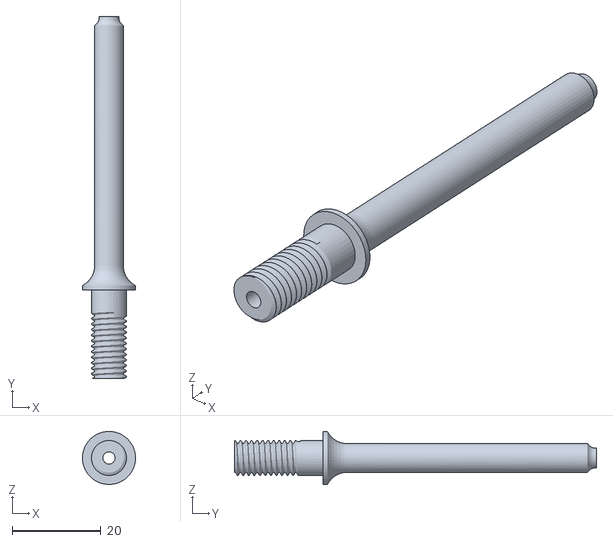
[picture p115: CAD file, 2023-06-13]
important prints/Bare Light Holder.STL
12.0 x 81.8 x 12.0
