WCTE/WCTE_mPMT_mechanical/mPMT Assembly/mPMT Assembly Dec. 2022/Pins_long_v5_15mm.SLDPRT

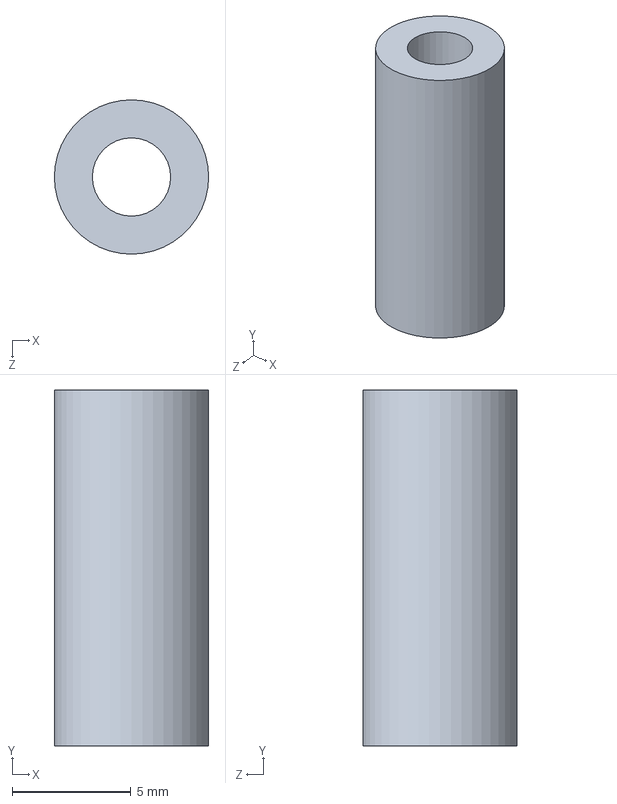
[picture p116: CAD file, 2022-12-23]
mPMT Assembly/mPMT Assembly Dec. 2022/Pins_long_v5_15mm.SLDPRT
6.50 x 15.0 x 6.50 mm
