WCTE/WCTE_mPMT_mechanical/Reflector Sheet/Reflector assembly v3.SLDASM

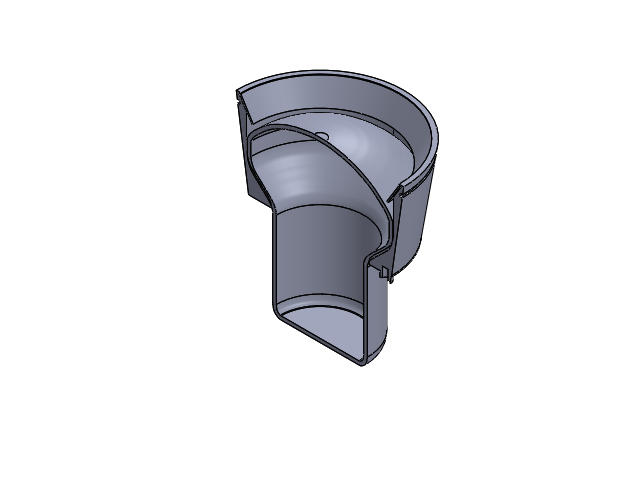
[picture p117: CAD file, 2022-08-09]
Reflector Sheet/Reflector assembly v3.SLDASM
central cup rev6
Reflector cone v2
Hollow PMT rev 2
