WCTE/WCTE_mPMT_mechanical/mPMT Assembly/mPMT Assembly Oct. 2022/PCB_centralEnclustraModule.SLDASM

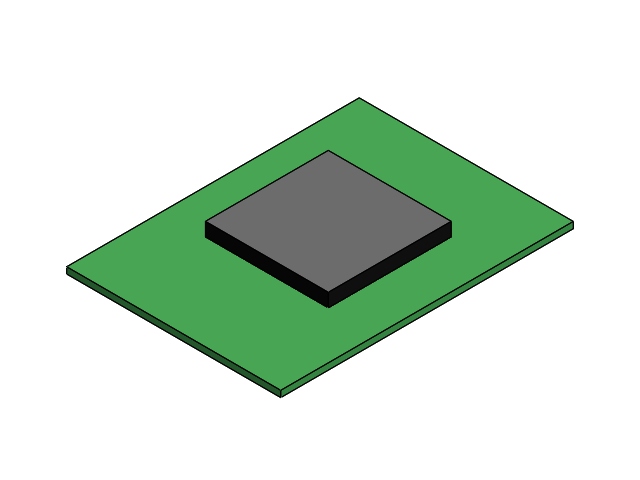
[picture p118: CAD file, 2022-10-26]
mPMT Assembly/mPMT Assembly Oct. 2022/PCB_centralEnclustraModule.SLDASM
Board^PCB_centralEnclustraModule
central block^PCB_centralEnclustraModule
Part3^PCB_centralEnclustraModule
