WCTE/WCTE_mPMT_mechanical/mPMT_Test_Stand-Spring2020/Assem_flowers_LN.SLDASM

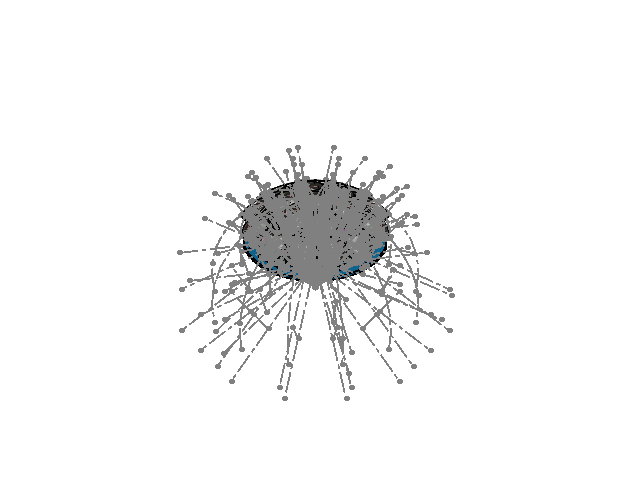
[picture p119: CAD file, 2022-05-10]
mPMT_Test_Stand-Spring2020/Assem_flowers_LN.SLDASM
matrix_mPMT_R14374_LN
PMT_mPMT_R14374_LN x 19
cup_mPMT_R14374_LN x 19
poron_mPMT_R14374_LN x 19
reflector_mPMT_R14374_LN x 19
gel_mPMT_R14374_LN x 19
