WCTE/WCTE_mPMT_mechanical/mPMT_Test_Stand-Spring2020/Assem_Cylinder_Dome_LN.SLDASM

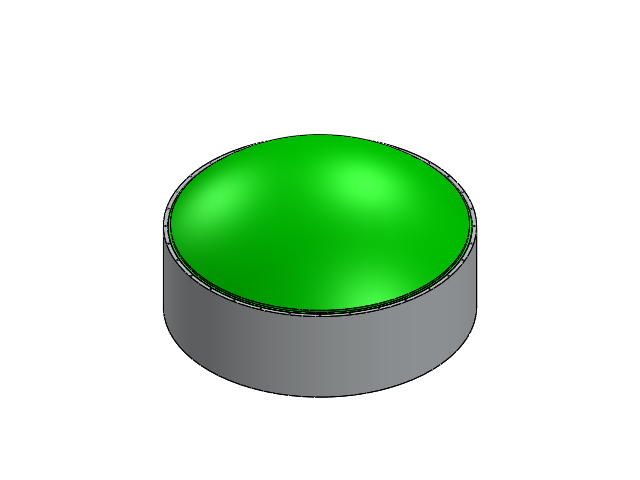
[picture p120: CAD file, 2022-05-10]
mPMT_Test_Stand-Spring2020/Assem_Cylinder_Dome_LN.SLDASM
Dome_mPMT_LN
Outer_Cylinder_mPMT_LN
