WCTE/WCTE_mPMT_mechanical/(list of files, cad)

Other CAD files:
mPMT Assembly/mPMT Assembly Dec. 2022/PMT center rev7.SLDASM
mPMT Assembly Interference/mPMT Assembly faceted ideal dimensions.SLDASM
mPMT Assembly/Assembly of PMT outer v4.SLDASM
mPMT Assembly/mPMT Assembly Oct. 2022/Assembly of PMT outer v4.SLDASM
mPMT Assembly/mPMT Assembly Shorter pillars.SLDASM
mPMT Assembly/mPMT Assembly Oct. 2022/Assembly of PMT center v4.SLDASM
mPMT Assembly/New Assembly.SLDASM
mPMT Assembly/mPMT Assembly Oct. 2022/Assem_detailed_PCB_board.SLDASM
mPMT Assembly/mPMT Assembly Oct. 2022/mPMT Assembly.SLDASM
mPMT Assembly/Assem_IWCD_R14374_SC.SLDASM
mPMT Assembly/PCB_centralEnclustraModule.SLDASM
mPMT Assembly/Feed Through Connector Assembly Weld.SLDPRT
mPMT Assembly/mPMT Assembly.SLDASM
mPMT Assembly/PMT RoC Test - Full.SLDPRT
mPMT Assembly/Assem_IWCD_PL_Penetrator.sldasm
mPMT Assembly/Assembly of PMT v2 Flat.SLDASM
mPMT Assembly/Feed Through Connector Assembly.SLDASM
Quality Control/Dome QC/Case.step.SLDPRT
Quality Control/Matrix QC/Case.step.SLDPRT
Quality Control/Pillar QC/Dial.step.SLDPRT
Assembly Guide/pillar_6mmMatrix_mPMT_Shubham_v4.0.1.STEP.SLDPRT
Faceted Matrix/Actual Dimensions/shorter pillar 4.0.4 107mm.SLDPRT
Faceted Matrix/Ideal Dimensions/Matrix Improved_4.10.STEP
mPMT Assembly/Pillars/shorter pillar 4.0.4_both_ways 107mm.SLDPRT
Pressure Tester/SparkFun_HX711_Load_Cell.STEP
Quality Control/Pillar QC/Glass.step.SLDPRT
Assembly Guide/backplate.SLDPRT
Faceted Matrix/Ideal Dimensions/Matrix Improved_4.9.STEP
mPMT Assembly/Pillars/shorter pillar 4.1.3 107mm - for cooling scheme.SLDPRT
Quality Control/Pillar QC/M2.5x3.7.step.SLDPRT
Dome + Cylinder Lowering Fixture/XDE2411.SLDPRT
Faceted Matrix/Actual Dimensions/shorter pillar 3.5mm.SLDPRT
Faceted Matrix/Ideal Dimensions/Matrix Improved_4.7.STEP
mPMT Assembly/Pillars/Aluminum Pillars/2020 Pillar Assembly/2020 Pillar Assembly/backplate.SLDPRT
Quality Control/Dome QC/Dial.step.SLDPRT
Quality Control/Pillar QC/Long pointer.step.SLDPRT
Faceted Matrix/Actual Dimensions/Outer_Cylinder_mPMT_SC Improved.SLDPRT
Faceted Matrix/Ideal Dimensions/Shubham Matrix Improved_4.3.STEP
Gelling Jig Tabbed/central cup rev7.SLDPRT
mPMT Assembly/mPMT Assembly Oct. 2022/shorter pillar 4.0.6 101.1mm.SLDPRT
Assembly Guide/40_4080_LITE_300_CL.SLDPRT
Assembly Guide/40_4080_LITE_480_CL.SLDPRT
Assembly Guide/6459K62_Linear Motion Shaft.SLDPRT
Assembly Guide/8590N32_High-Load Mounted Linear Ball Bearing (1).SLDPRT
Assembly Guide/94645A250_High-Strength Steel Nylon-Insert Locknut.SLDPRT
Assembly Guide/Dome.SLDPRT
Assembly Guide/Shubham Matrix Improved_4.1.STEP.SLDPRT
Assembly Guide/XDE2411.STEP.SLDPRT
Assembly Guide/cylinder.SLDPRT
Assembly Guide/leg 200mm 40_4040_LITE_200_CL.SLDPRT
Assembly Guide/mPMT Assembly.SLDASM
Assembly Guide/rod fixture.SLDPRT
Dome + Cylinder Lowering Fixture/11665A450_ROUND GRIP PULL HANDLE.SLDPRT
Dome + Cylinder Lowering Fixture/92625A516_STAINLESS STEEL WING-HEAD THUMB SCREW.SLDPRT
Dome + Cylinder Lowering Fixture/92625A527_STAINLESS STEEL WING-HEAD THUMB SCREW.SLDPRT
Dome + Cylinder Lowering Fixture/XDE2411.SLDDRW
Dome + Cylinder Lowering Fixture/XDE2431.SLDDRW
Dome + Cylinder Lowering Fixture/XDE2431.SLDPRT
Faceted Matrix/Actual Dimensions/Actual Gel.SLDPRT
Faceted Matrix/Actual Dimensions/Adapter_1mm.SLDPRT
Faceted Matrix/Actual Dimensions/Shubham Matrix Improved_4.1-01_Thicker_Flange.SLDPRT
Faceted Matrix/Actual Dimensions/Thicker Poron.SLDPRT
Faceted Matrix/Actual Dimensions/shorter pillar 3.5mm.STL
Faceted Matrix/Actual Dimensions/shorter pillar 4.0.3 107mm.STL
Faceted Matrix/Actual Dimensions/shorter pillar 4.0.4 107mm.STL
Faceted Matrix/Actual Dimensions/shorter pillar 4.0.5 106.11mm.STL
Faceted Matrix/Ideal Dimensions/Dome_mPMT_SC improved.SLDPRT
Faceted Matrix/Ideal Dimensions/Ideal Gel.SLDPRT
Faceted Matrix/Ideal Dimensions/Matrix Centering Jig.SLDPRT
Faceted Matrix/Ideal Dimensions/Matrix Improved_4.10.SLDPRT
Faceted Matrix/Ideal Dimensions/Matrix Improved_4.10.STL
Faceted Matrix/Ideal Dimensions/Matrix Improved_4.11.SLDPRT
Faceted Matrix/Ideal Dimensions/Matrix Improved_4.11.STL
Faceted Matrix/Ideal Dimensions/Matrix Improved_4.4.STEP
Faceted Matrix/Ideal Dimensions/Matrix Improved_4.4.STL
Faceted Matrix/Ideal Dimensions/Matrix Improved_4.7.SLDPRT
Faceted Matrix/Ideal Dimensions/Matrix Improved_4.7.STL
Faceted Matrix/Ideal Dimensions/Matrix Improved_4.9.SLDPRT
Faceted Matrix/Ideal Dimensions/Matrix Improved_4.9.STL
Faceted Matrix/Ideal Dimensions/Outer_Cylinder_mPMT_SC Improved.SLDPRT
Faceted Matrix/Ideal Dimensions/Shubham Matrix Improved_4.1-01.SLDPRT
Faceted Matrix/Ideal Dimensions/Shubham Matrix Improved_4.1-02.SLDPRT
Faceted Matrix/Ideal Dimensions/Shubham Matrix Improved_4.1-02.STEP
Faceted Matrix/Ideal Dimensions/Shubham Matrix Improved_4.1-02.STL
Faceted Matrix/Ideal Dimensions/Shubham Matrix Improved_4.3.SLDPRT
Faceted Matrix/Ideal Dimensions/Thicker Poron.SLDPRT
Faceted Matrix/Ideal Dimensions/XDE2255.SLDPRT
Faceted Matrix/Ideal Dimensions/XDE2411.SLDPRT
Faceted Matrix/Ideal Dimensions/cup progress rev3.SLDPRT
Faceted Matrix/Ideal Dimensions/cup progress rev4.SLDPRT
Faceted Matrix/Ideal Dimensions/cup progress rev4.STL
Faceted Matrix/Ideal Dimensions/pillar_6mmMatrix_mPMT_Shubham_v4.2.SLDPRT
Feedthrough with M12 connector/1424177.stp
Feedthrough with M12 connector/415371.stp.SLDPRT
Feedthrough with M12 connector/45555K514_Standard-Wall Butt-Weld Unthreaded Pipe Fitting.SLDPRT
Feedthrough with M12 connector/92290A058_Super-Corrosion-Resistant 316 Stainless Steel Socket Head Screw.SLDPRT
Feedthrough with M12 connector/93655A361_Male-Female Threaded Hex Standoff.SLDPRT
Feedthrough with M12 connector/BS-BF-HW-BUCHSE-CAT6A_SW0001.stp.SLDPRT
Feedthrough with M12 connector/M12 cable a.SLDPRT
Feedthrough with M12 connector/M12 cable b.SLDPRT
Feedthrough with M12 connector/cable.SLDPRT
Feedthrough with M12 connector/end cap.SLDPRT
Feedthrough with M12 connector/flange cover v3.SLDPRT
Feedthrough with M12 connector/innder flange v2.SLDPRT
Feedthrough with M12 connector/outer flange.SLDPRT
Feedthrough with M12 connector/plate.SLDPRT
Feedthrough with M12 connector/support plate.SLDPRT
Gelling Jig Tabbed/AcrylicPlate.SLDPRT
Gelling Jig Tabbed/BottomMould.SLDPRT
Gelling Jig Tabbed/Flange Gasket Removable.SLDPRT
Gelling Jig Tabbed/Flange Gasket.SLDPRT
Gelling Jig Tabbed/Gasket.SLDPRT
Gelling Jig Tabbed/Machined_BottomMould.SLDPRT
Gelling Jig Tabbed/Machined_BottomMould.STL
Gelling Jig Tabbed/PMTClamp_part1.SLDPRT
Gelling Jig Tabbed/PMTClamp_part2.SLDPRT
Gelling Jig Tabbed/STL file/BottomMould.STL
Gelling Jig Tabbed/STL file/Flange Gasket Removable.STL
Gelling Jig Tabbed/STL file/Flange Gasket.STL
Gelling Jig Tabbed/STL file/Gasket.STL
Gelling Jig Tabbed/STL file/PMTClamp_part1.STL
Gelling Jig Tabbed/STL file/PMTClamp_part2.STL
Gelling Jig Tabbed/STL file/TopMouldLeft - Flanged Gasket.STL
Gelling Jig Tabbed/STL file/TopMouldLeft.STL
Gelling Jig Tabbed/STL file/TopMouldRight - Flanged Gasket.STL
Gelling Jig Tabbed/STL file/TopMouldRight.STL
Gelling Jig Tabbed/STL file/central cup rev4.STL
Gelling Jig Tabbed/STL file/central cup rev5.STL
Gelling Jig Tabbed/STL file/central cup rev6.STL
Gelling Jig Tabbed/STL file/nuttest.STL
Gelling Jig Tabbed/STL file/outer cup rev5.STL
Gelling Jig Tabbed/STL file/outer cup rev6.STL
Gelling Jig Tabbed/TopMouldLeft - Flanged Gasket - v4 - for printing.SLDPRT
Gelling Jig Tabbed/TopMouldLeft - Flanged Gasket.SLDPRT
Gelling Jig Tabbed/TopMouldLeft.SLDPRT
Gelling Jig Tabbed/TopMouldMaster.SLDPRT
Gelling Jig Tabbed/TopMouldRight - Flanged Gasket - v4 - for printing.SLDPRT
Gelling Jig Tabbed/TopMouldRight - Flanged Gasket.SLDPRT
Gelling Jig Tabbed/TopMouldRight.SLDPRT
Gelling Jig Tabbed/central cup rev4.SLDPRT
Gelling Jig Tabbed/central cup rev5.SLDPRT
Gelling Jig Tabbed/central cup rev6.SLDPRT
Gelling Jig Tabbed/nuttest.SLDPRT
Gelling Jig Tabbed/outer cup rev10.SLDPRT
Gelling Jig Tabbed/outer cup rev6.SLDPRT
Gelling Jig Tabbed/outer cup rev8.SLDPRT
Pressure Tester/Load cell.SLDPRT
Pressure Tester/PCB Box wide.SLDPRT
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
