WCTE/WCTE_mPMT_mechanical/Assembly Guide/readme.md

A assembly guide used to assist the lowering process of dome and cylinder, to prevent any shifting or tilting.
