WCTE/WCTE_mPMT_mechanical/mPMT Assembly/mPMT Assembly Dec. 2022/readme.md

This is the folder that holds latest mPMT assembly as of December 2022
