WCTE/WCTE_mPMT_mechanical/mPMT Assembly/Pillars/Aluminum Pillars/2020 Pillar Assembly/readme.md

This folder contains the 2020 Pillar Assembly and all the SW parts, as well as a pack-and-go version of the assembly.
