WCTE/WCTE_mPMT_mechanical/mPMT Assembly/Pillars/readme.md

This folder contains pillars of different lengths to accommodate different matrixes.
