WCTE/WCTE_mPMT_mechanical/mPMT Assembly/Pillars/Aluminum Pillars/readme.md

This folder contains two designs utilizing aluminum pillars
