WCTE/WCTE_mPMT_mechanical/mPMT Assembly Interference/Photos/Interference new actual.PNG

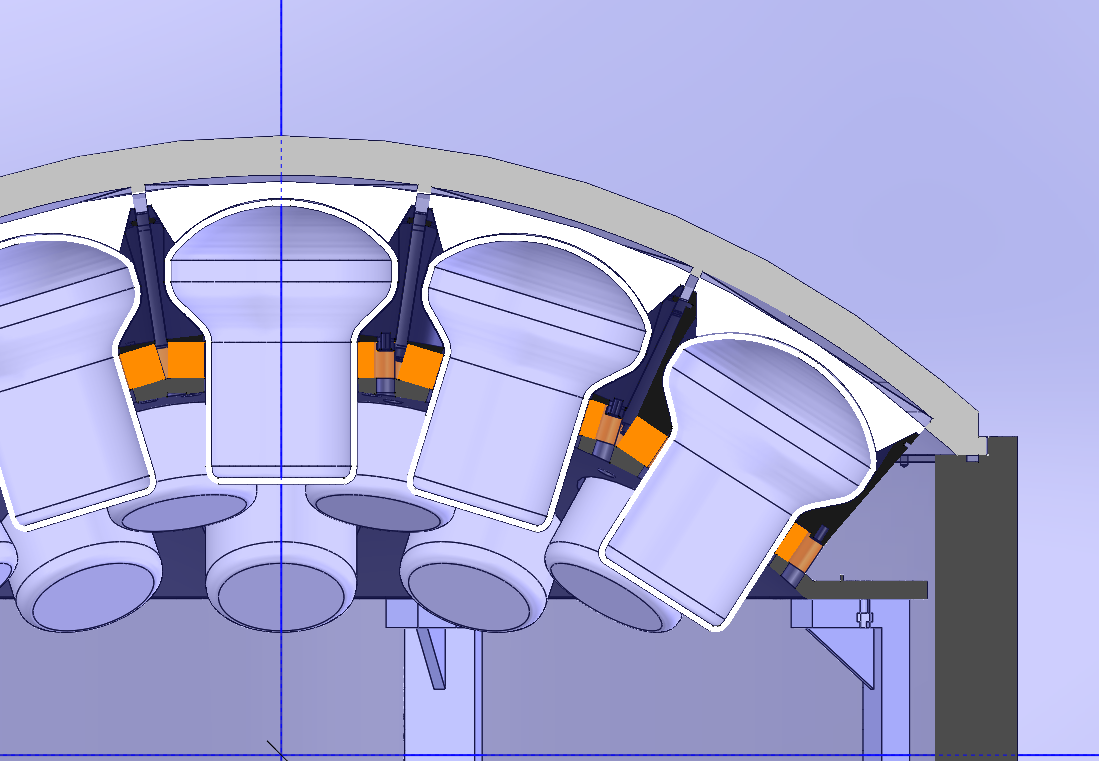
mPMT Assembly Interference/Photos/Interference new actual.PNG
