WCTE/WCTE_mPMT_mechanical/mPMT Assembly Interference/Photos/new PMT.PNG

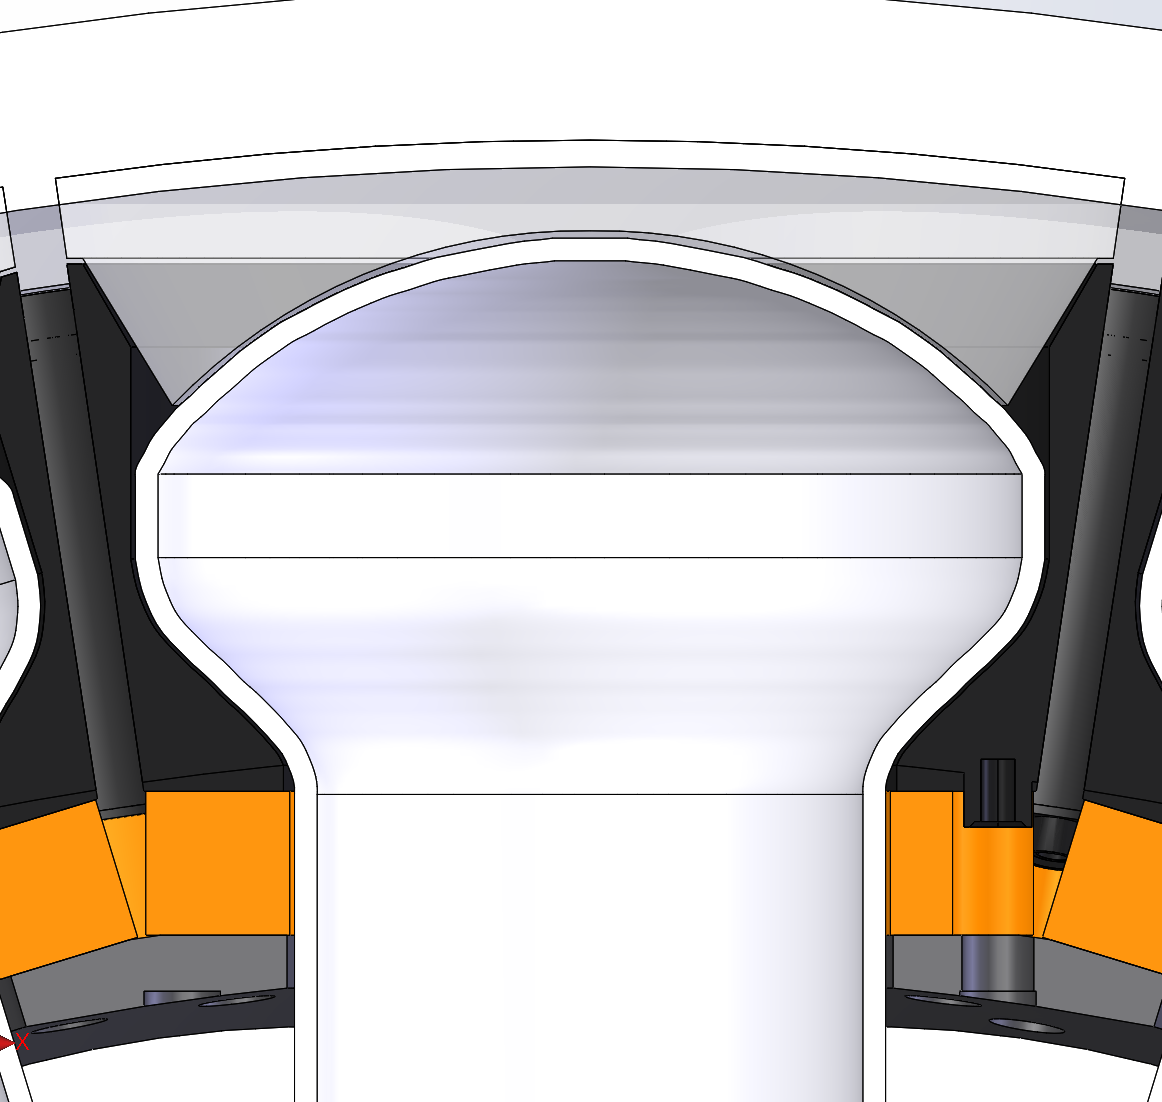
mPMT Assembly Interference/Photos/new PMT.PNG
