WCTE/WCTE_mPMT_mechanical/Faceted Matrix/Actual Dimensions/shorter pillar 4.0.5 106.11mm.pdf

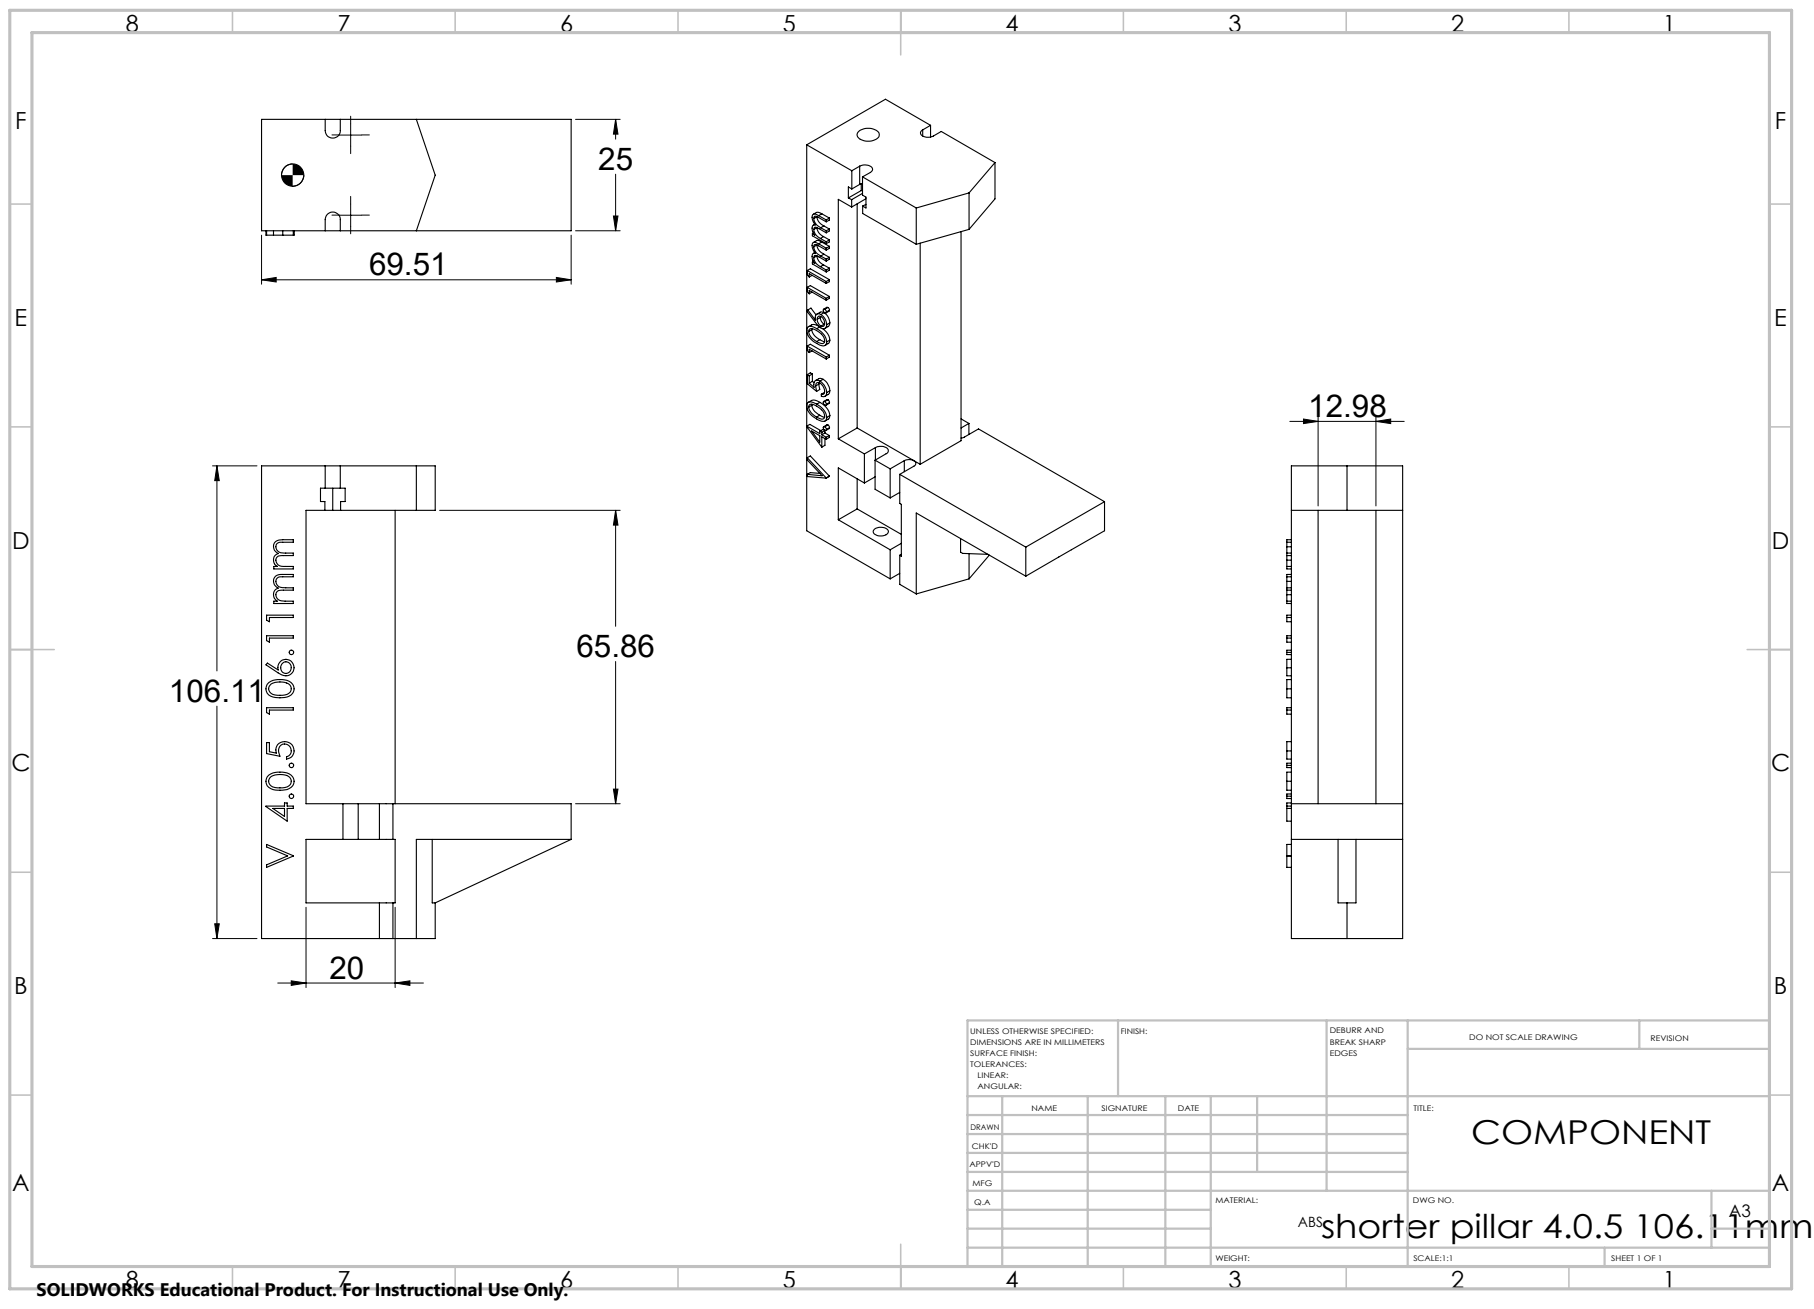
[picture p124: page 1]
FINISH:; DEBURR AND; BREAK SHARP; DO NOT SCALE DRAWING; REVISION; SCALE:1:1; SHEET 1 OF 1; shorter pillar 4.0.5 106.11mm

UNLESS OTHERWISE SPECIFIED:
DIMENSIONS ARE IN MILLIMETERS
SURFACE FINISH:
TOLERANCES:
LINEAR:
ANGULAR:

NAME | SIGNATURE | DATE | | | | TITLE: COMPONENT

DRAWN
CHK'D
APPV'D
MFG
Q.A | | | | MATERIAL: | DWG NO. | A3 ABS

SOLIDWORKS Educational Product. For Instructional Use Only.
