WCTE/WCTE_mPMT_mechanical/Reflector Sheet/Reflector sheet drawing.pdf

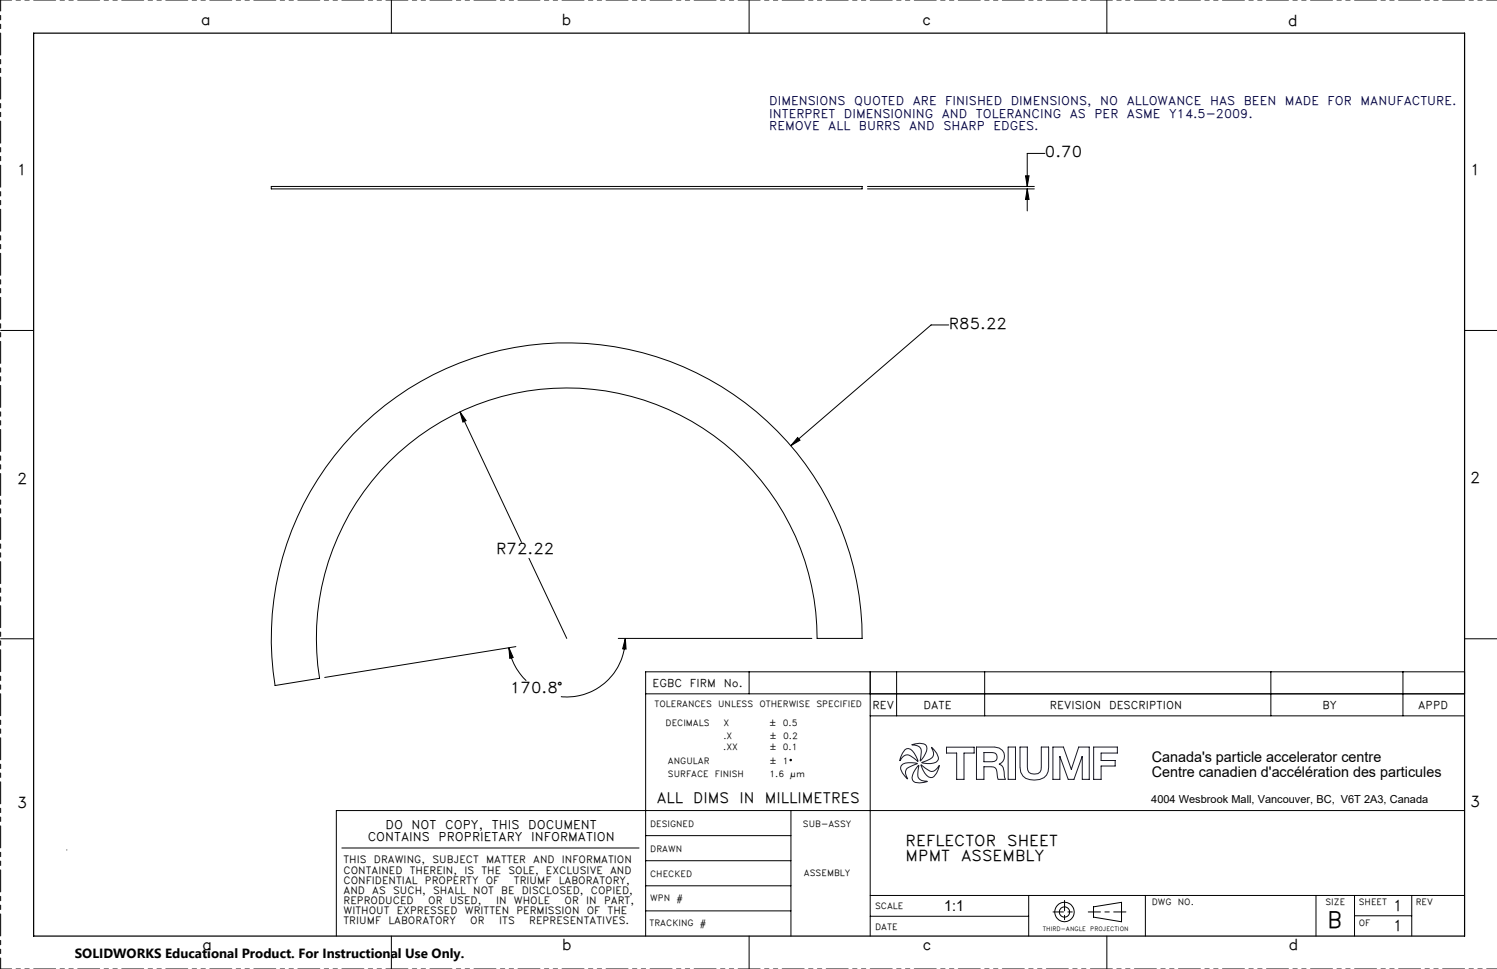
[picture p125: page 1]
WPN #; TRACKING #; REFLECTOR SHEET MPMT ASSEMBLY

DIMENSIONS QUOTED ARE FINISHED DIMENSIONS, NO ALLOWANCE HAS BEEN MADE FOR MANUFACTURE.
INTERPRET DIMENSIONING AND TOLERANCING AS PER ASME Y14.5-2009.
REMOVE ALL BURRS AND SHARP EDGES.

EGBC FIRM No.

TOLERANCES UNLESS OTHERWISE SPECIFIED DECIMALS X ± 0.5 .X ± 0.2 .XX ± 0.1 ANGULAR ± 1 SURFACE FINISH 1.6 µm ALL DIMS IN MILLIMETRES | REV | DATE | REVISION DESCRIPTION | BY | APPD

Canada's particle accelerator centre
Centre canadien d'accélération des particules

4004 Wesbrook Mall, Vancouver, BC, V6T 2A3, Canada

DO NOT COPY, THIS DOCUMENT
CONTAINS PROPRIETARY INFORMATION
THIS DRAWING, SUBJECT MATTER AND INFORMATION
CONTAINED THEREIN, IS THE SOLE, EXCLUSIVE AND
CONFIDENTIAL PROPERTY OF TRIUMF LABORATORY,
AND AS SUCH, SHALL NOT BE DISCLOSED, COPIED,
REPRODUCED OR USED, IN WHOLE OR IN PART,
WITHOUT EXPRESSED WRITTEN PERMISSION OF THE
TRIUMF LABORATORY OR ITS REPRESENTATIVES.

1:1 SCALE | THIRD-ANGLE PROJECTION | DWG NO. | SIZE B | SHEET 1 | REV
DATE | | | | OF 1

SOLIDWORKS Educational Product. For Instructional Use Only.
