WCTE/WCTE_mPMT_mechanical/(commit log)

2022-05-10 Transferring up-to-date files from previous IWCD repository
    [1151A610_SURFACE-MOUNT LIFT-OFF HINGE WITH HOLES.SLDPRT, 11665A450_ROUND GRIP PULL HANDLE.SLDPRT, 1734A120_EXTERNAL COMPRESSION SPRING DRAW LATCH.SLDPRT, 5537T291_ALUMINUM T-SLOTTED FRAMING EXTRUSION.SLDPRT, 5537T462_SCREW ON ROLLER.SLDPRT, 5537T468_SCREW ON ROLLER WITH GUIDE RAIL.SLDPRT, 5537T471_ALUMINUM T-SLOTTED FRAMING EXTRUSION.SLDPRT, 5537T518_T-SLOTTED FRAMING.SLDPRT]
2022-05-18 Added reflector sheet assemblies, updated most recent mPMT Assembly rev 4.1 file to include correct dimensions
    [Assembly Progress rev4.1.SLDASM, Assembly of PMT center v4.SLDASM, Assembly of PMT centre v3.SLDASM, Assembly of PMT outer v4.SLDASM, Optical_gel.SLDPRT, Reflector assembly.SLDASM, Reflector cone.SLDPRT, Reflector cone.STL]
2022-05-24 Updated reflector sheet design, 4 ideal/actual dimensioned assemblies
    [Assembly Progress rev4.0.SLDASM, Assembly Progress rev4.1.SLDASM, Assembly of PMT centre v3.SLDASM, Assembly of PMT outer v3.SLDASM, GellingRigAssembly - Flanged Gasket.SLDASM, Reflector cone.SLDPRT, Reflector cone.STL, Reflector sheet drawing.SLDDRW]
2022-06-13 Updated pillar dimensions for actual assemblies, added documentation on reflector sheets
    [Corrected_Actual_Dome.SLDPRT, Dome_mPMT_SC improved.SLDPRT, Reflector assembly.SLDASM, Reflector cone.SLDPRT, Reflector cone.STL, Reflector sheet drawing.SLDDRW, Reflector sheet.SLDPRT, Reflector sheet.STL]
2022-07-28 Updating matrix design, added new reflector sheet and PCB box folders
    [Cable Gasket Double.SLDPRT, Cable Gasket Double.STL, Cable Gasket Single.SLDPRT, Cable Gasket Single.STL, Flange Gasket Removable.SLDPRT, Flange Gasket Removable.STL, Flange Gasket.SLDPRT, Flange Gasket.STL]
2022-08-09 Added step file for mPMT actual-dimensions assembly.
    [Assembly Progress rev4.1.SLDASM, Assembly of PMT outer v4.SLDASM, GellingRigAssembly - Flanged Gasket.SLDASM, Reflector assembly v3.SLDASM, Reflector assembly.SLDASM, Shubham Matrix Improved_4.1-02.SLDPRT, TopMouldLeft - Flanged Gasket.STL, central cup rev5.SLDPRT]
2022-09-06 Added new Shubham_Matrix_Improved_4.1-02.SLDPRT file, with double the dome thickness.
    [PMTClamp_part1.SLDPRT, PMTClamp_part1.STL, PMTClamp_part2.SLDPRT, PMTClamp_part2.STL, Shubham Matrix Improved_4.1-02.SLDPRT, Shubham Matrix Improved_4.1-02.STEP, Shubham Matrix Improved_4.1-02.STL, Shubham Matrix Improved_4.1-03.SLDPRT]
2022-09-07 Updated version number and flange thickness of Shubham Matrix improved 4.3. Now 12 mm thickness everywhere.
    [Shubham Matrix Improved_4.1-03.SLDPRT, Shubham Matrix Improved_4.1-03.STEP, Shubham Matrix Improved_4.1-03.STL, Shubham Matrix Improved_4.3.SLDPRT]
2022-09-08 SLDPRT, STL, and pdf of pillar 4.04 and 4.0.5
    [shorter pillar 4.0.4 107mm.SLDPRT, shorter pillar 4.0.4 107mm.STL, shorter pillar 4.0.5 106.11mm.SLDPRT, shorter pillar 4.0.5 106.11mm.STL]
2022-09-09 Made a STEP version of thicker matrix
    [Shubham Matrix Improved_4.3.STEP]
2022-09-16 Uploaded Matrix Improved_4.4
    Changed the dome thickness to 12mm
    [Matrix Improved_4.4.SLDPRT, Matrix Improved_4.4.STEP, Matrix Improved_4.4.STL]
2022-09-21 Added pack-and-go .zip file in mPMT Assembly Interface folder, titled mPMT Assembly faceted actual dimensions. This file contains a full package of the most recent version of our mPMT assembly.
2022-09-26 upload reflector sheet v4 (based on v2)
    created reflector sheet v4 by adding notches to v2
    [Reflector sheet v4.SLDPRT, Reflector sheet v4.STL]
2022-10-26 Updates from the old assembly
2022-10-26 Uploaded the latest assembly as of Oct. 2022
    [Adhesive.SLDPRT, Assem_IWCD_PL_Penetrator.sldasm, Assem_detailed_PCB_board.SLDASM, Assembly Progress rev4.2.SLDASM, Assembly of PMT center v4.SLDASM, Assembly of PMT outer v4.SLDASM, Bent Cable.SLDPRT, Corrected_Actual_Dome.SLDPRT]
2022-10-26 Uploaded the latest mPMT assembly as of Oct. 2022
2022-10-27 Uploaded new cylinder with 19.5mm dowel pin hole
    [XDE2431.SLDPRT]
2022-12-03 Uploaded the files of the new feedthrough
    [1424177.stp.SLDASM, 2 wires.SLDPRT, 415371.stp.SLDPRT, 45555K514_Standard-Wall Butt-Weld Unthreaded Pipe Fitting.SLDPRT, 8mm cable v4.SLDPRT, 8mm cable.SLDPRT, 92290A058_Super-Corrosion-Resistant 316 Stainless Steel Socket Head Screw.SLDPRT, 92290A124_Super-Corrosion-Resistant 316 Stainless Steel Socket Head Screw (1).SLDPRT]
2022-12-03 Rename feedthrough with M12 connector/updates.md to Feedthrough with M12 connector/updates.md
2022-12-07 Uploaded sw part files of reinforced moulds (v4)
    [TopMouldLeft - Flanged Gasket - v4 - for printing.SLDPRT, TopMouldRight - Flanged Gasket - v4 - for printing.SLDPRT]
2022-12-07 Uploaded .STL files of reinforced moulds (v4)
    [18 TopMouldLeft - Flanged Gasket - v4 - for printing.STL, 18 TopMouldRight - Flanged Gasket - v4 - for printing.STL]
2022-12-21 uploaded PLA pillars
    [shorter pillar 4.0.4_both_ways 107mm.SLDPRT, shorter pillar 4.0.6 101.1mm.SLDPRT, shorter pillar 4.1.2 101.1mm - for cooling scheme.SLDPRT, shorter pillar 4.1.3 107mm - for cooling scheme.SLDPRT]
2022-12-21 Uploaded new reflector model
    Reflector V4, used for manufacturing
    [XDE2580_modified.SLDPRT]
2022-12-22 Uploaded the new moulds
2022-12-22 Uploaded the new cups
    [central cup rev7.SLDPRT, outer cup rev10.SLDPRT, outer cup rev8.SLDPRT]
2022-12-22 Uploaded video of feedthrough assembly steps
2022-12-22 Create a folder for 2020 Pillar Assembly
2022-12-22 Upload files of 2020 Pillar Assembly
    [14122_m.sldprt, 20 20 assembly v2.SLDASM, 20_2020_101_1_CL.sldprt, 20_4119.sldprt, Matrix Improved_4.6.SLDPRT, PCB_board.SLDPRT, backplate.SLDPRT, mPMT Assembly.SLDASM]
2022-12-22 Uploaded the assembly guide files
    [40_4080_LITE_300_CL.SLDPRT, 40_4080_LITE_480_CL.SLDPRT, 40_4080_LITE_560_CL.SLDPRT, 6459K62_Linear Motion Shaft.SLDPRT, 8590N32_High-Load Mounted Linear Ball Bearing (1).SLDPRT, 94645A250_High-Strength Steel Nylon-Insert Locknut.SLDPRT, Assem_IWCD_R14374_SC.SLDASM, Dome.SLDPRT]
2022-12-22 Upload the gelling pad and the slanted PMT clamp
    [PMTClamp_part1 v4 slanted.SLDPRT, gelling pad.SLDPRT]
2022-12-23 upload backplate qc
    [XDE2411.SLDPRT, backplate check.SLDASM, backplate qc - middle piece a.SLDPRT, backplate qc - middle piece b.SLDPRT, backplate qc - sheet.SLDPRT, backplate qc - side piece a.SLDPRT, backplate qc - side piece b.SLDPRT, backplate qc.SLDPRT]
2022-12-23 Uploaded a newer version of M12 feedthrough
    [1424177.stp, 2 wires.SLDPRT, 415371.stp.SLDPRT, 45555K514_Standard-Wall Butt-Weld Unthreaded Pipe Fitting.SLDPRT, 8mm cable v4.SLDPRT, 92290A058_Super-Corrosion-Resistant 316 Stainless Steel Socket Head Screw.SLDPRT, 93655A361_Male-Female Threaded Hex Standoff.SLDPRT, BS-BF-HW-BUCHSE-CAT6A_SW0001.stp.SLDPRT]
2022-12-23 Upload dome qc files
    [Case.step.SLDPRT, Corrected_Actual_Dome.SLDPRT, Cover knob.step.SLDPRT, Dial.step.SLDPRT, dome clamp part 1 v2.SLDPRT, dome clamp part 2 v2.1.1.SLDPRT, dome pillar 4.SLDPRT, dome pillar 8.SLDPRT]
2022-12-23 Upload matrix qc files
    [Back screw.step.SLDPRT, Case.step.SLDPRT, Cover knob.step.SLDPRT, Dial.step.SLDPRT, Glass.step.SLDPRT, Knurled screw.step.SLDPRT, Long pointer.step.SLDPRT, M2.5x3.7.step.SLDPRT]
2022-12-23 Upload Pillar QC files
    [Cover knob.step.SLDPRT, Dial.step.SLDPRT, Glass.step.SLDPRT, Knurled screw.step.SLDPRT, Long pointer.step.SLDPRT, M2.5x3.7.step.SLDPRT, nob.SLDPRT]
2022-12-23 Upload files of PMT QC
    [BottomMould.SLDPRT, Hollow PMT rev 2.SLDPRT, Optical_gel.SLDPRT, PMT QC.SLDASM, PMT on Jelling Jig.SLDASM, back support.SLDPRT, center reference.SLDPRT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]
2022-12-23 Upload the mPMT assembly Dec 2022
    [Hollow PMT rev 2.SLDPRT, Matrix Improved_4.5 fixed.SLDPRT, Optical_gel.SLDPRT, PMT center rev7.SLDASM, PMT outer rev8.SLDASM, Pins_long_v5_15mm.SLDPRT, XDE2411.sldprt, XDE2431.SLDPRT]
2022-12-23 Uploade mPMT assembly Dec 2022
    [Hollow PMT rev 2.SLDPRT, Matrix Improved_4.5 fixed.SLDPRT, Optical_gel.SLDPRT, PMT center rev7.SLDASM, PMT outer rev8.SLDASM, Pins_long_v5_15mm.SLDPRT, XDE2411.sldprt, XDE2432.SLDPRT]
2022-12-24 Upload LED diffuser holder
    [LED diffuser holder.SLDPRT]
2023-01-27 Add files via upload
    Updated "Matrix Improved 4.1" to have compatibility w/ aluminum columns
    [Matrix Improved_4.7.SLDPRT, Matrix Improved_4.7.STEP, Matrix Improved_4.7.STL]
2023-01-27 Updated "Matrix Improved 4.1" to have compatibility w/ aluminum columns
    Adjusted positioning of holes, removed unused holes and added 6mm holes for aluminum pillars
    [Matrix Improved_4.7.SLDPRT, Matrix Improved_4.7.STEP, Matrix Improved_4.7.STL]
2023-01-27 Updated "Matrix Improved 4.1" to "Matrix Improved 4.7"
    Added 6mm holes for aluminum column compatibility, adjusted positioning of original holes, removed unused holes
    [Matrix Improved_4.7.SLDPRT, Matrix Improved_4.7.STEP, Matrix Improved_4.7.STL]
2023-03-01 Uploaded PMT test stand zip file
    Contains assembly, and all relevant files (board, pins, cups, etc...)
2023-03-01 Uploading LED Diffuser Holder V3
    Compatible with thin (6mm) matrix
    [LED diffuser holder V3.SLDPRT, LED diffuser holder V3.STL]
2023-03-31 Uploading O-ring Model
    5mm cross section, 105 mm ID
    [1302N351_Oil-Resistant Buna-N O-Ring.SLDPRT]
2023-05-26 Updated Matrix 4.7 to Matrix 4.9
    Added additional holes for LED holders and updated the size of the central pin holes to match the rest
    [Matrix Improved_4.9.SLDPRT, Matrix Improved_4.9.STEP, Matrix Improved_4.9.STL]
2023-06-08 Uploading .stl of latest 3D printed mPMT components 08/06/23
    Collar, Funnel Holder, Center Cup, Outer Cup, Short Pin, Long Pin
    [Collar V1.STL, Funnel Clamp V7C.STL, Long Pins 120523.STL, Short Pins 120523.STL, central cup rev 10.STL, outer cup rev10.STL]
2023-06-09 Updated Matrix 4.7 to Matrix 4.9
    Added additional holes for LED holders, updated the size of the central pin holes to match the rest, and removed partial holes on underside
    [Matrix Improved_4.9.SLDPRT, Matrix Improved_4.9.STEP, Matrix Improved_4.9.STL]
2023-06-13 Uploading LED holder .stl
    Bare LED, PM3, and snap-on
    [Bare Light Holder.STL, PM3 Holder.STL, Snap in Diffuser Holder - Outer.STL]
2023-06-14 Updated matrix 4.9 to matrix 4.10
    Changed M8 Tapped holes to 8.4mm through holes
    [Matrix Improved_4.10.SLDPRT, Matrix Improved_4.10.STEP, Matrix Improved_4.10.STL]
2023-06-19 Updating matrix 4.9 to 4.10
    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
    [Matrix Improved_4.10.SLDPRT, Matrix Improved_4.10.STEP, Matrix Improved_4.10.STL]
2023-06-19 Updating matrix 4.9 to 4.10
    Changed M8 Tapped holes to 8.4mm through holes and updated engraving
    [Matrix Improved_4.10.SLDPRT]
2023-07-27 Machined gelling mold
    [Machined_BottomMould.SLDPRT, Machined_BottomMould.STEP, Machined_BottomMould.STL]
2023-08-11 Uploading LED mPMT assembly .zip
2023-08-11 Uploading PMT collar files
    [Collar V1.SLDPRT, Collar V1.STEP, Collar V1.STL]
2023-08-11 Uploading MTS Angle Jig .zip
    Increased distance between collimator hole and light
2023-08-11 Uploaded PMT Test Stand .zip
    Adjusted PMT holder to better fit extrusion hole
2023-08-11 Uploading V11 Cups
    Outer and Central Cups without lip
    [central cup rev 11.SLDPRT, central cup rev 11.STEP, central cup rev 11.STL, outer cup rev11.SLDPRT, outer cup rev11.STEP, outer cup rev11.STL]
2023-08-12 Uploading gelling mold .zip
    Gelling molds currently in use (as of Aug 11 2023) includes Blank and Funnel Sides of the gelling molds, V7C Funnel Clamp
